AULAGE/dache/docs/robotac/答辩问答.md

# 答辩问答准备（26 题）

> 原则：**不编数据**。有真机数据的照真机数据说；只有仿真的，开口先说“这是仿真”；没测过的就说没测过、打算怎么测。
> 评委最反感“说得比做得多”。被问到不足时，先承认，再讲原因和下一步。
> 数字出处：程序参数见 `raspberrypi/grasp/config.py`；真机数据以 `build/data.json` 填的为准（bench 测完后把下面【】里的补上）。

---

## 一、方案与创新

**1. 你们的核心创新是什么？和普通的视觉伺服有什么区别？**
- 要点：眼在手上 + **在线自适应**。普通做法要先做相机标定、手眼标定，算出图像误差和关节动作的换算关系（雅可比）；我们不做标定，每走一步都用“实际读数变化 ÷ 动作量”更新灵敏度 J，学到的 J 存文件，下次开机接着用。
- 补一句：三个误差方向分给三套执行机构（竖直→升降轴、方位→底座、深度→底盘/伸出插值），每个方向是一维的 J，所以学得快、好解释。
- 相关文献：无标定视觉伺服（Jägersand 1997）是这一思路的经典工作，我们是在低成本移动操作平台上的工程实现。**不要说“首创”**。

**2. 为什么不用强化学习 / 深度学习做控制？**
- 要在真机上试几千次，会撞坏东西；没有足够准的仿真也训练不出来。
- K230 给的本来就是毫米单位的物理量，闭环控制几步就能收敛；简单方法更容易调试、更可靠。
- 学习用在“该学的地方”：执行机构灵敏度（在线）、落点偏差（仿真里实现了从抓取结果学习）。

**3. 和上一版（STM32 主控、偏差分级）比，到底改进了什么？**
- 总控换成树莓派，三套执行机构由一个状态机统一调度；偏差分级的手调阈值换成自适应控制律。
- 相机从【上一版相机位置，请核对】改到腕部；新增抓取确认、自身干扰识别、多重停车保护；升降轴固件重写（最高速度从约 6.8 mm/s 到 80 mm/s，固件默认值）。
- 开发方法：离线自测 + 仿真回归 + 真机测试矩阵。

**4. 为什么把相机装在手腕上？有什么坏处？**
- 好处：相机跟着执行机构一起动，“动一下看一眼”就是闭环，不需要知道相机和底盘的精确相对位置；离物块越近看得越清楚（测距误差和距离平方成正比）。
- 坏处（主动说）：① 爪子会出现在画面里，可能被当成物块 → K230 屏蔽区域 + 树莓派自身干扰检测；② 伸出抓取时物块离相机太近、看不到，所以抓取是“开环”的，靠对准精度和标定的伸出姿态；③ “抬起来看物块跟不跟着动”的确认方法会被爪子骗 → 改成观察确认。

**5. 三套执行机构会不会互相打架？**
- 不会同时修正同一个方向：每个误差方向只交给一个执行机构。
- 底盘转弯会改变视角 → 用几何前馈：按回传的里程和转角直接算出底座该转多少，相机继续对准。
- 每一步只走预测量的 85%（α = 0.85），宁可多一步也不冲过头。

## 二、算法细节

**6. 灵敏度 J 是什么？怎么学的？会不会学坏？**
- J = 单位动作引起的读数变化。每步 Ĵ = Δe / (u·s)，J ← 0.7·J + 0.3·Ĵ（学习率 0.3）。
- 三道保护：动作太小或读数变化小于噪声的 2 倍不学；Ĵ 和初值符号相反（噪声、打滑、换了目标）不学；|Ĵ| 限制在初值的 1/4~4 倍。所以最坏情况是学得慢，不会学反。

**7. 几何系数 s = 1 + R/d 是什么意思？**
- 底座转动时，相机不一定在转轴上，而是绕转轴走一段弧（半径 R）。物块在深度 d 处，底座转 1°，物块在画面里偏 (1 + R/d)°。这部分几何关系程序直接算，J 只学剩下的偏差。
- 真机标定发现相机几乎就在底座转轴上（R≈0）。

**8. 单目怎么测距？准不准？**
- 已知物块边长 L = 24 mm，D = L·f/√(w·h)，f = 944 px。用 √(w·h) 而不是单边长，减小单边抖动的影响。
- 误差理论：ΔD ≈ D²·Δs/(L·f)。150 mm 时 1 px 框误差约 1 mm，300 mm 时约 4 mm（报告表“单目测距理论误差”）。对准时深度在 150~220 mm，误差在对准容差（10 mm）以内。
- 局限：要知道物块尺寸；换物体要换模型和尺寸参数。**没做过系统的测距精度实测**，被问就如实说“做了理论分析，没有专门的测距精度实验”。

**9. 对准容差是多少？为什么这么定？**
- 方位 1.5°、竖直 4 mm、深度 10 mm（程序参数）。爪子张开比物块宽，横向和竖直要求严，深度有伸出姿态插值兜底所以松一些。

**10. 无底盘时深度怎么办？**
- 深度对不准，就按物块的实际深度，在“近、远”两个标定好的伸出姿态之间插值；目标位置也随深度插值（物块越远在画面里越靠上）。可抓深度约 131~241 mm（标定结果）。

**11. 每次测量取几帧？为什么等 0.25 秒？**
- 动作完后相机在机械臂上会晃，等 0.25 s 稳定；取 5 帧中位数（离目标远时取 3 帧，快一些）。中位数能去掉偶发的跳变帧。

## 三、可靠性与安全

**12. K230 串口断了会怎样？**
- K230 没看到物块时也发心跳帧（D = 0）。连心跳都收不到 = 断线或程序停了，树莓派立即报错停止，不会把“断线”当成“没看到”继续乱找。

**13. 爪子被识别成物块怎么办？**
- 两道防线：K230 端中心落在爪子区域的框直接丢掉（OSD 上红色虚线框可现场看）；树莓派端“动了两步读数几乎不变”判定为看到了自己，立即停止（底盘前进的那一步也检查）。
- 如实说：第一天联调时遇到过一次跟踪器锁住爪子的情况，这是加这两道防线的原因。

**14. 底盘失控怎么办？**
- 厂家底盘固件**没有串口超时停车**（读过固件源码确认），最后一帧是什么速度就一直按什么速度走。所以树莓派这边兜底：50 Hz 持续发送、0.5 s 没新命令自动发 0；程序退出、被 kill、SSH 断开都会先发停车帧；底盘回传断了 0.5 s 内停车报错。
- 这些是在上车前代码审查和底盘预演中，用仿真和假串口复现问题后修的，**没有在真机上故意触发过**。

**15. 怎么判断抓没抓到？会不会误报？**
- 爪子保持闭合退回观察姿态，看原位置还有没有物块；有 = 没抓到 → 松开、后退、重试（最多 3 次）。
- 误报情况：【填 bench 的误报次数；没填就说“测试矩阵里统计了误报，结果见表”】。已知风险：如果物块被碰走但没夹住，观察确认也会以为抓到了。

**16. 升降轴会不会撞顶？**
- 软件限位 44 cm（硬件行程 50 cm）；升降轴下位机意外复位后零点可能错，程序收到复位消息就停下等人确认，不自动接着跑。

## 四、测试与数据

**17. 真机成功率是多少？测了多少次？怎么统计的？**
- 按测试矩阵：近/中/远 × 左/中/右 9 个位置，每次抓完由人确认是否真的抓到（程序判定不算）。
- 结果：【填：总次数 N、真实抓到 M、成功率、平均用时，哪些位置差】。
- 已有记录：11 月 3 日第一天联调，低平台无底盘，15 次中抓到 11 次，每次 15~40 秒（未分位置统计）。
- **如果被追问“只测了这么少？”**：如实说比赛前时间有限，测试矩阵每个位置测了几次；统计意义有限，但每次都是人工确认的真实结果，日志都保留着可以现场看。

**18. 报告里的 95%、94% 是真机数据吗？**
- **不是，是仿真**（默认配置、各 100 次，有底盘 95/100、无底盘 94/100）。仿真只用来比较改动前后有没有变差，不代表真机成功率。仿真器的噪声、回差、滑行参数是按真机现象估计的。

**19. 仿真和真机差多少？仿真可信吗？**
- 如实说：仿真里的物理参数是估计的，不能当真机结果。它的价值是回归测试——每次改代码，同一个随机种子下结果不能变差，并且能复现真机上遇到的问题（比如爪子被当成物块、底盘滑行）。
- 第一天真机 11/15（73%），落点偏差模型调好后仿真“不微调”约 70%，量级一致；这只能说明仿真没偏太远，不能证明更多。

**20. 163 项自测测的是什么？**
- 用“假下位机”测所有驱动的协议收发（K230 帧解析和 CRC、升降轴文本协议、底盘 50 Hz 发送与回传解析、机械臂帧打包），以及自适应伺服、几何前馈、自身干扰检测、抓取确认、仿真回归。底盘的假控制器是照着厂家固件源码写的。全部在电脑上跑，不需要硬件。

**21. 一次抓取要多久？时间花在哪？**
- 第一天联调每次 15~40 秒。各阶段：【填 data.json 各阶段用时；没测就说“主要时间在搜索和对准，对准每一步要等画面稳定再取 5 帧”】。
- 限制因素：K230 约 7 帧/s，每一步测量要几帧。

## 五、不足与展望

**22. 为什么不抓地上的东西？题目里不是说“从地面到桌面”吗？**
- 如实说：这一版把相机移到手腕后，升降轴降到最低再加上腕部下压，还是差一截够不到地面（机械结构限制），所以现在只抓台面上的物块。下一步改机械结构（下移安装位置或加长夹爪）。

**23. 底盘参与的全自动抓取做成了吗？**
- 【按 11/9 联调结果回答】。成功：讲视频 ⑧ 和次数。没成功：如实说代码和安全保护都做了、在仿真和假串口里预演过，但真机联调时间不够，演示以无底盘模式为主。

**24. 物块歪着放能抓吗？换别的物体呢？**
- 夹爪不能绕竖直轴转，歪放的物块成功率低（没有系统测过，不报数字）。换物体需要重新训练检测模型、改测距用的尺寸参数，必要时重新标定伸出姿态。

**25. 成本多少？能推广吗？**
- 【请核对：整机成本】。总控程序只依赖 Python 标准库和 pyserial，硬件都是通用件；自适应伺服换车不用重新标定，适合复制到教学平台。

**26. 落点偏右 4 mm 是怎么回事？怎么解决的？**
- 第一天联调发现落点系统性偏右约 4 mm。可能原因：爪子遮住物块左侧让检测框中心偏右，或底座舵机回差。现在用固定微调补偿（底座约 −1.3°）。
- 还实现了“失败时左右试探 + 从结果学习落点偏差”，仿真里（无底盘、10 台车 × 100 次）从 86.1% 到 87.9%，提升很小、在统计误差附近；【比赛版是否启用、真机效果如何，按实际回答】。
