AULAGE/dache/docs/cloud_tasks/10_k230_ignore_claw.md

# 任务 10：K230 忽略爪子脚区域 + 树莓派 ghost 指纹

## 背景
K230（庐山派，CanMV）装在机械臂腕部（2 号舵机那一节），爪子也在这一节上，所以**爪子相对相机永远不动**。
观察姿态下，爪子的一只脚出现在画面**左侧中间**，大约占画面的 1/60（用户 2026-11-03 在 CanMV IDE 里看到的；
画面是旋转 90° 之后的，`ROTATE_DEG = 90`）。

真机现象：K230 程序（`k230_sdcard/main.py`）里的跟踪器 `Tracker` 偶尔把爪子脚当成物块锁住，之后一直跟着它：
- 底座连续转了 69°，方位角读数一直是 +4.2°
- 升降轴累计降了 10cm，Y 读数一直是 +17~19mm
- 平时识别框是在物块上的（问题是间歇性的）

树莓派端（`raspberrypi/grasp/task.py`）已经有 ghost 检测：动了两次读数几乎不变就停止。但这只是止损，这次抓取就废了。

## 目标
### K230 端（`k230_sdcard/main.py`）
1. 新增配置 `IGNORE_REGIONS`：列表，每项是画面里的一个矩形（**用 0~1 的归一化坐标**，基于显示给用户看的那个旋转后的画面，方便用户按 IDE 画面估），
   默认先填一个覆盖"左侧中间、约 1/60 面积"的区域，并加 `IGNORE_REGIONS_ENABLE` 开关（默认开）
2. 在检测结果进跟踪器之前，丢掉**中心落在忽略区域里**的检测框（`tracker.select` 之前）；跟踪器当前锁定的目标如果进入忽略区域，立即放弃
3. 在 OSD 上把忽略区域画出来（半透明或虚线框），用户在 IDE 里一眼能看到区域对不对
4. 加一个标定辅助：配置 `IGNORE_CALIB_MODE = True` 时，在终端持续打印每个检测框的归一化中心和大小，方便用户在没放物块时看爪子脚被识别成什么样、区域该框多大
5. 注意坐标系：检测框在 AI 分辨率（1280×720）下，旋转后才是用户看到的画面。用离线测试固定"归一化区域 ↔ 原始像素"的换算（参考任务 04 的 `k230_sdcard/tests/` 和 `k230_stub.py`）

### 树莓派端（`raspberrypi/grasp/`）
6. **ghost 指纹**：`align` 判定 ghost 时，把当时的读数（x_deg、y、d）记到 `logs/ghosts.json`；之后测量到和某个指纹很接近的读数（容差可配置）就当作没看到，
   并提示"看到的是之前记录的假目标"。开关 `GHOST_FINGERPRINT`（默认关），白名单
7. 不改串口帧格式（`AA 55 | X | Y | D | CRC8 | 0D`，D=0 是心跳），不改 `ROTATE_DEG` 和坐标约定

## 限制
- 云端没有 K230 和 CanMV 环境：K230 代码只能读代码 + 用 CPython 离线测试纯函数（`ulab.numpy` 和 `numpy` 有差异要注意）
- 改动要小、带开关，方便用户在板子上开关对比

## 交付物
- `k230_sdcard/main.py`、`k230_sdcard/tests/` 新测试
- `raspberrypi/grasp/task.py`、`config.py`、`selftest.py` 改动
- `docs/cloud_tasks/results/10_报告.md`：怎么在 IDE 里确认区域、怎么调大小、**真机验证步骤**
  （例：不放物块、观察姿态下张爪/合爪各看 1 分钟，确认终端里没有出现在忽略区域里的目标；再放物块跑 10 次 `--once --no-chassis`，看 ghost 还出不出现）

## 验收
- `k230_sdcard/tests` 和 `raspberrypi/grasp/selftest.py` 全部通过
- 报告标明"未在真机验证"
