AULAGE/dache/docs/cloud_tasks/README.md

# 云端任务

这些任务**都不需要硬件**，适合交给 Claude Code 云端会话长时间自动跑。
每个任务一个文件，把对应文件的内容（或者"请按 docs/cloud_tasks/0X_xxx.md 执行"）发给云端会话即可。

开始前云端会话会先读仓库根目录的 `CLAUDE.md`（项目结构、协议、编码规则、测试方法）。

| # | 任务 | 价值 | 规模 | 需要真机验证吗 |
|---|---|---|---|---|
| 01 | [控制参数自动搜索](01_param_search.md) | ★★★ 直接产出可用的 `calib.json` 推荐值 | 中（主要是跑仿真） | 结果要真机确认 |
| 02 | [仿真更真实](02_sim_fidelity.md) | ★★★ 让 01 的结果更可信 | 中 | 否 |
| 03 | [底盘固件分析](03_chassis_firmware.md) | ★★ 查清速度平滑、超时、回传字段，改进底盘驱动 | 小 | 改进要真机确认 |
| 04 | [K230 程序审查与提速](04_k230_review.md) | ★★ 帧率是整套系统的瓶颈 | 中 | **必须**真机确认 |
| 05 | [机械臂逆运动学](05_arm_ik.md) | ★★ 不用插值也能抓，范围更大 | 大 | 需要连杆尺寸 |
| 06 | [激光雷达避障探索（设计+仿真）](06_lidar_explore.md) | ★ 以后让车自己往前开去找 | 大 | 必须 |
| 07 | [机械臂最省力的上电姿态（静力学模型）](07_power_on_pose.md) | ★★ 上电不抖、不发热 | 中 | 必须；先填 `inputs/arm_params.json` |
| 08 | [真机试验记录工具 bench.py](08_bench_tool.md) | ★★★ 记录真实结果、按位置统计偏差 | 小 | 工具本身离线可测 |
| 09 | [抓取精度：消回差、左右试探、从结果学习落点偏差、三点插值](09_grasp_accuracy.md) | ★★★ 解决"偏右"和小角度不到位 | 中 | 必须 |
| 10 | [K230 忽略爪子脚区域 + ghost 指纹](10_k230_ignore_claw.md) | ★★★ 解决跟踪器锁住爪子脚 | 中 | 必须 |
| 11 | [动作-响应模型原型（论文核心算法仿真验证）](11_action_response_prototype.md) | ★★★ 论文的概率基线 / 物理先验，见 `docs/论文研究方案.md` v2 | 中 | 只建新文件，可和 08/09/10 并行 |
| 12 | [K230 存图 + 树莓派同步（数据集基础设施）](12_k230_image_logging.md) | ★★★ 论文数据集的图像部分 | 中 | 需要用户加一根同步线（GPIO4） |
| 13 | [抓取提速 + 确认防误报 + 灵敏度学习去偏](13_grasp_speed_verify.md) | ★★★ 每次快几秒、消除"推开当抓到" | 中 | 必须 |
| 14 | [世界模型原型：合成腕部图像上验证"学出本体感知"](14_world_model_synthetic.md) | ★★★ 论文 H1/H2 的第一组结果 | 大 | 需要 torch；CPU 能跑 |
| 15 | [论文文献调研 + 创新点核查 + 期刊分析](15_literature_review.md) | ★★★ 写论文前必须做 | 中 | 只写文档，需要联网 |
| 16 | [比赛演示模式 + 实时网页看板](16_demo_dashboard.md) | ★★★ 拍视频、答辩现场展示 | 中 | 11/14 比赛用 |
| 17 | [上车前代码审查](17_code_review.md) | ★★★ 明天真机前排雷 | 中 | 只修会伤硬件 / 会报错退出的 |
| 18 | [底盘联调预演 + 分步手册](18_chassis_rehearsal.md) | ★★ 11/6 上底盘用 | 中 | 必须 |
| 19 | [比赛材料生成：设计报告 + 答辩 PPT + 概要表（数据驱动，可一键重建）](19_competition_materials.md) | ★★★ 11/14 交材料 | 大 | 模板在 docs/robotac/templates |

**进度**：02、03、04 已完成并合并。**08 已完成并合并**（三个会话都做了 08，采用 `claude/peaceful-turing-w4f9l8` 那份：换行没被改、对原代码改动最小）。09、10、11 也已完成并合并（2026-11-03 晚）。**下一批（2026-11-04）：12、13、14、15 并行**（改的文件互不重叠：12 = K230 程序 + recorder.py；13 = task/config/sim/selftest；14 = research/worldmodel/ 新目录；15 = 只写文档），依据是第一天真机联调（见 `docs/抓取与调试方案.md`）。
01 参数搜索等 09 合并后再做（09 会改仿真的机械爪模型）；05、06、07 不急。

## 给每个任务的通用要求

- 在新分支上做（例如 `cloud/01-param-search`），**不要直接改 main**，完成后开 PR 或者把分支推上来
- 改了 `raspberrypi/grasp/` 就必须跑 `python3 selftest.py`，全部 ✅
- 产出一份中文报告 `docs/cloud_tasks/results/0X_报告.md`：做了什么、数据、结论、**哪些还没在真机验证**
- 不改通信协议、串口、波特率；新功能用 `config.py` 开关控制，默认保持原行为
- STM32 源码是 GBK + CRLF，别转换编码和换行
