AULAGE/dache/docs/论文文献调研.md

# 论文文献调研 + 创新点核查 + 投稿期刊分析（任务 15）

> 对应方案：`docs/论文研究方案.md`（v2，2026-11-03）。分支 `cloud/15-literature`，只写文档，没有改代码和方案。
> 日期：2026-11-03。配套文件：`docs/论文相关工作草稿.md`（相关工作章节草稿）、`docs/references.bib`（只收已核实条目）。

---

## 0 先说清楚：这次是怎么"核实"的（重要）

本次云端会话的网络策略**拦截了 arxiv.org、semanticscholar、openreview 等站点**，`WebFetch` 直接打开原文页面全部失败，
只能用网络搜索工具。所以这里的"核实"**不是读了全文**，而是：

| 标记 | 含义 |
|---|---|
| ✅ 检索核实 | 搜索结果里出现了**原文所在页面**（arXiv 摘要页/PDF、出版社或会议论文集页面、作者单位或官方项目页），标题、作者（至少第一作者）、年份、出处与该页面一致，摘要中的关键句与"一句话贡献"一致。**未读全文** |
| ⚠️ 部分核实 | 只找到二手来源（新闻稿、大学镜像 PDF、引用列表、第三方聚合站），或作者表/出处没对上、不完整 |
| ❌ 未核实 | 没找到能对应的原文页面，只是线索，**不能引用** |

**写论文前必须做的事**：在能上 arXiv / IEEE Xplore 的电脑上，把下表每篇**打开全文**再读一遍，
尤其是第 3 节"创新点核查"里被判为"已做过/部分做过"的最接近工作（NJF、DIJE、Hu 2025、OA-WAM、
"Do You Need Proprioceptive States"、Fiducial Exoskeletons、Park 2024），确认它们**没有**做本文要做的那部分。
文中凡是"据检索未找到"的判断，只代表本次搜索范围内没找到，不等于"没人做过"。

> 如果想让云端会话下次能直接打开原文：在环境设置的 Network access 里把 `arxiv.org`、`export.arxiv.org`、
> `api.semanticscholar.org`、`openreview.net`、`ieeexplore.ieee.org` 加进 Allowed domains
> （说明见 https://code.claude.com/docs/en/cloud-environments#network-access ）。

---

## 1 结论速览（先看这个）

1. **方案第 1 节的一个说法要改**："VLA 几乎都把关节角度当作输入"**不准确**。RT-1/RT-2/OpenVLA 的输入只有图像 + 语言
   （OpenVLA 论文自己写了"单图、没有本体感知输入"是局限），它们输出离散化的末端位姿增量，由机器人自带的、**依赖编码器的低层控制器**执行；
   π0、ACT、Diffusion Policy 才把本体状态作为输入。正确的说法是：**它们要么吃本体感知，要么默认低层执行准确（编码器闭环），两者都不适用于无反馈、有回差的舵机臂**。
2. **"去掉本体感知输入"本身已经有人做了**：Zhao 等 2025（arXiv 2509.18644）提出 State-free Policy，在 π0/ACT/DP 上去掉本体状态输入反而泛化更好。
   但他们的机器人**有准确执行**（相对末端位姿动作由带编码器的控制器执行）。本文的区别要落在"**连执行都不可信**（回差/死区）"上，而不是"不输入关节角"。
3. **"只靠视觉 + 随机命令学会控制自己"已有 Nature 级工作**：Li 等 2025 Nature（Neural Jacobian Fields）不假设机器人的运动学、驱动和传感，
   用多相机看随机命令执行来学控制；Hu/Lin/Lipson 2025 NMI、Chen 2022 Sci. Robot. 用外部相机学自我模型；
   Hu/Chen/Lipson（npj Robotics 2025）甚至用**第一人称相机**学动力学自我模型（四足，非抓取）。
   ⇒ "动作是唯一可信信号、自监督学身体"**作为思想不是新的**，不能当主创新点。
4. **"自身/世界分离"有很长的历史**：Gold & Scassellati 2009（靠"受不受电机控制"自我识别）、DIJE 2025（逐像素雅可比分辨自身/外部运动，**但用了关节传感器读数**、外部相机）、
   世界模型里的 Iso-Dream / Denoised MDP / ACRO（可控/不可控隐变量分离）、OA-WAM 2026（一个机器人槽 + N 个物体槽）。
   **没找到**的是：**眼在手上**（身体部件在画面里静止、世界随动作动——和常见设定正好反过来）+ **无本体感知**（预测的世界运动必须来自学到的执行器模型）下的分离。
5. **最站得住的空白**：**从图像自监督地学执行器迟滞（回差/死区）并把它当作"视觉本体感知"**。检索到的迟滞学习工作要么用关节传感器（ac-RKN、Hwangbo 执行器网络），
   要么用外部 RGBD 测末端（Park 等 RA-L 2024，连续体/缆驱机器人），**没找到**"无关节传感器 + 眼在手上 + 刚性舵机臂回差 + 世界模型"的组合（扩展检索也没找到）。
   ⇒ 建议把论文主线收窄为 **H1（迟滞感知的视觉本体感知）+ H2（眼在手上的自身/世界分离）**，世界模型规划（H3）作下游应用。
6. **期刊**：第一篇（H1+H2，短而准）建议 **RA-L**（官网：首次决定 3 个月内、终稿 6 页不收费，可选 ICRA/IROS 报告）；
   完整系统再投 **T-RO / T-Mech / T-ASE**；**TII 范围不太匹配**（工业信息学），不推荐作首选。IEEE TCDS（认知与发育系统）适合"自我建模"叙事，可作备选。
   分区只查到第三方页面，**投稿前必须到中科院/JCR 官方核对**（见第 4 节）。

---

## 2 文献表

列说明：**关系** = 和本文的关系（支持/对比/基线/空白）；**核实** 见第 0 节。
"一句话贡献"根据检索到的摘要/官方页面写，**不是读全文后的总结**。

### 2.1 视觉-语言-动作模型、模仿学习（重点：对本体感知的依赖）

| # | 标题 | 作者 | 年份 | 出处 | 链接 | 一句话贡献 | 和本文关系 | 核实 |
|---|---|---|---|---|---|---|---|---|
| L01 | RT-1: Robotics Transformer for Real-World Control at Scale | Brohan, A. 等 | 2022 | arXiv | https://arxiv.org/abs/2212.06817 | 13 万条真机示教训练的 Transformer 策略；动作每维离散成 256 档（7 维臂：x,y,z,roll,pitch,yaw,夹爪；3 维底盘；1 维模式） | 输入图像+语言，**不吃关节角**，但输出末端位姿增量由机器人控制器执行 → 默认执行准确 | ✅（作者表未逐一核对） |
| L02 | RT-2: Vision-Language-Action Models Transfer Web Knowledge to Robotic Control | Brohan, A. / Zitkovich, B. 等（各版本排序不同） | 2023 | CoRL 2023, PMLR 229 | https://arxiv.org/abs/2307.15818 | 把动作当作文本 token 和网络图文数据联合训练，得到 VLA；沿用 RT-1 的 256 档动作 | 同上：不吃本体感知，但默认执行准确 | ✅ |
| L03 | OpenVLA: An Open-Source Vision-Language-Action Model | Kim, M. J., Pertsch, K., Karamcheti, S. 等 | 2024 | CoRL 2024 | https://arxiv.org/abs/2406.09246 | 7B 开源 VLA（Llama 2 + DINOv2/SigLIP）；论文自述"只用单张图像、无本体感知输入"是局限 | 修正方案第 1 节的说法：VLA 不一定吃本体感知 | ✅ |
| L04 | π0: A Vision-Language-Action Flow Model for General Robot Control | Black, K. 等（Physical Intelligence） | 2024 | arXiv | https://arxiv.org/abs/2410.24164 | 观测 = 多路图像 + 语言 + **本体状态**；状态和动作 token 走单独的"动作专家"权重，flow matching 出动作 | 典型"本体感知是一等输入"的 VLA，可作 H3 对比（去掉状态输入） | ✅（作者表未逐一核对） |
| L05 | Octo: An Open-Source Generalist Robot Policy | Octo Model Team（Ghosh, D., Walke, H., Pertsch, K. 等） | 2024 | RSS 2024 | https://arxiv.org/abs/2405.12213 | 80 万条 OXE 轨迹预训练的开源通用策略，可微调到新观测（含本体感知）和新动作空间 | 可选基线；说明本体感知在通用策略里是"可选输入" | ✅ |
| L06 | Learning Fine-Grained Bimanual Manipulation with Low-Cost Hardware（ACT / ALOHA） | Zhao, T. Z. 等 | 2023 | RSS 2023 | https://arxiv.org/abs/2304.13705 | 低成本双臂遥操作平台 ALOHA + 动作分块 Transformer（ACT），10 分钟示教达到 80~90% | H3 基线；"低成本"但**有关节位置反馈**（两台 ViperX 6 自由度臂，据二手资料），输入含关节位置（据二手资料，需读原文第 III 节确认） | ✅（输入细节未从原文核对） |
| L07 | Diffusion Policy: Visuomotor Policy Learning via Action Diffusion | Chi, C., Feng, S., Du, Y. 等 | 2023/2024 | RSS 2023；IJRR 2024 | https://arxiv.org/abs/2303.04137 | 把策略写成条件去噪扩散过程，处理多峰动作 | H3 基线 | ✅ |
| L08 | Do You Need Proprioceptive States in Visuomotor Policies? | Zhao, J., Lu, W., Zhang, D. 等（13 人） | 2025 | arXiv | https://arxiv.org/abs/2509.18644 | 发现加本体状态让策略过拟合训练轨迹；去掉状态（State-free Policy，相对末端动作 + 双腕部广角相机）后高度泛化 0%→85%，在 π0/ACT/DP 上都成立 | **最接近"不用本体感知"的模仿学习工作**；区别：他们执行准确，本文执行不可信 | ✅ |
| L09 | Fighting Copycat Agents in Behavioral Cloning from Observation Histories | Wen, C., Lin, J., Darrell, T., Jayaraman, D., Gao, Y. | 2020 | NeurIPS 2020 | https://papers.nips.cc/paper/2020/hash/1b113258af3968aaf3969ca67e744ff8-Abstract.html | 带历史的行为克隆会"抄上一步动作"（copycat），提出对抗表示去掉多余的前一动作信息 | 警示：本文的迟滞 GRU 输入**命令历史**，训练策略时同样有 copycat 风险，要做消融 | ✅ |
| L10 | Open X-Embodiment: Robotic Learning Datasets and RT-X Models | Open X-Embodiment Collaboration | 2024 | ICRA 2024 | https://arxiv.org/abs/2310.08864 | 22 种机器人、100 万+ 轨迹的合并数据集，训练 RT-X | "首个无本体感知数据集"说法要对照它（见 3.9） | ✅ |
| L11 | DROID: A Large-Scale In-The-Wild Robot Manipulation Dataset | Khazatsky, A., Pertsch, K. 等 | 2024 | RSS 2024 | https://arxiv.org/abs/2403.12945 | 7.6 万条（RSS 页写 6.5 万）野外 Franka 轨迹，三路同步相机 + 标定 + 深度 | 同上；高端臂、带完整状态 | ✅ |
| L12 | Mobile ALOHA: Learning Bimanual Mobile Manipulation with Low-Cost Whole-Body Teleoperation | Fu, Z., Zhao, T. Z., Finn, C. | 2024 | CoRL 2024, PMLR 270 | https://arxiv.org/abs/2401.02117 | ALOHA 装到轮式底盘上做全身遥操作；与静态 ALOHA 数据联合训练提升移动操作 | 低成本**移动**操作的代表；仍有编码器（整机约 3.2 万美元，据新闻稿） | ✅ |

### 2.2 世界模型（Dreamer、TD-MPC、视频预测类）

| # | 标题 | 作者 | 年份 | 出处 | 链接 | 一句话贡献 | 和本文关系 | 核实 |
|---|---|---|---|---|---|---|---|---|
| L13 | Learning Latent Dynamics for Planning from Pixels（PlaNet） | Hafner, D. 等 | 2019 | ICML 2019 | https://arxiv.org/abs/1811.04551 | 确定性+随机隐状态动力学（RSSM 雏形），隐空间在线规划 | 隐空间 CEM 规划的来源；**RSSM 的确定性隐状态本身就有记忆**——审稿人会问"迟滞 GRU 和它有何不同" | ✅ |
| L14 | Dream to Control: Learning Behaviors by Latent Imagination（Dreamer） | Hafner, D., Lillicrap, T., Ba, J., Norouzi, M. | 2020 | ICLR 2020 | https://arxiv.org/abs/1912.01603 | 在学到的隐空间里想象轨迹训练 actor-critic | H3 基线（无结构先验） | ✅ |
| L15 | Mastering diverse control tasks through world models（DreamerV3） | Hafner, D., Pasukonis, J., Ba, J., Lillicrap, T. | 2025 | Nature（arXiv 2301.04104 题为 Mastering Diverse Domains through World Models） | https://arxiv.org/abs/2301.04104 | 单一配置在 150+ 任务上超过专用方法 | H3 基线首选（开源、稳定） | ✅ |
| L16 | DayDreamer: World Models for Physical Robot Learning | Wu, P., Escontrela, A., Hafner, D., Abbeel, P., Goldberg, K. | 2022/2023 | CoRL 2022, PMLR 205 | https://arxiv.org/abs/2206.14176 | Dreamer 直接在 4 台真机上在线学习，无仿真器 | 证明真机世界模型可行；它的机器人都有本体感知 | ✅ |
| L17 | Temporal Difference Learning for Model Predictive Control（TD-MPC） | Hansen, N., Wang, X., Su, H. | 2022 | ICML 2022, PMLR 162 | https://arxiv.org/abs/2203.04955 | 任务导向隐动力学 + 终端价值函数做短视距 MPC | H3 基线 | ✅ |
| L18 | TD-MPC2: Scalable, Robust World Models for Continuous Control | Hansen, N., Su, H., Wang, X. | 2024 | ICLR 2024 | https://arxiv.org/abs/2310.16828 | 无解码器隐空间规划，104 个任务单一超参 | H3 基线 | ✅ |
| L19 | Deep Visual Foresight for Planning Robot Motion | Finn, C., Levine, S. | 2016/2017 | arXiv（ICRA 2017，出处未从原页核实） | https://arxiv.org/abs/1610.00696 | 动作条件视频预测 + MPC 推物体，**不需要标定相机、不需要精确传感与执行** | 视频预测类世界模型的源头；"不需要精确执行"这一点与本文相关，但没有显式建模迟滞 | ✅ |
| L20 | Visual Foresight: Model-Based Deep RL for Vision-Based Robotic Control | Ebert, F., Finn, C., Dasari, S., Xie, A., Lee, A., Levine, S. | 2018 | arXiv | https://arxiv.org/abs/1812.00568 | 视频预测模型 + 采样规划（visual MPC）的系统总结 | 同上 | ✅ |
| L21 | Learning Interactive Real-World Simulators（UniSim） | Yang, M., Du, Y., Ghasemipour, K., Tompson, J., Schuurmans, D., Abbeel, P. | 2024 | ICLR 2024 | https://arxiv.org/abs/2310.06114 | 动作条件的生成式视频模拟器，训练的策略零样本迁移到真机 | 视频预测类代表；本文是小模型、边缘部署，不和它比规模 | ✅ |
| L22 | DINO-WM: World Models on Pre-trained Visual Features enable Zero-shot Planning | Zhou, G., Pan, H., LeCun, Y., Pinto, L. | 2025 | ICML 2025, PMLR 267 | https://arxiv.org/abs/2411.04983 | 在冻结的 DINOv2 patch 特征上学动力学，测试时零样本规划 | 编码器可以用预训练特征的证据（本文槽位编码器的备选） | ✅ |
| L23 | Iso-Dream: Isolating and Leveraging Noncontrollable Visual Dynamics in World Models | Pan, M., Zhu, X., Wang, Y., Yang, X. | 2022 | NeurIPS 2022 | https://arxiv.org/abs/2205.13817 | 用逆动力学把可控/不可控动态分到两个分支 | **自身/世界分离的最接近世界模型工作之一**；它分的是"可控/不可控"，不是"与相机固连/随相机运动" | ✅ |
| L24 | Denoised MDPs: Learning World Models Better Than the World Itself | Wang, T., Du, S. S., Torralba, A., Isola, P., Zhang, A., Tian, Y. | 2022 | ICML 2022, PMLR 162 | https://proceedings.mlr.press/v162/wang22c/wang22c.pdf | 按"可控 × 与奖励相关"把信息分四类，只保留两者都有的 | 同上 | ✅ |
| L25 | Principled Offline RL in the Presence of Rich Exogenous Information（ACRO；arXiv 题 Agent-Controller Representations） | Islam, R., Tomar, M., Lamb, A. 等 | 2023 | ICML 2023, PMLR 202 | https://arxiv.org/abs/2211.00164 | 多步逆模型学"智能体可控状态"，去掉外生噪声 | 同上；思路可借鉴为"动作可解释的部分" | ✅ |
| L26 | Action-Conditional Recurrent Kalman Networks for Forward and Inverse Dynamics Learning | Shaj, V. 等 | 2020 | CoRL 2020, PMLR 155 | https://arxiv.org/abs/2010.10201 | 动作条件的循环卡尔曼网络学正/逆动力学，在液压臂（**有迟滞**）上大幅优于解析模型 | **"循环隐状态学迟滞"最接近的工作**；但输入是关节位置测量 + 电流，**有本体感知** | ✅ |

### 2.3 机器人自我建模 / 自我识别

| # | 标题 | 作者 | 年份 | 出处 | 链接 | 一句话贡献 | 和本文关系 | 核实 |
|---|---|---|---|---|---|---|---|---|
| L27 | Resilient Machines Through Continuous Self-Modeling | Bongard, J., Zykov, V., Lipson, H. | 2006 | Science 314(5802):1118–1121 | https://doi.org/10.1126/science.1133687 | 四足机器人通过少量自主动作推断自身拓扑，受损后重建步态 | "通过自主动作学身体"思想的源头 | ⚠️（只找到新闻和实验室页面，DOI 来自二手页面） |
| L28 | Task-agnostic self-modeling machines | Kwiatkowski, R., Lipson, H. | 2019 | Science Robotics 4, eaau9354 | https://doi.org/10.1126/scirobotics.eaau9354 | 4 自由度臂随机运动约 1000 条轨迹学自我模型，闭环抓放 100%、开环 44% | 同上；有关节读数 | ⚠️（只找到哥大新闻稿） |
| L29 | Full-Body Visual Self-Modeling of Robot Morphologies | Chen, B., Kwiatkowski, R., Vondrick, C., Lipson, H. | 2022 | Science Robotics（DOI 10.1126/scirobotics.abn1944）；arXiv 2111.06389 | https://robot-morphology.cs.columbia.edu/ | 5 台外部相机，学"给定关节状态时身体占据哪些空间"的查询式自我模型 | 外部相机 + 以关节状态为条件 → 有本体感知；本文是眼在手上、无本体感知 | ✅ |
| L30 | Teaching Robots to Build Simulations of Themselves | Hu, Y., Lin, J., Lipson, H. | 2025 | Nature Machine Intelligence；arXiv 2311.12151 | https://arxiv.org/abs/2311.12151 | 单个普通 2D 相机看短视频，自监督学形态、运动学和运动控制 | 外部相机的自我建模 | ✅ |
| L31 | Egocentric Visual Self-Modeling for Autonomous Robot Dynamics Prediction and Adaptation | Hu, Y., Chen, B., Lipson, H. | 2025 | npj Robotics 3:14（据第三方 PDF）；arXiv 2207.03386 | https://arxiv.org/abs/2207.03386 | **单个第一人称相机**、随机运动，自监督学"以电机命令为条件"的动力学自我模型，12 自由度四足；精度超过用 IMU 的模型 | **"第一人称相机 + 命令条件自我模型"已被做过**（但是腿式移动、没有抓取、没有迟滞建模） | ✅（arXiv）；npj 版本 ⚠️ |
| L32 | Controlling diverse robots by inferring Jacobian fields with deep networks（Neural Jacobian Fields） | Li, S. L., Zhang, A., Chen, B., Matusik, H., Liu, C., Rus, D., Sitzmann, V. | 2025 | Nature（DOI 10.1038/s41586-025-09170-0）；arXiv 2407.08722 | https://arxiv.org/abs/2407.08722 | 从视频流学"视觉运动雅可比场"，**不假设运动学、材料、驱动、传感**；训练数据来自观察随机命令的执行；用于软硬混合手等 | **最接近"无本体感知 + 只靠视觉和命令学控制"的工作**；区别：外部多相机、不显式建模回差的历史依赖、不是眼在手上 | ✅ |
| L33 | DIJE: Dense Image Jacobian Estimation for Robust Robotic Self-Recognition and Visual Servoing | Toshimitsu, Y., Kawaharazuka, K., Miki, A., Okada, K., Inaba, M. | 2025 | arXiv | https://arxiv.org/abs/2507.00446 | 光流 + 简化卡尔曼滤波逐像素估计图像雅可比，区分机器人自身运动和外部运动，用于视觉伺服（肌肉骨骼机器人） | H2 基线；**它用了本体关节传感器读数**（摘要原话 "proprioceptive joint sensor data"），外部视角 | ✅ |
| L34 | Using Probabilistic Reasoning over Time to Self-Recognize | Gold, K., Scassellati, B. | 2009 | Robotics and Autonomous Systems 57(5):384–392 | https://scazlab.yale.edu/journal-articles | 比较三个动态贝叶斯模型的似然，判断画面里的东西是否受自己电机控制，从而认出自己（含镜像） | **v1 概率模型 P(T/S/D) 的直接前身**，必须引用；区别：外部视角、有关节信息 | ⚠️（Yale 实验室页 + 非官方 PDF 副本，未见出版社页） |
| L35 | Adaptive Robot Body Learning and Estimation Through Predictive Coding | Lanillos, P., Cheng, G. | 2018 | IROS 2018, pp. 4083–4090 | https://arxiv.org/abs/1805.03104 | 高斯过程学身体前向模型，最小化自由能估计身体状态（视觉+触觉+本体感知） | 身体估计的预测编码路线 | ✅ |
| L36 | Body Schema in Robotics: A Review | Hoffmann, M., Marques, H. G., Arieta, A. H., Sumioka, H., Lungarella, M., Pfeifer, R. | 2010 | IEEE Trans. Autonomous Mental Development 2(4):304–324 | https://doi.org/10.1109/TAMD.2010.2086454 | 身体图式在生物与机器人中的综述 | 背景综述（TAMD 是 TCDS 的前身） | ⚠️（只找到大学镜像 PDF） |
| L37 | Single-view robot pose and joint angle estimation via render & compare（RoboPose） | Labbé, Y., Carpentier, J., Aubry, M., Sivic, J. | 2021 | CVPR 2021 | https://www.di.ens.fr/willow/research/robopose/ | 单张 RGB 估计已知机器人的关节角和相机位姿 | "视觉本体感知"的外部相机路线；需要机器人 3D 模型 | ✅ |
| L38 | Robust Visual Embodiment: How Robots Discover Their Bodies in Real Environments | Rezvani, S., Mahmood, A. J., Chhabra, R. | 2025 | arXiv | https://arxiv.org/abs/2510.03677 | 运动分割 + 语义分割在杂乱场景中找出机器人身体，IoU 最多提升 4 倍 | 真实场景自身分割；外部视角 | ✅ |
| L39 | Where is my hand? Deep hand segmentation for visual self-recognition in humanoid robots | Almeida, A., Vicente, P., Bernardino, A. | 2021 | arXiv（期刊出处未查到） | https://arxiv.org/abs/2102.04750 | 深度分割网络在人形机器人头部相机里识别自己的手 | 自身识别；监督分割 | ✅ |
| L40 | Proprioceptive-visual correspondence enables self-other distinction in humanoid robots | Chen, Y. 等（作者表来自 alphaXiv） | 2026 | arXiv | https://arxiv.org/abs/2606.13222 | 用本体感知-视觉对应做自他区分，并以此自监督地引导出自我模型 | 很新、很接近 H2，**但依赖本体感知** | ⚠️（作者表未从 arXiv 页核对） |
| L41 | Self-Supervised Object-in-Gripper Segmentation from Robotic Motions | Boerdijk, W., Sundermeyer, M., Durner, M., Triebel, R. | 2020 | CoRL 2020, PMLR 155 | https://arxiv.org/abs/2002.04487 | 机器人拿着物体在相机前运动，用光流等运动线索自监督分出背景/机械臂/被抓物体 | 用"自身运动"做分割的直接先例（外部相机） | ✅ |

### 2.4 物体中心表示（Slot Attention 及机器人应用）

| # | 标题 | 作者 | 年份 | 出处 | 链接 | 一句话贡献 | 和本文关系 | 核实 |
|---|---|---|---|---|---|---|---|---|
| L42 | Object-Centric Learning with Slot Attention | Locatello, F., Weissenborn, D., Unterthiner, T., Mahendran, A., Heigold, G., Uszkoreit, J., Dosovitskiy, A., Kipf, T. | 2020 | NeurIPS 2020 | https://arxiv.org/abs/2006.15055 | 竞争式迭代注意力把特征分配到 K 个槽位 | 方案 3.2 编码器 | ✅ |
| L43 | Conditional Object-Centric Learning from Video（SAVi） | Kipf, T. 等 | 2022 | ICLR 2022 | https://arxiv.org/abs/2111.12594 | 视频版 Slot Attention，光流预测 + 首帧位置提示做分割与跟踪 | 槽位时序跟踪；"首帧提示"可用于指定爪子槽 | ✅ |
| L44 | Contrastive Learning of Structured World Models（C-SWM） | Kipf, T., van der Pol, E., Welling, M. | 2020 | ICLR 2020 | https://arxiv.org/abs/1911.12247 | 对比损失训练的物体级动作条件世界模型（GNN），不靠像素重建 | 方案 3.2 的"对比损失"可直接借鉴 | ✅ |
| L45 | FOCUS: Object-Centric World Models for Robotics Manipulation | Ferraro, S., Mazzaglia, P., Verbelen, T., Dhoedt, B. | 2023/2025 | NeurIPS 2023 IMOL 研讨会；Frontiers in Neurorobotics 2025 | https://arxiv.org/abs/2307.02427 | 物体中心世界模型 + 物体级探索奖励，有 Franka 真机演示 | 物体中心世界模型在机器人上的先例 | ✅ |
| L46 | SOLD: Slot Object-Centric Latent Dynamics Models for Relational Manipulation Learning from Pixels | Mosbach, M., Ewertz, J. N., Villar-Corrales, A., Behnke, S. | 2025 | ICML 2025, PMLR 267 | https://arxiv.org/abs/2410.08822 | 槽位隐动力学的模型强化学习，多物体仿真操作上超过 DreamerV3 和 TD-MPC2 | **方案 3.2 结构上已被做过**（仿真）；本文的区别只能在"自身/世界先验 + 迟滞 + 真机无本体感知" | ✅ |
| L47 | Is an object-centric representation beneficial for robotic manipulation? | Chapin, A., Dellandrea, E., Chen, L. | 2025 | ROBOVIS 2025 | https://arxiv.org/abs/2506.19408 | 比较物体中心与全局表示；槽位能分出背景、机器人和物体 | 槽位里"机器人"会自然成为一个槽的证据 | ✅ |
| L48 | OA-WAM: Object-Addressable World Action Model for Robust Robot Manipulation | Liu, Y., Ding, W. 等（10 人） | 2026 | arXiv | https://arxiv.org/abs/2605.06481 | 每帧分解为 1 个机器人槽 + N 个物体槽，世界头预测下一帧槽状态，同时输出动作块；感知模块用冻结的 SAM 3 / DINOv3 | **"机器人槽/物体槽"结构已被做过**；区别：它用大模型分割、外部视角、无迟滞 | ✅（摘要；数字来自聚合站未核） |
| L49 | Slot-MPC: Goal-Conditioned Model Predictive Control with Object-Centric Representations | （作者未查到） | 2026 | arXiv | https://arxiv.org/abs/2605.14937 | 槽位动作条件动力学 + MPC（仿真） | 槽位 + MPC 已有人做 | ⚠️（只有标题和摘要片段） |

### 2.5 交互式感知、自监督机器人学习

| # | 标题 | 作者 | 年份 | 出处 | 链接 | 一句话贡献 | 和本文关系 | 核实 |
|---|---|---|---|---|---|---|---|---|
| L50 | Interactive Perception: Leveraging Action in Perception and Perception in Action | Bohg, J., Hausman, K., Sankaran, B., Brock, O., Kragic, D., Schaal, S., Sukhatme, G. | 2017 | IEEE T-RO 33:1273–1291 | https://arxiv.org/abs/1604.03670 | 交互式感知综述：利用"传感数据和动作参数之间的规律"解释感知 | 本文"以动作为测量"的理论归属 | ✅ |
| L51 | Learning to Poke by Poking: Experiential Learning of Intuitive Physics | Agrawal, P., Nair, A., Abbeel, P., Malik, J., Levine, S. | 2016 | arXiv（NeurIPS 2016，出处未从原页核实） | https://arxiv.org/abs/1606.07419 | Baxter 随机戳物体 5 万+ 次，联合学正/逆模型 | 自主探索数据收集的先例 | ✅ |
| L52 | Supersizing Self-supervision: Learning to Grasp from 50K Tries and 700 Robot Hours | Pinto, L., Gupta, A. | 2016 | ICRA 2016, pp. 3406–3413 | https://arxiv.org/abs/1509.06825 | 5 万次试抓的自监督抓取数据 | 抓取成败作自监督标签的先例 | ✅ |
| L53 | Learning Hand-Eye Coordination for Robotic Grasping with Deep Learning and Large-Scale Data Collection | Levine, S. 等 | 2016/2018 | ISER 2016 扩展版；arXiv（IJRR 2018 未核实） | https://arxiv.org/abs/1603.02199 | 80 万次抓取学"动作成功概率"网络并用于伺服，**不依赖相机标定和当前位姿** | 方案"奖励头 + 规划"的先例；但机械臂执行准确 | ✅ |
| L54 | Learning Instance Segmentation by Interaction | Pathak, D., Shentu, Y., Chen, D., Agrawal, P., Darrell, T., Levine, S., Malik, J. | 2018 | CVPR Workshops 2018 | https://arxiv.org/abs/1806.08354 | 机器人推/抓物体，自监督学实例分割 | 交互式分割；本文是**不碰物体**、只靠自身运动 | ✅ |
| L55 | Curiosity-driven Exploration by Self-supervised Prediction | Pathak, D., Agrawal, P., Efros, A. A., Darrell, T. | 2017 | ICML 2017 | https://arxiv.org/abs/1705.05363 | 用逆动力学特征空间里的预测误差作好奇心奖励 | 方案 3.1 好奇心探索 | ✅ |
| L56 | Robot Learning in Homes: Improving Generalization and Reducing Dataset Bias | Gupta, A., Murali, A., Gandhi, D., Pinto, L. | 2018 | NeurIPS 2018 | https://arxiv.org/abs/1807.07049 | 低于 3000 美元的移动机械臂在家里采 2.8 万次抓取；**把"执行不准、标定误差"带来的标签噪声建模成隐变量** | **低成本 + 执行噪声当隐变量**的重要先例，必须引用并区分（它是整体噪声，不是有历史依赖的迟滞） | ✅ |

### 2.6 无标定视觉伺服、在线雅可比估计、回差辨识与补偿

| # | 标题 | 作者 | 年份 | 出处 | 链接 | 一句话贡献 | 和本文关系 | 核实 |
|---|---|---|---|---|---|---|---|---|
| L57 | Versatile Visual Servoing without Knowledge of True Jacobian | Hosoda, K., Asada, M. | 1994 | IROS 1994, vol.1 pp.186–193 | https://doi.org/10.1109/IROS.1994.407392 | 在线估计图像雅可比的无标定视觉伺服（后人引为 Broyden/加权递推最小二乘） | 现系统 `servo.AdaptiveAxis` 的理论来源 | ⚠️（只找到引用列表） |
| L58 | Experimental Evaluation of Uncalibrated Visual Servoing for Precision Manipulation | Jägersand, M., Fuentes, O., Nelson, R. | 1997 | ICRA 1997, vol.4 pp.2874–2880 | https://www.cs.rochester.edu/users/faculty/nelson/pubs/abstracts/1997_icra_servo.html | 3/6/12 自由度下在线估计雅可比的自适应视觉伺服实验评估 | 同上 | ✅ |
| L59 | Uncalibrated Dynamic Visual Servoing | Piepmeier, J. A., McMurray, G. V., Lipkin, H. | 2004 | IEEE Trans. Robot. Autom. 20(1):143–147 | https://repository.gatech.edu/entities/publication/8d3fd830-12e6-4d84-ae31-58a6b0e6ef85 | 动态拟牛顿法 + 动态递推最小二乘在线估计复合雅可比 | 同上 | ✅ |
| L60 | Visual Servo Control, Part I: Basic Approaches | Chaumette, F., Hutchinson, S. | 2006 | IEEE Robot. Autom. Mag. 13(4):82–90 | https://www.irisa.fr/lagadic/publi/publi/Chaumette06a-eng.html | 视觉伺服基础教程（IBVS/PBVS） | 背景 | ✅ |
| L61 | Controlling Mechanical Systems with Backlash — A Survey | Nordin, M., Gutman, P.-O. | 2002 | Automatica 38(10):1633–1649 | https://www.math.kth.se/optsyst/seminar/nordin.html （二手：KTH 研讨会页，提到该综述出自 Nordin 博士论文；原文页未找到） | 回差控制综述 | 回差模型（死区+间隙）背景 | ⚠️（只找到引用；出版社页和 DOI 未找到） |
| L62 | Adaptive Control of Systems with Actuator and Sensor Nonlinearities | Tao, G., Kokotović, P. V. | 1996 | Wiley（专著） | https://gov.wiley.com/WileyCDA/WileyTitle/productCd-047115654X,descCd-authorInfo.html | 用自适应逆统一处理死区、回差、迟滞 | 方案"逆迟滞补偿"的经典来源 | ✅ |
| L63 | Learning agile and dynamic motor skills for legged robots | Hwangbo, J., Lee, J., Dosovitskiy, A., Bellicoso, D., Tsounis, V., Koltun, V., Hutter, M. | 2019 | Science Robotics 4(26), eaau5872 | https://arxiv.org/abs/1901.08652 | 用神经网络学执行器模型（据二手资料输入为位置误差和速度的历史）做仿真到真机迁移 | "从历史学执行器"的先例；用关节编码器 | ✅（执行器网络输入细节未从原文核对） |
| L64 | Using Neural Networks to Model Hysteretic Kinematics in Tendon-Actuated Continuum Robots | Wang, Y. 等（6 人） | 2024 | arXiv（会议论文） | https://arxiv.org/abs/2404.07168 | 比较前馈、带历史缓冲的前馈和 LSTM 学缆驱连续体机器人迟滞 | 用历史学迟滞（连续体、有测量） | ⚠️（作者只核到第一作者） |
| L65 | Hysteresis Compensation of Flexible Continuum Manipulator using RGBD Sensing and Temporal Convolutional Network | Park 等（据检索摘要） | 2024 | IEEE RA-L 9(7):6091–6098 | https://arxiv.org/abs/2402.11319 | 用外部 RGBD 测量 + TCN 学迟滞并补偿，跟踪误差降 61% | **"用视觉测量学迟滞"的最接近工作**；区别：外部 RGBD 看末端、连续体机器人、不是世界模型 | ⚠️（作者表未核对） |
| L66 | Accounting for Hysteresis in the Forward Kinematics of Nonlinearly-Routed Tendon-Driven Continuum Robots via a Learned Deep Decoder Network | （作者未核对） | 2024 | IEEE RA-L 9(11)（据检索摘要） | https://arxiv.org/abs/2404.03816 | 以"当前+之前的缆位移"为输入解码整机形状，处理迟滞 | 同上 | ⚠️ |

### 2.7 低成本机器人学习、无编码器/无本体感知

| # | 标题 | 作者 | 年份 | 出处 | 链接 | 一句话贡献 | 和本文关系 | 核实 |
|---|---|---|---|---|---|---|---|---|
| L67 | LeRobot: An Open-Source Library for End-to-End Robot Learning | Cadene, R. 等（17 人） | 2026 | ICLR 2026 | https://arxiv.org/abs/2602.22818 | 从电机通信到数据集格式的开源机器人学习全栈，支持低成本硬件 | 本文数据集可用 LeRobotDataset 格式发布，方便别人复用 | ✅ |
| L68 | SO-ARM100 / SO-101（开源低成本机械臂） | TheRobotStudio 与 Hugging Face | 2024– | GitHub | https://github.com/TheRobotStudio/SO-ARM100 | 约 100~200 美元的 6 自由度臂，Feetech STS3215 总线舵机（**舵机自带位置反馈**） | 方案泛化实验的第二台臂；"去掉编码器读数"是人为设定 | ⚠️（只找到社区 fork 和二手页面） |
| L69 | CRAVES: Controlling Robotic Arm with a Vision-based Economic System | Zuo, Y., Qiu, W., Xie, L., Zhong, F., Wang, Y., Yuille, A. L. | 2019 | CVPR 2019 | https://arxiv.org/abs/1812.00725 | 不到 40 美元、**没有任何传感器**的 OWI-535 臂，只靠外部相机关键点估 3D 位姿来控制 | **"无传感器低成本臂靠视觉控制"已有先例**；区别：外部相机、仿真合成数据训练位姿估计、无迟滞建模、不是自监督 | ✅ |
| L70 | Latent Representations for Visual Proprioception in Inexpensive Robots | Sheikholeslami, S., Bölöni, L. | 2025 | arXiv | https://arxiv.org/abs/2504.14634 | 未标定外部低分辨率相机 + 单次回归，估计廉价 6 自由度臂（Lynxmotion AL5D）的关节构型 | **"廉价臂的视觉本体感知"已有人提**；区别：外部相机、监督回归（需要关节真值训练）、不处理回差 | ✅ |
| L71 | Fiducial Exoskeletons: Image-Centric Robot State Estimation | Smith, C., Van Hoorick, B., Guizilini, V., Wang, Y. | 2026 | arXiv | https://arxiv.org/abs/2601.08034 | 每节连杆装 3D 打印标记，单张 RGB 估各连杆 6D 位姿；在 100 美元 SO-100 上末端估计误差比正运动学降约 75%、控制误差降约 45% | **说明低成本臂的编码器/正运动学确实不准**（支持本文动机）；区别：外部相机 + 标记 | ✅ |
| L72 | Real-time Soft Body 3D Proprioception via Deep Vision-based Sensing | Wang, R., Wang, S., Du, S., Xiao, E., Yuan, W., Feng, C. | 2020 | IEEE RA-L 5(2):3382–3389 | https://arxiv.org/abs/1904.03820 | 软体内置相机 + CNN 实时重建 3D 形状（"视觉本体感知"） | "视觉本体感知"一词在软体机器人中的用法 | ✅ |
| L73 | Vision-guided state estimation and control of robotic manipulator（无本体传感器的单目状态估计） | Ortenzi, V. 等 | 2016 | IROS 2016（据伯明翰大学页面） | https://research.birmingham.ac.uk/en/publications/vision-guided-state-estimation-and-control-of-robotic-manipulator | 单目相机跟踪 + 运动学模型估计构型，面向恶劣环境 | 早期"无本体传感器"先例 | ⚠️ |
| L74 | （线索）H₂Arm：无编码器缆驱臂、唯一反馈是腕部相机、行为克隆 | 未查到 | 2022 | Springer（DOI 片段 s41315-022-00262-y） | https://link.springer.com/article/10.1007/s41315-022-00262-y | 据检索摘要：电机无位置传感器，唯一反馈是腕部低质量相机，用行为克隆 | **如果属实，是"无编码器 + 眼在手上"最接近的先例，必须读原文** | ❌ 未核实 |
| L75 | （线索）Simultaneously learning to recognize and control a low-cost robotic arm | 未查到 | — | Image and Vision Computing（ISSN 0262-8856，据第三方） | https://www.datalearner.com/academic/journal-papers/0262-8856/volumes-and-issues/246/paper-detail/88217 | 据第三方摘要：同时学低成本臂的外观（爪子识别）和控制（雅可比估计、LWPR） | 和 H2 + 在线雅可比都相关，必须读原文 | ❌ 未核实 |
| L76 | （线索）Behavior Cloning for Active Perception with Low-Resolution Egocentric Vision | Bilic, Chen, Bölöni（据检索） | 2026 | arXiv | https://arxiv.org/abs/2605.14106 | 低成本臂 + 腕部低分辨率 RGB 相机的行为克隆 | 低成本眼在手上 | ⚠️ |

### 2.8 眼在手上相机与自遮挡

| # | 标题 | 作者 | 年份 | 出处 | 链接 | 一句话贡献 | 和本文关系 | 核实 |
|---|---|---|---|---|---|---|---|---|
| L77 | Vision-Based Manipulators Need to Also See from Their Hands | Hsu, K., Kim, M. J., Rafailov, R., Wu, J., Finn, C. | 2022 | ICLR 2022（oral） | https://arxiv.org/abs/2203.12677 | 眼在手上视角可观测性更差，但训练效率和分布外泛化更好；第三人称视角用信息瓶颈正则 | 眼在手上的正面证据 | ✅ |
| L78 | ManiSkill3（附带观察） | — | 2024 | arXiv 2410.00425 | https://arxiv.org/abs/2410.00425 | 据检索摘要：相机角度和夹爪连杆遮住方块，策略难以判断是否抓住 | 夹爪自遮挡影响学习的一个旁证 | ⚠️（只有片段） |
| — | （空白） | — | — | — | — | **没找到**专门研究"眼在手上时，固定在画面里的爪子部件被检测器当成目标 / 遮挡目标导致检测框中心系统偏移"的论文（两次检索：标准 + 扩展） | 本文 H2 与"遮挡感知"小节的空白，但属于"据检索未找到" | — |

> 另外在检索中遇到但没核实、没列入表的：REPLAB（低成本可复现臂平台，arXiv 1905.07447）、NeuralActuator（arXiv 2607.11734，用关节遥测学齿轮回差/摩擦）。写作时可补查。

---

## 3 创新点核查（逐条对照方案第 2、3 节）

判断：**已被做过** / **部分做过** / **没找到**（= 本次检索范围内没找到，需人工复核）。

| # | 方案中的创新点（原文位置） | 最接近的已有工作 | 判断 | 调整建议 |
|---|---|---|---|---|
| C1 | 问题设定：没有关节反馈的低成本机器人用不了现有具身方法（§1） | L01–L03（VLA 不吃本体感知，但默认执行准确）、L08（去掉本体状态输入反而更好）、L69/L70/L71（无传感器/廉价臂的视觉状态估计）、L32（NJF 不假设传感） | **部分做过** | ①改写 §1："几乎都把关节角当输入"→"要么以本体状态为输入，要么默认低层执行准确（编码器闭环）"。②主动引用 L08，把它当**支持证据**："连高端臂上去掉状态输入都更好，说明视觉足够；但执行不可信时问题变了"。③把设定精确定义为**三者同时成立**：无关节反馈 + 历史依赖的执行误差（回差/死区）+ 相机装在执行链末端（眼在手上）。这三者同时成立的工作没找到 |
| C2 | "动作是唯一可信的信号"，靠自己的动作和画面自监督学身体（§2） | L27–L32（Lipson 组系列、NJF：随机命令 + 视觉学自我模型）、L31（第一人称相机 + 命令条件自我模型）、L34（受不受电机控制 → 自我识别）、L50 | **已被做过**（作为思想） | 不要当创新点写，当作**本文的出发点**并引用这些工作。卖点改为"在**执行不可信**时这条原则怎么改：命令 ≠ 实际动作，必须同时推断执行器的隐状态" |
| C3 | 自身/世界分离：与相机固连 = 自身；随命令按规律动 = 世界（§2、§3.2-2） | L34（Gold & Scassellati）、L33（DIJE，用关节传感器、外部视角）、L23/L24/L25（可控/不可控隐变量）、L41（自身运动分割）、L38、L40（本体-视觉对应做自他区分，依赖本体感知）、L48（机器人槽 + 物体槽） | **部分做过** | 突出**眼在手上的反转**：常见设定里"自身 = 跟命令动的东西"，眼在手上时**自身 = 画面里不动的东西，世界 = 跟命令动的东西**；而且无本体感知时"世界该怎么动"只能由学到的执行器模型预测，所以**分离和执行器辨识必须联合做**（回差吃掉动作时两类不可区分——v1 原型已经发现这一点：`11_报告.md` 2.4 节 "lost motion is not evidence"）。这个耦合是本文独有的，要写成方法上的核心 |
| C4 | 迟滞记忆 GRU，隐状态 h_t = 学出来的本体感知，可线性解码真实关节角（§3.2-3，H1） | L26（ac-RKN：循环隐状态学液压迟滞，有关节测量）、L63（执行器网络，有编码器）、L64/L65/L66（学连续体迟滞；L65 用外部 RGBD）、L13/L14（RSSM 隐状态本身有记忆）、L70（廉价臂视觉本体感知，外部相机 + 监督） | **没找到**完全相同的（扩展检索也没找到"无关节传感器 + 从图像学回差 + 世界模型"） | **这是最强的创新点，建议作为论文主线**。但要预先回答审稿人："RSSM/Dreamer 的确定性隐状态也有记忆，你的 GRU 有何不同？"→ 必须有消融：普通 RSSM vs 加结构（命令历史单独编码 + 回差方向先验 + v1 物理先验初始化），并用电位器真值证明 h_t 里**确实编码了回差方向**（方案 H1 的"回差方向识别率"指标很好，保留） |
| C5 | 动作条件物体中心世界模型（Slot Attention + 动力学）（§3.2-1） | L44（C-SWM）、L45（FOCUS，有真机）、L46（SOLD）、L48（OA-WAM，机器人槽）、L49（Slot-MPC） | **已被做过**（结构本身） | 不要把"物体中心世界模型"当创新；写成"我们采用槽位结构（引 L42/L44/L46），创新在先验（C3、C4）"。另外方案 §7 的退路"检测框 + 动作条件动力学"可能更实际：K230 已有检测框，审稿人也更容易接受 |
| C6 | 遮挡感知：物块被爪子遮挡时由时序一致性补全中心（§3.2-5） | L43（SAVi 时序跟踪）、L78（夹爪遮挡影响学习的旁证） | **没找到**专门针对"眼在手上自身部件造成检测中心系统偏差"的工作 | 作为次要贡献/实验发现写；需要先在真机上证明"偏右 4mm"确实来自遮挡（任务 12 存图后可查），否则只是猜测 |
| C7 | 在学到的世界模型里做短视距 MPC（CEM/MPPI）（§3.3） | L13、L17、L18、L19/L20、L22、L49 | **已被做过** | 方法上不算创新；只作为 H3 的下游验证 |
| C8 | 边缘部署：K230 NPU 跑编码器 + 树莓派跑规划（§3.3） | 没检索到同组合；L67 LeRobot 有异步推理栈 | **没找到**（工程贡献） | 可在 T-Mech / T-ASE 这类偏系统的期刊里作为亮点；在 RA-L/T-RO 里只能当工程细节 |
| C9 | 数据集："首个无本体感知、带执行器迟滞的低成本移动操作数据集"（§3.1） | L10（OXE）、L11（DROID）都带完整状态；L56（低成本家庭抓取，含执行噪声）；L69（CRAVES 无传感器臂数据集，但是姿态估计用）；L52/L53（自监督抓取数据） | **部分做过**（低成本/无传感器数据都有，"无本体感知 + 迟滞 + 移动 + 眼在手上 + 动作同步"的组合没找到） | **不要写"首个"**，改为"据我们所知，尚无公开数据集同时具备……"，并列出 L10/L11/L56/L69 的对比表。另外：**数据里应同时记录电位器真值**（只用于评估），这会让数据集价值高很多（别人可以研究视觉本体感知） |
| C10 | 低成本真值：舵机电位器引线到 ADC（§3.5） | 没检索到专门文献（工程做法） | 不是创新点，是**评估方法** | 写进实验设置；L71 的结论（廉价臂正运动学误差大）可以作为"为什么需要独立真值"的引用 |
| C11 | v1 概率模型作为基线和先验（§3.4） | L34（动态贝叶斯模型自我识别）、L57–L59（在线雅可比）、L62（自适应逆） | **部分做过**（各组成部分都是经典方法） | 把 v1 写成"经典方法的组合（引用 L34/L57/L62）"，它的价值是**可解释基线 + 物理先验消融**，不是创新 |
| C12 | 泛化到"换一台去掉编码器读数的 SO-100 类臂"（§4） | L71 已在 SO-100 上做视觉状态估计；L68 | — | 很好的实验设计，建议保留；注意 SO-100 的 STS3215 舵机**本身有位置反馈**，"去掉读数"是人为设定，论文里要说清楚，并且**可以同时用它的读数当真值**（比电位器方便） |

**总评**：方案"三者同时成立"的退路判断是对的。最稳妥的新颖性表述是：

> 在**无关节反馈、执行器有历史依赖误差（回差/死区）、相机装在执行链末端（眼在手上）**的低成本移动机械臂上，
> 从**命令历史 + 腕部图像**自监督地**联合**推断执行器隐状态（视觉本体感知）和自身/世界分割，并用于抓取。
> 已有工作要么有本体感知（DIJE、ac-RKN、π0、Lipson 组大部分工作），要么默认执行准确（VLA、State-free Policy、NJF 不显式建模历史依赖），
> 要么是外部相机（CRAVES、视觉本体感知、Fiducial Exoskeletons、RoboPose）。

---

## 4 投稿期刊分析

**分区说明**：任务要求"以投稿前查最新 JCR/中科院分区为准，只写查到的年份"。本次只能检索到**第三方页面**（学术之家、journalmetrics.org、高校图书馆列表），
没能打开 Clarivate JCR 和中科院分区表官网，所以下面的分区数字**都只是线索**，括号里写了来源和年份；**来源没给年份的不写**。

| 期刊 | 范围匹配 | 近两年类似主题论文（已核实的） | 篇幅 / 审稿周期（官网能查到的） | 分区（第三方，仅供参考） |
|---|---|---|---|---|
| **IEEE RA-L**（Robotics and Automation Letters） | ★★★ 机器人学习、视觉伺服、低成本机器人都在范围内；短文，适合 H1+H2 一篇 | L65 Park 等 2024（RA-L 9(7)，视觉测量 + TCN 补偿迟滞）⚠️作者未核；L66（RA-L 9(11)，迟滞正运动学）⚠️ | 官网 final submission checklist：终稿 **6 页**不收版面费（超页收费）；官网 information for authors：**3 个月内给首次决定**（accept / reject / revise and resubmit）；编辑页：6 个月内最终决定；投稿时可选 ICRA/IROS 报告 | 学术之家：2025 年 3 月升级版中科院 **计算机科学 2 区、机器人学 2 区**（第三方） |
| **IEEE T-RO**（Transactions on Robotics） | ★★★ 机器人基础研究；适合完整的 H1–H3 + 泛化 | 未找到核实过的近两年同主题例子（L50 Bohg 2017 是早年 T-RO 综述）→ 投稿前在 IEEE Xplore 用 "world model / self-model / proprioception / backlash" 检索补充 | 官网：常规论文 **12 页以上收版面费，上限 20 页**；力争每篇 3 份审稿意见；**官网没给审稿周期数字** | 两个第三方来源给出中科院 1 区和 2 区两种说法，**都没有年份** → 不写；journalmetrics 标注 2025 年 JCR Q1（第三方） |
| **IEEE/ASME T-Mech**（Transactions on Mechatronics） | ★★☆ 偏机电一体化；如果论文重点放在"舵机回差辨识/补偿 + 边缘部署 + 整机系统"很合适 | 未找到核实过的 | 官网页面没检索到；第三方页面称常规论文 **11 页双栏（含参考文献和作者简介）**，超出退稿——需官网核对 | 未查到带年份的 |
| **IEEE T-ASE**（Transactions on Automation Science and Engineering） | ★★☆ 自动化科学与工程；需要写"给从业者的说明"，适合"低成本、可部署"叙事 | 未找到核实过的 | 官网：常规论文超过 **12 页**每页收 175 美元；必须有 100–300 字 Note to Practitioners；摘要 ≤200 词 | 未查到带年份的 |
| **IEEE TII**（Transactions on Industrial Informatics） | ★☆☆ 工业信息学，机器人学习类稿件要强调工业应用；**不推荐首选** | 未找到 | 第三方（Manusights）：初投 **10 页**、终稿 12 页，第 11 页起收费——需官网核对；官方 IES 页：不收综述 | 未查到带年份的 |
| **Robotics and Autonomous Systems**（Elsevier） | ★★☆ 自主系统、感知驱动的控制与学习都在范围内（官方 aims & scope）；L34 Gold & Scassellati 2009 就发在这里 | 未找到近两年核实过的 | 官网 guide for authors 没检索到；SciRev 只有 1 条用户报告：一审约 16 周（不具代表性） | journalmetrics：2025 年 IF 5.2、JCR Q1（第三方） |
| **Engineering Applications of Artificial Intelligence**（Elsevier，IFAC 会刊） | ★★☆ "AI 方法在工程中的实际应用"，机器人是应用领域之一；适合作保底 | 未找到 | 官网没检索到审稿周期 | Comillas 大学数据库：2023 年 IF 7.5、Q1；journalmetrics：2025 年 IF 8.0、Q1（第三方） |
| **IEEE TCDS**（Cognitive and Developmental Systems）——补充推荐 | ★★★ 范围明确包括认知机器人、发育机器人；"机器人自我建模/自我识别"的天然去处（前身 TAMD 发过 L36 身体图式综述） | 未找到近两年核实过的 | 篇幅上限没查到；作者简介计入总页数（第三方转载的官网说明） | 未查到带年份的 |
| 其他可参考（不建议作首投） | Frontiers in Neurorobotics（L45 FOCUS 期刊版 2025 ✅）、npj Robotics（L31 第一人称自我模型 2025 ⚠️） | — | — | — |

**建议投稿路线**
1. **第一篇（4~10 周阶段的产出）**：H1 + H2，题目收窄为"眼在手上、无本体感知、有回差的低成本臂的视觉本体感知与自身识别" → **RA-L（可选 ICRA/IROS 报告）**。
   理由：短（6 页）、快（3 个月首次决定）、范围匹配；L65/L66 说明 RA-L 近期接收"学迟滞"的工作。
2. **第二篇（完整系统）**：H1–H4 + 泛化 + 消融 → **T-RO**（偏方法）或 **T-Mech / T-ASE**（偏系统、低成本部署）。
3. **叙事偏"自我建模/发育"时**：IEEE TCDS。
4. **保底**：RAS、EAAI。TII 不建议。
5. 无论投哪里：**投稿前到 Clarivate JCR 和中科院分区表官网查当年分区**，导师确认。

---

## 5 对 `docs/论文研究方案.md` 的修改建议（未直接改方案）

1. **§1 第 2 段**："几乎都把关节角度（本体感知）当作输入，并默认动作执行是准确的"
   → 改为"要么把本体状态作为输入（π0、ACT、Diffusion Policy），要么输出末端位姿增量、由依赖编码器的低层控制器执行（RT-1/RT-2/OpenVLA）；
   **两类都默认动作执行准确**"。并补一句：已有工作（Zhao 等 2025）表明在执行准确的机器人上去掉本体状态输入反而泛化更好——**我们研究的是执行本身不可信的情况**。
2. **§1 "这些机器人用不了现有方法"** 语气太满：OpenVLA/State-free Policy 理论上可以直接用在无编码器臂上（只吃图像），只是执行不准时会失败。
   建议改成"**直接套用会因执行误差失败**"，并把"VLA/State-free 在注入回差时成功率下降多少"做成一个**动机实验**（仿真里就能先做）。
3. **§2 核心思想**：加一句"这一原则源于机器人自我建模（Bongard 2006；Gold & Scassellati 2009；Hu 等 2025；Li 等 2025）"，
   把新意落在"**执行不可信时，自身/世界分离与执行器辨识必须联合进行**"。
4. **§3.1 数据集**：删掉"首个"，改为对比表；采集时同步记录电位器（或 SO-100 读数）真值；用 LeRobotDataset 格式发布。
5. **§3.2-1 物体中心编码**：注明结构借鉴 C-SWM / SOLD / OA-WAM，不作为创新；优先实现"检测框 + 动作条件动力学"的轻量版（K230 已有框），槽位版作为扩展。
6. **§3.2-3 迟滞记忆**：增加消融"普通 RSSM 隐状态 vs 结构化迟滞记忆"，否则审稿人会认为 Dreamer 已经包含；同时提防 copycat（Wen 等 2020），命令历史输入要做对照。
7. **§4 基线表**：H2 基线加 Gold & Scassellati 式贝叶斯可控性判别（v1 已实现，正好对上）；H1 基线加"外部相机视觉本体感知"（Sheikholeslami & Bölöni 2025 / CRAVES 思路，用手机俯拍即可）；
   H3 基线加 **State-free Policy**（Zhao 等 2025），这是"不用本体感知"的最强对手。
8. **§5 区别表** 需要更新：
   - "机器人自我模型：他们多为外部相机" → 补上 Hu/Chen/Lipson 的**第一人称**自我模型（四足、无抓取、无迟滞），以及 NJF（不假设传感）；
   - "DIJE 类" → 明确 DIJE 用了关节传感器；
   - "低成本机器人学习：他们有编码器" → 补上 CRAVES（无传感器，但外部相机）、Fiducial Exoskeletons（SO-100 编码器不准）、廉价臂视觉本体感知（外部相机，监督）。
9. **§0 题目**："Learning to Feel Without Sensors" 容易被理解成触觉；建议考虑 "Proprioception-Free"/"Hysteresis-Aware Visual Proprioception for Eye-in-Hand Low-Cost Manipulators" 一类更准确的说法（导师定）。
10. **§1 "顶刊"候选**：TII 范围不太匹配，建议换成 IEEE TCDS；先 RA-L 短文再 T-RO/T-Mech。

---

## 6 待人工完成

- [ ] 打开全文核对所有 ⚠️ 条目（特别是 L27/L28 的 Science 系列、L34、L61、L65/L66 作者表）
- [ ] 查 ❌ 线索 L74（H₂Arm）、L75（IVC 低成本臂）——如果属实，是 C1/C3 的最接近工作
- [ ] 读 NJF（L32）、DIJE（L33）、Hu 2025（L31）、OA-WAM（L48）、State-free（L08）全文，确认它们没有处理历史依赖的执行误差
- [ ] 在 IEEE Xplore 按期刊 + 关键词补"近两年类似主题论文"
- [ ] 中科院分区表 / JCR 官网查当年分区
