AULAGE/dache/docs/论文相关工作草稿.md

# 相关工作（草稿，中文，后续可翻成英文）

> 配套：`docs/论文文献调研.md`（文献表与核实状态）、`docs/references.bib`。
> 方括号里是 `references.bib` 的引用键；标 `[?未核实: …]` 的是还没核实原文的线索，**定稿前要么核实、要么删掉**。
> 所有"据我们检索未发现"的说法，定稿前需要在 IEEE Xplore / Google Scholar 再查一遍。

---

## 1 视觉-语言-动作模型与模仿学习

近年的通用机器人策略大致分两类。第一类以视觉-语言-动作（VLA）模型为代表：RT-1 [brohan2022rt1] 用 13 万条真机示教训练
Transformer 策略，把机械臂末端位姿增量和夹爪开合各离散为 256 档输出；RT-2 [rt2_2023] 进一步把动作当作文本 token，与网络规模的图文数据联合训练；
OpenVLA [kim2024openvla] 给出了 7B 参数的开源实现。这类模型的输入只有图像和语言，作者也把"仅单张图像、没有本体感知输入"列为局限 [kim2024openvla]；
但它们输出的末端位姿增量依赖机器人自带的、基于关节编码器的低层控制器准确执行。第二类把本体状态作为一等输入：
π0 [black2024pi0] 的观测包含多路图像、语言和本体状态，并为状态与动作 token 设置单独的"动作专家"权重；
ACT [zhao2023act] 和 Diffusion Policy [chi2023diffusion] 以关节位置和图像共同预测动作块；Octo [octo2024] 则允许在微调时加入本体感知等新观测。
支撑这些方法的大规模数据集（Open X-Embodiment [oxe2024]、DROID [khazatsky2024droid]）同样记录完整的关节状态。
值得注意的是，Zhao 等 [zhao2025statefree] 发现在执行准确的机器人上，加入本体状态会让策略过拟合训练轨迹，去掉它（仅用腕部相机和相对末端动作）
反而显著提升空间泛化；Wen 等 [wen2020copycat] 也指出，带历史输入的行为克隆容易"抄袭上一步动作"。

**本文的区别**：已有方法要么以本体状态为输入，要么默认低层执行准确——即使是去掉状态输入的工作 [zhao2025statefree] 也依赖编码器闭环执行相对动作。
本文研究的是**执行本身不可信**的机器人：PWM 舵机臂没有关节反馈，回差和死区使同一条命令的结果取决于历史。我们不是简单地去掉一个输入，
而是要从命令历史和腕部图像中推断"执行器实际处在哪里"。

## 2 世界模型

PlaNet [hafner2019planet] 和 Dreamer 系列 [hafner2020dreamer, hafner2025dreamerv3] 在学到的隐空间中规划或想象训练策略；
DayDreamer [wu2022daydreamer] 证明 Dreamer 可以不借助仿真器直接在多台真机上在线学习；TD-MPC [hansen2022tdmpc] 和 TD-MPC2 [hansen2024tdmpc2]
用无解码器的任务导向隐动力学做短视距模型预测控制。视频预测类方法从 Visual Foresight [finn2017foresight, ebert2018foresight] 到 UniSim [yang2024unisim]，
直接学习"动作 → 画面变化"；DINO-WM [zhou2025dinowm] 表明在冻结的预训练视觉特征上学动力学即可零样本规划。
与本文最相关的是几类**对隐状态施加结构**的工作：Iso-Dream [pan2022isodream] 用逆动力学把可控与不可控动态分到两个分支，
Denoised MDP [wang2022denoised] 按可控性和奖励相关性划分信息，ACRO [islam2023acro] 用多步逆模型提取智能体可控状态；
动作条件循环卡尔曼网络 [shaj2020acrkn] 则在有迟滞的液压臂上学到了比解析模型更准的正/逆动力学。

**本文的区别**：上述真机世界模型都有本体感知（ac-RKN [shaj2020acrkn] 的输入就是关节位置测量），可控/不可控分离 [pan2022isodream, wang2022denoised, islam2023acro]
默认"智能体自己"就是受动作控制的那部分。本文在眼在手上、无关节反馈的设定下，给世界模型加入两条结构先验：
（1）显式编码命令历史的迟滞记忆，其隐状态被要求能解码出真实关节角（用低成本真值检验）；
（2）"与相机固连 = 自身"的分离先验。我们会与不带这些先验的通用世界模型（DreamerV3、TD-MPC2）做对比，并专门消融"普通循环隐状态是否已足以表示回差"。

## 3 机器人自我建模与自我识别

让机器人通过自身动作学习身体模型有较长的历史。Bongard 等 [?未核实: bongard2006resilient] 让四足机器人通过少量自主动作推断自身拓扑并在受损后恢复；
Kwiatkowski 和 Lipson [?未核实: kwiatkowski2019selfmodel] 让机械臂从随机运动中学到任务无关的自我模型；Chen 等 [chen2022fullbody] 用五台外部相机学到以关节状态为条件的全身占据模型；
Hu 等 [hu2025simulations] 用单个普通相机从短视频中学到形态与运动学；Hu、Chen 和 Lipson [hu2025egocentric] 更进一步，用**第一人称相机**、以电机命令为条件学到四足机器人的动力学自我模型。
Li 等 [li2025jacobianfields] 提出的视觉运动雅可比场不对机器人的运动学、材料、驱动和传感做任何假设，仅从观察随机命令的执行中学会控制多种软硬机器人。
在自我识别方面，Gold 和 Scassellati [?未核实: gold2009selfrecognize] 通过比较多个动态贝叶斯模型的似然判断画面中的物体是否受自身电机控制；
Lanillos 和 Cheng [lanillos2018predictive] 用预测编码融合视觉、触觉和本体感知估计身体状态；DIJE [toshimitsu2025dije] 结合光流与关节传感器读数逐像素估计图像雅可比，
在自身与外部运动重叠时也能区分二者；Boerdijk 等 [boerdijk2020gripperseg] 和 Rezvani 等 [rezvani2025embodiment] 利用自身运动线索分割机器人身体或被抓物体，Almeida 等 [almeida2021whereismyhand] 用深度分割网络让人形机器人在自己的头部相机里识别自己的手；
RoboPose [labbe2021robopose] 则从单张图像估计已知机器人的关节角。

**本文的区别**：（1）大部分工作使用外部相机观察整个机器人，或以关节状态为条件；第一人称的自我模型 [hu2025egocentric] 针对的是腿式移动，没有抓取任务，也没有建模执行器回差。
（2）在眼在手上的设定下，"自身"与"世界"的运动学特征和常见设定**正好相反**：爪子在画面里不动，世界随命令运动。
（3）没有本体感知时，"世界应该怎样运动"只能由学到的执行器模型预测，回差吃掉命令时自身与世界在这一步上不可区分——因此**自身/世界分离与执行器辨识必须联合进行**，
这一耦合在已有自我识别工作中没有出现（DIJE [toshimitsu2025dije] 用关节传感器读数回避了它）。

## 4 物体中心表示

Slot Attention [locatello2020slot] 通过竞争式注意力把图像特征分配给若干槽位，SAVi [kipf2022savi] 将其扩展到视频并支持用首帧位置提示指定要跟踪的对象。
C-SWM [kipf2020cswm] 用对比损失学习动作条件的物体级世界模型。在机器人操作中，FOCUS [ferraro2023focus] 学习物体中心世界模型并给出了真机演示，
SOLD [mosbach2025sold] 的槽位隐动力学在多物体操作仿真中超过 DreamerV3 和 TD-MPC2，Chapin 等 [chapin2025objectcentric] 观察到槽位能自然分出背景、机器人和物体，
OA-WAM [liu2026oawam] 则显式地把每帧分解为一个机器人槽和若干物体槽。

**本文的区别**：本文不把"物体中心世界模型"本身作为贡献，而是在槽位结构上加入眼在手上特有的先验：自身槽位在相机坐标系中静止、世界槽位的位移必须由学到的执行器模型解释，
从而在**没有任何标注、没有本体感知、不借助大规模预训练分割模型**的条件下分出爪子和物块。若槽位分解在真实画面上不稳定，我们退回到"检测框 + 动作条件动力学"的轻量版本。

## 5 交互式感知与自监督机器人学习

交互式感知 [bohg2017interactive] 主张利用"动作参数与传感数据之间的规律"来解释感知。机器人通过推、戳和抓取自监督地学习物理直觉 [agrawal2016poke]、
实例分割 [pathak2018segbyinteraction] 和抓取 [pinto2016supersizing, levine2016handeye]，其中 Levine 等 [levine2016handeye] 学到的成功概率网络不依赖相机标定；
好奇心驱动的探索 [pathak2017curiosity] 用预测误差作为内在奖励。Gupta 等 [gupta2018homes] 用低于 3000 美元的移动机械臂在家庭环境采集抓取数据，并把执行不准和标定误差造成的标签噪声建模为隐变量。

**本文的区别**：已有交互式感知通常通过**接触物体**获取信号，并假设机械臂按命令准确运动；本文只用**自身运动**（不碰物体）作为分离信号，
并且把执行误差从"与历史无关的噪声" [gupta2018homes] 细化为"与命令历史相关的回差和死区"，作为可推断的隐状态。

## 6 无标定视觉伺服与执行器迟滞

无标定视觉伺服通过在线估计图像雅可比来避免相机和运动学标定，代表方法有 Broyden 型秩一更新与加权递推最小二乘 [?未核实: hosoda1994versatile] [jagersand1997uncalibrated]
以及动态拟牛顿法 [piepmeier2004uncalibrated]，基本框架见 [chaumette2006visual]。回差、死区等"硬非线性"的控制有大量研究 [?未核实: nordin2002backlash]，
经典做法是自适应逆补偿 [tao1996adaptive]。学习方法方面，Hwangbo 等 [hwangbo2019anymal] 用神经网络从历史数据学执行器模型；
针对缆驱/连续体机器人，已有工作用带历史的神经网络学习迟滞 [?部分核实: wang2024hysteretic]，或用外部 RGBD 测量配合时序卷积网络补偿迟滞 [?部分核实: park2024hysteresis]。

**本文的区别**：在线雅可比估计默认动作被准确执行，回差会使其产生系统偏差（本文原型在仿真中观察到 13~17% 的偏差）；
已有迟滞学习都依赖关节传感器或外部测量设备。本文从**腕部相机看到的画面位移**中同时辨识回差与雅可比，不需要关节传感器或外部相机——据我们检索，尚未见到这一设定下的工作。

## 7 低成本机器人与无本体感知控制

ALOHA [zhao2023act]、Mobile ALOHA [fu2024mobilealoha] 以及 LeRobot [cadene2026lerobot] 生态中的 SO-100 类机械臂大幅降低了机器人学习的硬件门槛，但它们的舵机都提供关节位置反馈。
真正"没有传感器"的机械臂较少被研究：CRAVES [zuo2019craves] 用外部相机检测不到 40 美元、无任何传感器的机械臂关键点来控制它；
Sheikholeslami 和 Bölöni [sheikholeslami2025visualproprio] 用未标定的外部相机回归廉价机械臂的关节构型；
Fiducial Exoskeletons [smith2026fiducial] 发现低成本 SO-100 臂基于正运动学的状态估计误差很大，用连杆标记和外部相机将末端估计误差降低约 75%；
在软体机器人中，Wang 等 [wang2020softproprio] 用内置相机实现"视觉本体感知"。
[?未核实: H₂Arm（Springer, 2022）据检索摘要是一台无位置传感器、仅有腕部相机反馈的缆驱臂，用行为克隆控制——如属实应在此讨论。]

**本文的区别**：已有无传感器/视觉本体感知工作都使用**外部相机**（或在身体内部嵌入相机），并且多需要关节真值做监督训练；
本文的相机装在执行链末端，同一台相机既要感知世界又要（间接地）感知自己的身体状态，而且训练不需要关节真值（真值只用于评估）。

## 8 眼在手上相机与自遮挡

Hsu 等 [hsu2022seehands] 发现眼在手上视角虽然可观测性较差，却能提高训练效率和分布外泛化。然而，眼在手上的相机常常能看到夹爪自身：
夹爪部件可能遮挡目标 [?部分核实: ManiSkill3 中的观察]，也可能被检测器误当成目标。

**本文的区别**：据我们检索，尚未见到专门研究"画面中固定可见的自身部件导致检测器误锁、或因遮挡导致目标中心系统偏移"的工作。
本文的自身/世界分离先验直接针对前者，遮挡感知的时序补全针对后者，并在真机上量化这两种误差。

---

## 定稿前的检查清单

- [ ] 所有 `?未核实` / `?部分核实` 标记：打开原文核实后改成正式引用键，或删除
- [ ] 第 1 节对 ACT 输入的描述（"关节位置和图像"）要用原文第 III 节核对
- [ ] 第 6 节"13~17% 的偏差"来自仿真（`docs/cloud_tasks/results/11_报告.md`），真机数据出来后替换
- [ ] 每段"本文的区别"要和最终实验结果对应，不能写没做到的
