AULAGE/dache/docs/robotac/templates/图片/AI_Agent识物问答截图.jpg

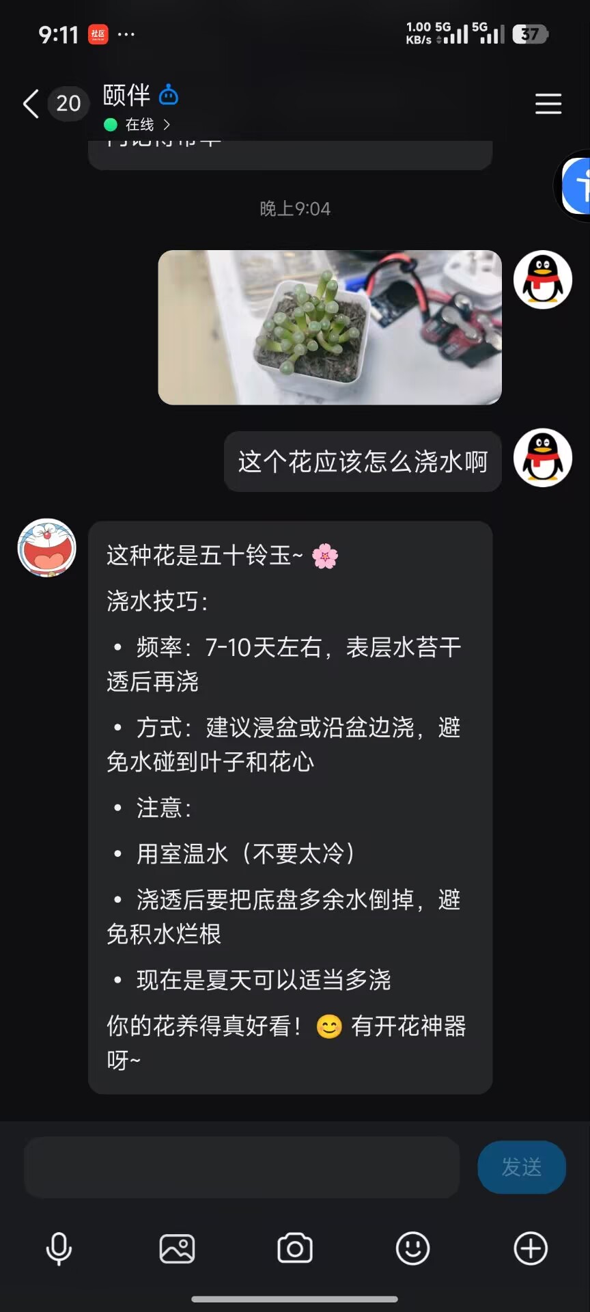
docs/robotac/templates/图片/AI_Agent识物问答截图.jpg
