AULAGE/dache/docs/robotac/templates/图片/大车硬件配置表.png

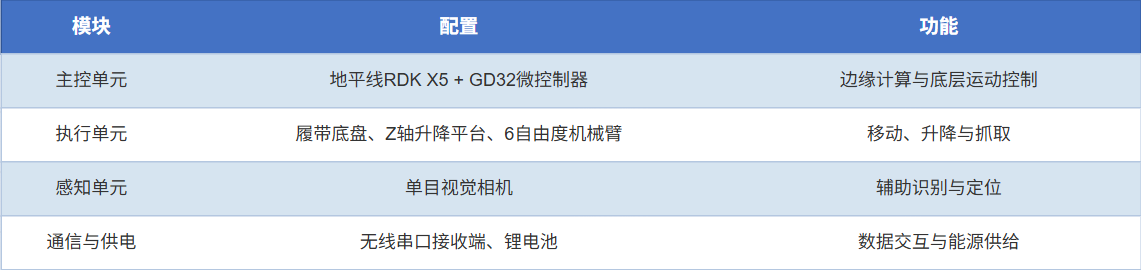
docs/robotac/templates/图片/大车硬件配置表.png
