AULAGE/dache/docs/robotac/templates/图片/感知板焊接实物.jpg

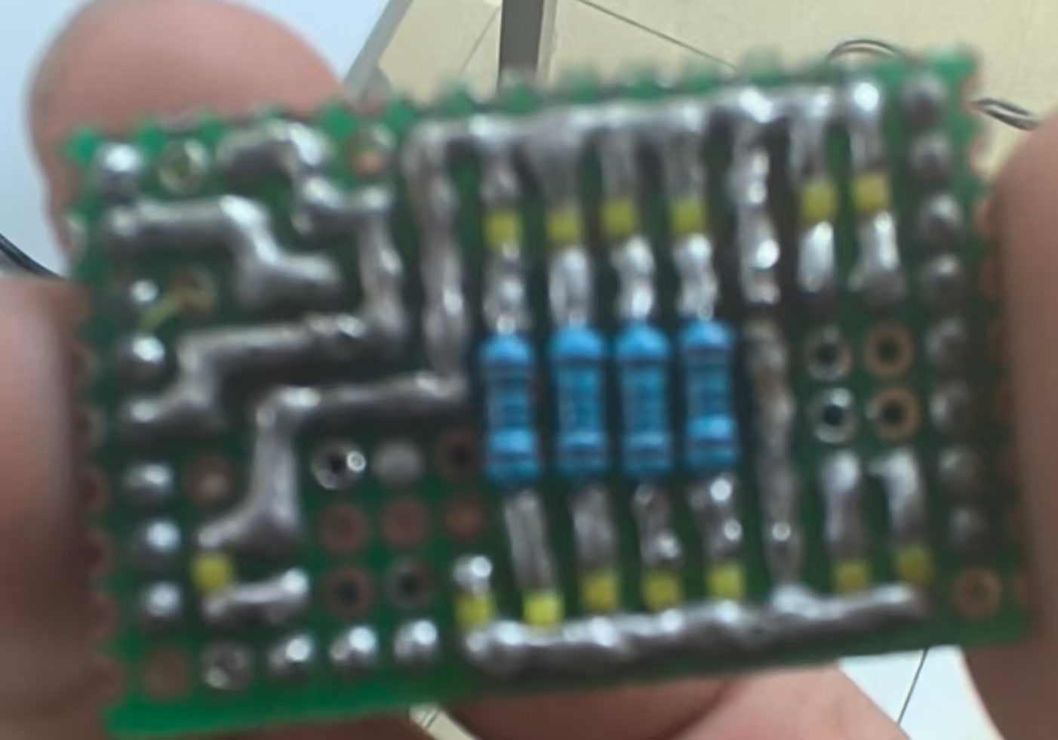
docs/robotac/templates/图片/感知板焊接实物.jpg
