AULAGE/dache/docs/robotac/拍摄清单_v2.md

# 拍摄清单 v2（新系统）

> 原则：**真实、一镜到底的全自动片段最有说服力**，剪辑只做加速和字幕，不拼接成功画面。
> 手机横屏 1080p/60fps 以上；固定机位（三脚架或稳定支架）+ 一段手持特写；背景干净、灯光充足。
> 每段多拍几遍，文件名写清楚：`日期_片段号_第几遍.mp4`。拍的时候终端开着 `--record`，日志留作证据。

| # | 片段 | 时长 | 机位 | 怎么拍 | 用在哪 |
|---|---|---|---|---|---|
| ① | **全自动抓取一镜到底**（最重要） | 30~60 s | 侧前方 45°，能看到车、升降轴、机械臂和物块 | 物块放在平台上，运行 `python3 main.py --once --no-chassis`，从搜索拍到放进筐里，中间不剪 | PPT 首页视频、报告图 5 截图 |
| ② | **K230 画面** | 20 s | CanMV IDE 录屏 | 识别框跟着物块、红色虚线屏蔽区域、深度读数；手慢慢移动物块 | 3.3 节视觉 |
| ③ | **对准过程特写 + 终端** | 20~30 s | 画中画：左边机械臂特写、右边终端日志（`对准 #1 误差 …`） | 同 ①，录屏 + 手机同时拍，剪辑时并排 | 3.4 自适应伺服 |
| ④ | **连续抓取** | 1~2 min（加速播放） | 同 ① | 换不同位置连续抓 5~10 次（bench 跑的时候顺便拍），字幕标"第 n 次" | 说明可靠性 |
| ⑤ | **失败自动重试** | 20~40 s | 同 ① | 遇到没抓到 → 确认 → 自动重试成功的片段就保留（不用刻意制造） | 3.5 确认与重试 |
| ⑥ | **自身干扰保护** | 15 s | 屏幕 + 机械臂 | 如果现场能复现"识别到爪子 → 程序停止"就拍；不能复现就跳过 | 3.6 安全 |
| ⑦ | **升降轴速度对比** | 10 s | 侧面 | `python3 calib.py lift 30` 再 `lift 0`，看清 80 mm/s 的升降 | 4.5 版本迭代 |
| ⑧ | **底盘参与抓取**（加分，9 日前联调成功才拍） | 30~60 s | 稍远，能看到车移动 | `python3 main.py --once`，车距平台 40~60 cm | 有底盘的完整演示 |
| ⑨ | **整机外观环绕** | 15 s | 手持慢慢绕一圈 | K230 在腕部、树莓派、升降轴、底盘的特写 | 开场 |
| ⑩ | 语音交互 / 环境感知（如果还要展示） | 各 15 s | — | 沿用旧视频或重拍 | 扩展功能 |

**截图（报告和 PPT 用）**：从 ① 里截 6 张：搜索、对准、伸出、合爪、确认、放置；② 里截 1 张 K230 画面；终端截 1 张对准日志；`bench.py report` 输出截 1 张。

**数据**：拍 ④ 的同时用 `GRASP_RECORD=1 python3 bench.py` 记录真实结果，报告第 5.3 节的成功率表就用这次的数据。
