AULAGE/dache/docs/cloud_tasks/results/18_报告.md

# 任务 18 报告：底盘联调预演 + 分步操作手册

> 分支 `cloud/18-chassis-rehearsal`。**本报告所有结论都来自读代码 + 离线仿真（`sim.SimWheeltec`）+ 假串口，没有在真机验证。**
> `底盘代码/` 没改，通信协议没改，`sim.py` 没改（仿真设置都在 `test_chassis_rehearsal.py` 里做）。改过的 CRLF 文件保持 CRLF。

## 0. 结论

1. **发现 6 个会导致危险动作的问题，都做了最小修复**（两个单独的提交），每个都有"复现原问题 + 修复后"的测试：

   | # | 问题 | 修复前（仿真 / 假串口） | 修复后 | 开关（默认开） |
   |---|---|---|---|---|
   | 1 | K230 把爪子当成物块时，对准中底盘一步步一直开（开车那一步不查 ghost） | 25 步走了 **5.2m** | 2 步就停（≤ 405mm） | `GHOST_CHECK_D` |
   | 2 | 有底盘时搜索不复核，K230 偶尔的误识别让底盘朝空处一步开 400mm | 车开到离物块（底座转轴）**69mm**，会撞平台 | 0 次 | `SEARCH_CONFIRM_CHASSIS` |
   | 3 | 底盘走完一步后深度读数跳变（误读），照着误读再开一大步 | 中途开过头 **330mm** | 先确认，不开过头 | `CHASSIS_JUMP_CHECK` |
   | 4 | `main.py` 连续运行、周围没物块时，每次搜索都后退 250mm，**没有上限** | 6 次退了 **1.5m** | 累计最多 500mm | `SEARCH_BACKOFF_MAX_MM = 500` |
   | 5 | 走到一半回传断了：里程不涨，`drive()` 一直开到超时 | 400mm 的一步走了 **2.2m** | 0.5 秒内停车报错 | 无（驱动里直接改） |
   | 6 | `systemctl stop grasp` / `kill` / SSH 断开时 Python 直接退出，停车帧没发；固件没有超时 → **车按最后速度一直走** | 最后一帧是行驶帧 | 最后一帧是停车帧 | 无（`main.install_stop_signals()`） |

   开关都在 `CALIB_KEYS` 里，设 `False` / `0` 恢复原行为。只影响有底盘的情况；无底盘的仿真结果逐项不变。

2. **有底盘场景统计**（物块在车前 300~700mm、±30°，3 台车 × 40 次）：修复后所有设置 **0 次危险动作**；真机标定近似下成功率 85%，
   **把搜索角加密成 `[0, ±35, ±70]` 后 95%、平均 40 秒**（K230 画面转了 90°，水平半视场只有约 21°，默认搜索角有空档）。
3. **`chassis_test.py` 补全**：`--voltage`、`--hang`（三种停车）、`--ruler --write`（±100/±200mm，尺子拟合 τ 写 calib）、`--radius --write`（最小转弯半径）。
4. **手册** `docs/底盘联调手册.md`：每一步的命令、预期、通过标准、出问题怎么判断；**防撞平台的几何检查**；11/9 晚"用不用底盘"的决策标准。
5. `selftest.py` 全部通过（163 项）。整套仿真回归（`main.run_sim`，物块 0.3~1.2m、±60°）6 台车 × 100 次：**89.3% → 92.3%**；
   selftest 里那组 40 次从 36/40 变成 35/40，原因见第 6 节（原来那几次"成功"是跟着误识别碰巧走对的）。

---

## 1. 代码路径审查（真机参数下）

真机参数取自 `CLAUDE.md`：`R_CAM_MM = 0`、`BASE_DIR = −1`、近 156mm→Y+70、远 216mm→Y+43、`VERIFY = "observe"`、
`ACK_MIN_RADIUS_MM = 600`（估计）、滑行 τ ≈ 0.45s（"100mm 走 145mm"是没有滑行模型时的结果）。

### 1.1 `devices.WheeltecChassis`

| 项 | 行为 | 结论 |
|---|---|---|
| 50Hz 发送 + `CHASSIS_CMD_TTL_S = 0.5` | 主线程 0.5 秒不刷新指令 → 发送线程改发 0 | ✅ 有效（假串口测过；真机用 `--hang` A 项确认） |
| `close()` / `atexit` | 直接写 3 帧停车帧 | ✅；但 **SIGTERM / SIGHUP 不触发 atexit** → 问题 6 |
| `drive()` 开始时 `fb = has_feedback()` 只取一次 | 有回传 → 按里程走；**中途回传断了**，`done` 不再增加，按 `remaining × RAMP_K` 一直以最高速开到超时（`target/30×1.5+3` 秒，400mm = 23 秒） | ❌ → 问题 5，循环里每拍检查 `has_feedback()` |
| 开始时就没回传 | 按时间开环走 `target/speed` 秒 | 可接受：`main.py` 启动前检查要求底盘有回传（除非 `--force`） |
| 阿克曼转角截断 `max_dpsi = mm / min_radius` | `ACK_MIN_RADIUS_MM` 配小了也只是请求做不到的弯，固件自己截；实际转角由回传积分 | ✅ 仿真：真实半径 900、配置 600，成功率 86%（配置正确 85%），0 危险 |
| 超时 `DeviceError` | `main.py` 连续模式下 3 秒后重开设备再来 | ⚠ 车被平台卡住时会反复顶（没改，手册要求先 `--once`） |

### 1.2 `task.align` 底盘分支

| 分支 | 审查 | 结论 |
|---|---|---|
| 深度轴 `u_d = AXES["d"]` 一步最多 **400mm** | 读数正确时没问题；读数错时一步就是 40cm | 本身不改（真机对准需要），配合问题 1~3 的保护 |
| ghost 检查 | 原来只查 y（升降）和 x（底座，且**开车时不查**）。爪子脚读数恒定 + 有深度误差 → 每步都开车 | ❌ → 问题 1，按实际里程预测深度变化（乘 cos(底座角)，预测 < 30mm 不查） |
| 边走边转 `drive(u_d, base_new)` + 几何前馈 `base_after_move` | 前进 / 后退的转向符号、按弧中点近似都核对过；`R_CAM = 0` 时几何简单 | ✅ 仿真里"转向打满"最长连续 2 次、车头累计 ≤ 34°，没有兜圈 |
| 走完后直接信新读数 | 读数跳变（误识别 / 跟踪器换目标）时照着开 | ❌ → 问题 3 |
| `BASE_LIMIT_BACKUP_MM`（默认 0） | 只在底座转到 ±85° 还差时触发；物块在 ±30° 内**一次都没触发**（打开和不打开结果逐项相同） | 不危险；手册里不建议这次打开 |
| 阿克曼 `recenter` 只在有 `u_d` 时才拐 | 深度已对好、底座偏大时不会去拐（避免原地兜） | ✅ |

### 1.3 搜索、重试

| 项 | 审查 | 结论 |
|---|---|---|
| 搜索先 `SEARCH_LOOK_FIRST` 原地看一眼（会复核），再扫底座角（`SEARCH_CONFIRM = False` 时**不复核**） | 有底盘时一次误识别就开 400mm | ❌ → 问题 2 |
| 搜索后退 `SEARCH_BACKOFF_MM = 250` | 每次搜索最多退一次；`run_once` 里最多搜 4 次；`main.py` 连续运行时**跨次数累加没有上限** | ❌ → 问题 4 |
| 抓取失败 `release_and_back_off` 后退 60mm | 每个物块最多 3 次 = 180mm | ✅ |
| 视场 | K230 `ROTATE_DEG = 90`、1280×720、`FOCAL_PIX = 944` → 水平半视场 21°、竖直 34°；`config.py` 的 `FOV_X/Y = 35/25` 是没转之前的值（只有仿真用） | 默认搜索角 `[0, ±55, ±85]` 在 21°~34° 有空档 → 手册建议加密（已把 `SEARCH_BASE_DEG` 加进 `CALIB_KEYS`） |

### 1.4 进程退出

`setup/grasp.service` 里写着调试时 `sudo systemctl stop grasp`，`main.py` 没有信号处理 → SIGTERM 直接杀进程，`finally` 和 `atexit` 都不执行，
固件保持最后一帧速度（任务 03：没有超时）。SSH 窗口关掉（SIGHUP）同理。→ 问题 6。`kill -9`、断电、USB 掉线仍然拦不住，手册第 0 节写明只能拨开关。

---

## 2. 有底盘场景统计（`python3 test_chassis_rehearsal.py`）

场景：物块在车前 300~700mm（从后轴中点量）、±30°，高度 5~40cm；底盘用 `sim.SimWheeltec`（真机同一套 `drive()` + 假控制器）。
每种设置 3 台车（seed 18/7/9）× 40 次。"危险"：离起点后退 > 600mm、转向打满连续转过 ≥ 90°、比"对准距离 / 起始距离"再靠近物块 > 60mm、单次总里程 > 3m。

| 设置 | | 抓到 | 步数 | 用时 | 里程 平均/最大 | 后退最大 | 打满最长 | 多靠近物块 | 危险 |
|---|---|---|---|---|---|---|---|---|---|
| config 默认值 | 修复前 | 85% | 3.8 | 68s | 388 / 1458mm | 263mm | 4 次 / 107° | 287mm | **14** |
| | 修复后 | **98%** | 4.0 | 58s | 310 / 803mm | 264mm | 2 次 / 34° | 56mm | 0 |
| 真机标定近似 | 修复前 | 80% | 4.4 | 82s | 575 / **3569mm** | 265mm | 4 次 / 140° | 152mm | **7** |
| | 修复后 | 85% | 4.3 | 73s | 484 / 1105mm | 265mm | 2 次 / 32° | 37mm | 0 |
| ＋真实最小半径 900（配置 600） | 修复前 | 80% | 4.5 | 79s | 554 / 2183mm | 265mm | 3 次 / 74° | 107mm | 3 |
| | 修复后 | 86% | 4.4 | 73s | 476 / 1105mm | 265mm | 2 次 / 18° | 3mm | 0 |
| ＋真实滑行 τ = 0.6s | 修复前 | 82% | 4.3 | 86s | 575 / 1958mm | 323mm | 3 次 / 103° | 140mm | 6 |
| | 修复后 | 87% | 4.2 | 74s | 473 / 1082mm | 269mm | 2 次 / 30° | 38mm | 0 |
| ＋搜索角 `[0,±35,±70]` | 修复前 | 96% | 4.5 | 39s | 295 / 754mm | 0 | 2 次 / 30° | 2mm | 0 |
| | 修复后 | **95%** | 4.5 | **40s** | 295 / 754mm | **0** | 2 次 / 30° | 3mm | 0 |
| ＋`BASE_LIMIT_BACKUP_MM = 150` | 修复后 | 85% | — | — | 和"真机标定近似"逐项相同（±30° 内没触发） | | | | 0 |

- "真机标定近似"：`R_CAM = 0`、`BASE_DIR = −1`、`GOAL = (0°, Y+70, 156mm)`、`GOAL_FAR = (0°, Y+43, 216mm)`、`VERIFY = "observe"`，
  视场按转 90° 后的 21°/34°（**不改的话 GOAL 的 Y+70（向下 24°）在仿真里出了画面，一次都抓不到**——仿真设置问题，不是真机问题）
- 真机近似下没抓到的主要是 `not_found`（物块在 ±28° 左右，落在搜索角空档里），加密搜索角后消失，平均用时 73s → 40s、不再后退搜索
- 修复后的危险都是 0；"修复前"的危险几乎全是误识别（问题 2、3）引起的：车朝空处开一大步，或中途开过头
- 抓取失败里有 1 次 `crash` 是仿真的机械臂 USB 掉线（`ARM_USB_ROBUST = False`），和底盘无关
- 仿真没有模拟：平台 / 车身碰撞（只按距离判断）、地面打滑超过 2%、真机固件和源码不一致的部分

## 3. 危险动作测试（`test_chassis_rehearsal.py quick`，selftest 也会跑）

```
危险动作：K230 把爪子当成物块时底盘会不会一直开（读数不随底盘动作变化）
  ✅ 假目标 x=-60 y=+0 d=90：底盘总共走 ≤ 2 步的量就停（ghost）   2 步，里程 115mm
  ✅ 假目标 x=-60 y=+2 d=400：底盘总共走 ≤ 2 步的量就停（ghost）   2 步，里程 405mm
  ✅ 假目标 x=+0 y=+0 d=300：底盘总共走 ≤ 2 步的量就停（ghost）   2 步，里程 230mm
危险动作：底盘走完一步后 K230 误读（深度跳大 150mm），会不会照着误读再开一大步
  ✅ 原行为（CHASSIS_JUMP_CHECK=False）：照着误读多开了一大步（复现原问题）   中途开过头 330mm，每步 [255, 382, -280, -41]
  ✅ 深度变化和里程对不上 → 再确认一次，不照着误读开车   中途开过头 -7mm，每步 [255, 41]
危险动作：底盘走到一半回传断了
  ✅ 回传断了 0.5 秒内停车并报设备错误（原来会按时间一直开到超时）   实际走了 104mm
危险动作：systemctl stop / kill 时底盘停不停（固件没有串口超时）
  ✅ 没有信号处理时：SIGTERM 后最后一帧是行驶帧（复现原问题：车会按最后速度一直走）
  ✅ main.install_stop_signals()：SIGTERM 后最后发出的是停车帧
危险动作：周围没有物块时 main.py 连续运行，搜索后退会不会一直倒下去
  ✅ 原行为（SEARCH_BACKOFF_MAX_MM=0）：6 次一共退了 1.5m（复现原问题）   1535mm
  ✅ 累计后退上限 500mm：6 次以后最多退 500mm 左右，结果仍是 not_found   506mm
```

修复前的数字（问题 1 的 5.2m、问题 5 的 2.2m）是在修复前的代码上跑同一个测试得到的。问题 2 没有单独的测试，体现在第 2 节统计的"危险"列。

## 4. `chassis_test.py`

| 命令 | 做什么 | 写什么 |
|---|---|---|
| `--voltage` | 只读：电压、flag、vx/wz、陀螺仪原始值（3 秒） | — |
| `--hang` | 架空：A 指令过期自动停、B `close()` 停、C 子进程收 SIGTERM 停；任何一项 ❌ 提示不能下地 | — |
| `--timeout-check` | 不经过驱动，验证固件有没有串口超时（原有） | — |
| `--ruler [--fresh] [--write]` | 默认 `--dist 100,200`：+100×3、−100×3、+200×3、−200×3；按距离分组汇总里程误差 / 尺子误差、航向漂移；拟合"尺子 / 里程"比例和滑行 τ | `calib.json` 的 `CHASSIS_PI_TAU_S` + `logs/chassis_tau.json`（main.py 实际读的 τ 文件，否则旧的学习值会覆盖 calib） |
| `--radius [--write]` | 驱动截断临时放到 150mm，让固件自己打满；左、右各走 600mm 弧；输入弦长和侧移 → R = 弦长²/(2·侧移)；取大的一边 +5% | `calib.json` 的 `ACK_MIN_RADIUS_MM`（只有两边都用尺子量了才写；陀螺仪推算的不写） |

- 里程计比例偏 > 3% 或 τ 离散 > 0.1s 时，`--write` 写驱动按里程学到的 τ，不写尺子拟合值（尺子拟合不可信）
- 写 calib 只改这一项、保留原有标定，键必须在 `CALIB_KEYS` 里（测试覆盖）
- 云端验证：纯计算函数有单元测试；`--ruler --write`、`--radius --write`、`--voltage` 用 selftest 的**固件假控制器**干跑通过（输出格式正常、写 calib 正常）；
  `--hang` 和 `--timeout-check` 要真串口，**没跑过**

## 5. 手册 `docs/底盘联调手册.md`

0 安全（哪些情况能自动停、哪些只能拨开关）→ 时间安排 → 第 0~8 步（准备、只读、架空、直走、半径、量车头摆场地、单步、全自动、bench 对比）
→ 11/9 决策标准 → 贴什么给云端 → 记录表。每一步都有命令、预期现象、通过标准、"现象 / 判断 / 处理"表。

特别提醒的一条（仿真里看不出来）：有底盘时程序会把**底座转轴开到离物块约 156mm**（`R_CAM = 0`、`GOAL d = 156`）。
车头比底座转轴还往前伸 F，平台挡在物块前面 E 时，要求 F + 30 ≤ 156 − E，否则一定撞平台。手册第 5 步让用户先量。

决策标准（摘要）：**全部**满足才用底盘——架空三项 ✅、联调全过程 0 次危险动作、bench 有底盘 ≥ 70% 且不比无底盘低 10 个百分点以上、平均 ≤ 60 秒、
比赛确实需要底盘、车头不撞平台；拿不准就不用。

## 6. 测试结果

```
python3 selftest.py        → 通过 163 项，失败 0 项（原来 143 项 + 任务 18 的 20 项）
python3 test_recorder.py   → 通过 16 项，失败 0 项
```

仿真回归（`main.run_sim`，整套流程，物块 0.3~1.2m、±60°）：

| | 修复前 | 修复后 |
|---|---|---|
| selftest 有底盘 40 次（seed 31） | 36/40 = 90% | 35/40 = 88% |
| selftest 无底盘 30 次 / 任务 09 开关 30 次 | 100% / 100% | 100% / 100%（逐项相同） |
| selftest 有底盘 + 任务 02 开关 40 次 | 35/40 | 35/40 |
| **6 台车 × 100 次（seed 31,1,2,3,4,5）** | **89.3%** | **92.3%** |

selftest 那组 40 次少了 1 次：逐次对比，变化来自 `SEARCH_CONFIRM_CHASSIS`，有 3 次从"成功 / 失败"变成 `not_found`。
看了其中一次（第 33 次）：后退之后两次"看到目标"时仿真里物块的真实视图都是 `None`（看不到），也就是**两次都是误识别**；
原来跟着误识别开过去碰巧看到了真物块，现在复核后不追误识别 → 没找到（物块在识别距离外）。样本大了以后是 +3 个百分点。
`GHOST_CHECK_D` 在 600 次里没有一次误判（打开前后结果逐项相同）。

## 7. 没在真机验证的（全部）

- 6 个修复都只在仿真 / 假串口上验证；SIGTERM 测试用的是假串口的子进程
- `chassis_test.py --hang`、`--timeout-check` 没跑过；`--ruler`、`--radius`、`--voltage` 只在固件假控制器上跑过
- 统计用的"真机标定近似"是按 `CLAUDE.md` 里的数字拼的，真机 `calib.json` 不在仓库里；仿真相机是水平的，Y+70 当成"物块在下方"处理，真机相机可能是俯视的
- K230 水平半视场 21° 是按 `ROTATE_DEG = 90` 和 `FOCAL_PIX` 算的，没有实测；加密搜索角的收益依赖它
- 危险判定线（600mm、90°、60mm、3m）是我定的估计值

## 8. 没改、留给真机 / 后续的

| 项 | 为什么没改 | 建议 |
|---|---|---|
| `config.py` 的 `FOV_X/Y_DEG = 35/25` 和转 90° 后的画面不符 | 只有仿真用；改了会动所有仿真基线 | 和任务 13（在改 sim）一起改成 21/34 |
| 默认 `SEARCH_BASE_DEG = [0, ±55, ±85]` | 改默认会改无底盘以外的行为基线 | 真机在 `calib.json` 里写 `[0, -35, 35, -70, 70]`（已加进白名单） |
| 连续模式下 `DeviceError`（例如底盘被平台卡住超时）3 秒后自动重来 | 改了影响无底盘的恢复逻辑 | 手册要求先 `--once`；需要时加"同一种设备错误连续 N 次就退出" |
| 电池电压只在启动时检查 | 跑的过程中掉到 22V 以下不会停 | 真机跑一段时间看掉压速度再决定 |
| 深度轴一步最多 400mm | 真机对准要用；有了问题 1~3 的保护 | 第一次上车如果不放心，可以在 `config.py` 临时改小（`AXES["d"]["max"]` 不在 calib 白名单里） |
| `kill -9` / 断电 / USB 掉线 | 树莓派端无能为力 | 只能靠使能开关；手册第 0 节 |

## 9. 改了哪些文件

| 文件 | 改动 |
|---|---|
| `raspberrypi/grasp/task.py`（CRLF） | 问题 1~4：深度轴 ghost 检查、有底盘时搜索复核、走完后深度跳变确认、搜索累计后退上限 |
| `raspberrypi/grasp/config.py`（CRLF） | 5 个新开关 + 2 个参数，加进 `CALIB_KEYS`；`SEARCH_BASE_DEG` 加进 `CALIB_KEYS` |
| `raspberrypi/grasp/devices.py`（CRLF） | 问题 5：`drive()` 中途回传中断停车报错（+4 行） |
| `raspberrypi/grasp/main.py` | 问题 6：`install_stop_signals()`，真机运行时安装 |
| `raspberrypi/grasp/chassis_test.py` | 补全（第 4 节） |
| `raspberrypi/grasp/test_chassis_rehearsal.py` | 新增：场景统计 + 危险动作测试 + chassis_test 计算测试 |
| `raspberrypi/grasp/selftest.py`（CRLF） | 调用 `test_chassis_rehearsal`（quick 只跑危险动作检查，完整模式加场景统计） |
| `docs/底盘联调手册.md` | 新增 |
| `raspberrypi/README.md`、`docs/抓取与调试方案.md` | 文件表、第 8 步、第 4 节指向手册 |

提交：两个安全修复单独提交（`96958d8` 问题 1/2/4/5/6，`be74e86` 问题 3），然后是测试 / 脚本、文档。
