AULAGE/dache/docs/cloud_tasks/results/17_报告.md

# 任务 17 报告：上车前代码审查

分支：`cloud/17-code-review`（基于 `572c19c`）
范围：`raspberrypi/grasp/` 全部代码（main / task / devices / config / servo / calib / bench / recorder / chassis_test）和 `k230_sdcard/main.py`。
方法：逐文件读代码 → 有疑问的地方用假串口 / 仿真构造场景（新文件 `raspberrypi/grasp/test_review.py`，18 个用例）。

> **所有结论都只在仿真和假串口上验证过，未在真机验证。**

## 结论（先看这里）

- 修了 **4 个问题**（3 个会伤硬件、1 个会报错退出），每个一个提交，都只动了几行：

  | 提交 | 类别 | 问题 |
  |---|---|---|
  | `修复：升降轴复位（READY）后不再自动接着跑` | 伤硬件 | 升降轴断电重启后零点错了，程序 3 秒后接着跑，滑台可能撞顶 |
  | `修复：systemctl stop / SSH 断开时也走停车流程` | 伤硬件 | SIGTERM / SIGHUP 直接杀进程，底盘最后一帧是行驶帧，固件会一直按它跑 |
  | `修复：底盘行驶中回传中断时立即停车` | 伤硬件 | 回传断了，里程不涨，会全速开到超时（一步最多多开 2 米） |
  | `修复：一直抓模式下串口异常 / 重开设备失败不再直接退出` | 报错退出 | `SerialException` 不是 `DeviceError`，冲出主循环；重开时打开一半失败还会漏掉旧的 K230 读线程 |

- **合并带来的最大问题（会抓错，没修）**：底座有死区时，`GHOST_CHECK` 会把真物块判成 ghost；
  再打开任务 10 的 `GHOST_FINGERPRINT`，真物块的位置会被记成指纹存进 `logs/ghosts.json`，**以后一直被当成"没看到"**。
  仿真（真机标定值 + 底座死区 50us）：ghost 指纹关时 63/100 次停在 ghost；指纹开时 42/100 次 lost，真物块被过滤 255 次。
  → **明天先别开 `GHOST_FINGERPRINT`**（见最后的风险清单）。
- 其他合并交互（09 消回差 / 最小步长 / 试探 / 学习 / 三点插值 + 10 指纹 + recorder + `LIFT_LIMIT_SLACK_MM` 全开）
  在仿真里跑 3 组 × 100 次，**没有出现异常退出**。
- 改动前后仿真结果完全一样（改的都是异常路径）：`main.py --sim 100 --no-chassis` 都是 94/100，`--sim 60` 都是 53/60。

## 验收

| 测试 | 结果 |
|---|---|
| `python3 selftest.py` | 通过 143 项，失败 0 项（仿真回归 4 项和改之前数字完全一样） |
| `python3 test_recorder.py` | 通过 16 项，失败 0 项 |
| `k230_sdcard/tests/test_k230.py` | 43 个用例 OK（没改 K230 程序） |
| `python3 test_review.py`（新） | 18 个用例 OK |

换行：`devices.py` 是 CRLF，改完仍是全 CRLF；`main.py` / `bench.py` / `chassis_test.py` 是 LF，保持 LF。新文件 `test_review.py` 用 LF（和 `test_recorder.py` 一样）。

---

## 问题清单（按严重程度）

编号后面写 **[已修]** 的是这次改了代码的；其余只报告。"复现"一栏的 `test_review.py` 用例名可以直接跑：
`python3 test_review.py TestReportedNotFixed.test_xxx -v`。

### 一、会伤硬件

#### H1 [已修] 升降轴复位（READY）后自动接着跑，零点可能是错的
- **现象**：升降轴下位机断电重启（`READY ... RST POR`）后固件认为自己在 0cm（readme："断电后重新上电，认为在最下端，可以直接运动"）。
  原来 `READY` 被当成普通 `DeviceError`：`main.py` 一直抓模式关设备、3 秒后重开、接着 `run_once`；`bench.py` 下一个位置也接着测。
  滑台如果复位时在 30cm，之后发 `A 44` 会再往上走 44cm → 撞到顶。`preflight` 也看不出来（`P` 回的是 `POS 0.00 IDLE`）。
  `grasp.service` 是 `Restart=on-failure`，带堆栈退出也会被拉起来再跑。
- **复现**：`TestLiftReset`（改之前 `run_real` 会重开设备，`opens == 2`）。
- **修复**：`devices.py` 新增 `DeviceResetError(DeviceError)`，收到 `READY` 抛它；`main.run_real` 收到后打印原因和处理办法，
  **正常退出**（退出码 0，systemd 不会重启）；`bench.py` 同样停止。普通 `DeviceError` 仍然重开再来（原行为）。

#### H2 [已修] `systemctl stop` / SSH 断开时进程被直接杀掉，底盘不停
- **现象**：SIGTERM（`systemctl stop grasp`，README 里调试前都要这么做）和 SIGHUP（SSH 断开，README 说经常发生）
  的默认处理是直接结束进程，`finally` 和 `atexit` 都不执行。底盘固件**没有串口超时**（任务 03），发送线程死掉前最后一帧是行驶帧，
  车会一直按这个速度跑；升降轴也收不到 `E`。`chassis_test.py --timeout-check` 时轮子会一直转。
- **复现**：`TestStopSignals.test_without_handler_last_frame_is_moving`（子进程里底盘行驶中收到 SIGTERM，最后一帧 vx=100）。
- **修复**：`main.install_stop_signals()` 把这两个信号变成 `KeyboardInterrupt`，走和 Ctrl+C 一样的停车流程。
  `main.py` 真机运行、`bench.py` 真机、`chassis_test.py` 启动时调用；仿真不调用。测试见 `TestStopSignals`（SIGTERM、SIGHUP 最后一帧都是停车帧）。

#### H3 [已修] 底盘行驶中回传中断，会全速开到超时
- **现象**：`WheeltecChassis.drive()` 开始时有回传，就按回传积分的里程判断走够没有。行驶中回传断了（USB 半掉、控制器卡住），
  里程不再增加，剩余距离一直不变，会以 `CHASSIS_SPEED_MM_S` 一直发指令，直到超时：400mm 的一步超时 = 400/30×1.5+3 ≈ 23 秒 ≈ **多开 2 米**。
  `CHASSIS_CMD_TTL_S` 防不住（指令一直在刷新）。
- **复现**：`TestChassisFeedbackLoss`（改之前 8 秒后才报"底盘移动超时"）。
- **修复**：行驶中 `has_feedback()` 为假（0.5 秒没收到状态帧，和启动检查同一个标准）就抛 `DeviceError`，`finally` 照常发 0。
  `SimWheeltec.has_feedback()` 恒为真，仿真不受影响。

#### H4 底盘 USB 线断开时车保持最后速度（固件限制，软件没法修）
- 发送线程写失败时固件收不到停车帧，又没有串口超时。这是厂家固件的问题（`底盘代码/` 只读）。
- **建议**：底盘联调（任务 18）时第一次先把车架空；底盘 USB 线用扎带固定；手边留底盘电源开关。

#### H5 机械臂没有急停
- Ctrl+C / 出错时机械臂停在当前姿态（Lobot 板子没有急停指令、也不回传）。如果当时是伸出姿态，爪子会一直压在平台 / 物块上。
  下一次 `run_once` 第一个动作是 `go_observe(0)`，先收回再动升降轴，所以**不会带着伸出的手臂升降**（已检查每个阶段）。
- **建议**：只报告。手动停止后如果爪子压着东西，用 `calib.py pose observe` 收回。

#### H6 消回差会让底座多转出 `BASE_BACKLASH_DEG`，超过 `BASE_LIMIT_DEG`
- `_arm()` 在底座已经转到 ±85° 时仍会先多转 `BASE_BACKLASH_DEG` 再转回来。默认 `BASE_CENTER=1500`、2° 时最多到 2466us，
  在舵机 500~2500 以内；但 `BASE_CENTER` 标定得偏、或者回差设得大时会被 `Arm.move` 截到 2500，截断后消回差也不完整。
- **建议**：`BASE_BACKLASH_DEG` 先用 1~2°；以后可以把"转过头"的目标也限制在 `BASE_LIMIT_DEG` 里（会抓错类改动，没做）。

### 二、会抓错

#### W1 底座死区让 GHOST_CHECK 误判，GHOST_FINGERPRINT 把真物块记成指纹（合并交互，最重要）
- **原理**：`align()` 里底座动了、读数几乎没变（< 30% 预期）连续 2 次 → 判 ghost。真机标定灵敏度 −0.6 时，
  只有 ≥ 2.5° 的底座步子才参加检查，而真机已知"底座小角度（< 5°）转动不到位"——正好落在这个区间。
  真物块被判 ghost 后，`GHOST_FINGERPRINT=True` 会把**真物块的读数**记进 `logs/ghosts.json`，以后在这个位置附近（±1.5°、±6mm、±15mm）
  的真物块一律当作没看到；`GHOST_FP_MIN_HITS=1`，记一次就生效，而且跨运行保存。
- **复现**：`TestReportedNotFixed.test_ghost_fingerprint_learns_real_block_when_base_has_deadband`。仿真（真机标定值 R=0、灵敏度 −0.6、底座方向 −1，`SIM_SERVO_DEADBAND_US=50`，5 台车 × 20 次）：

  | 设置 | 结果 |
  |---|---|
  | 死区 5us，指纹关 / 开 | 成功 93，ghost 0（两者一样） |
  | 死区 50us，指纹关 | 成功 36，**ghost 63** |
  | 死区 50us，指纹开 | 成功 27，ghost 28，**lost 42**；记下 28 个指纹，真物块被过滤 255 次 |
  | 死区 50us，指纹开 + `BASE_MIN_STEP_DEG=5` | 成功 63，ghost 16，lost 18 |

  （仿真里根本没有"爪子被识别成物块"，所以这些 ghost 全是误判。50us 是估计值，真机死区多大要看 `recorder.py backlash`。）
- **建议**：
  1. 明天先别开 `GHOST_FINGERPRINT`；`GHOST_CHECK` 保持开（它只是停下，不会记仇），但出现"底座动了两次读数没变"时先怀疑死区。
  2. 修法（下一步）：只在**升降轴**（y，丝杠很准）判定 ghost 时记指纹；或者记指纹前把执行器回到原位再测一次，读数仍不变才记；
     `GHOST_FP_MIN_HITS` 默认改成 2。
  3. 真要开，每轮跑完看一眼 `logs/ghosts.json`，记的是爪子脚（画面左侧中间，x 明显为负）还是物块位置。

#### W2 开了试探 / 学习时 bench 统计会被带偏
- `bench.csv` 的 `trim_deg` 列只记固定微调 `GRASP_BASE_TRIM_DEG`，不记学到的分段微调和试探量（`task.last_grasp` 里有 `trim_total_deg` / `probe_mm`，没写进 CSV）。
  人工报的"偏左 / 偏右"是最后一次（可能是试探过的）伸出的落点，`bench.py report` 按它给出的 `calib.py trim` 建议会错。
- **建议**：用 bench 做基线时关掉 `GRASP_PROBE_MM` / `TRIM_LEARN`；以后在 `FIELDS` 里加 `trim_total_deg`、`probe_mm` 两列，统计时扣掉试探量。

#### W3 升降轴离上限不到 5cm 时，观察确认在更低的高度看
- `grasp()` 合爪后 `move_by(+5)` 被 `LIFT_MAX_CM` 截断，`_observe_check()` 却按满 5cm 往下降，结果比抓取时低；放置后 `_lower_back()` 再降 5cm。
  真机 6mm/cm，低 3cm ≈ 物块在画面里偏 18mm，而"还在原位置"的判据是 |Δy| < 30mm，容易误判"抓到"。
- **复现**：`TestReportedNotFixed.test_lift_clamp_makes_observe_check_lower`（42cm 抓 → 44 → 39）。
- **影响**：明天在低平台上升降轴在下半段，碰不到。**建议**：抓取时记下实际抬了多少（`move_by` 返回值差），按实际值降回。

#### W4 指纹过滤会骗过观察确认
- `VERIFY="observe"` 时，原位置物块的读数如果正好在某个指纹里，`measure()` 返回 None → 判"原位置没有物块了 → 抓到"（误报）。是 W1 的后果，同样靠"先别开指纹"规避。

#### W5 `LIFT_LIMIT_SLACK_MM=15` 是按 10mm/cm 定的
- 真机升降灵敏度约 6mm/cm，15mm ≈ 2.5cm 的高度误差也会"按已对准处理"去抓。只在升降轴到 0 / 44cm 时生效，低平台上一般碰不到。
- **建议**：真机改成 9mm 左右（≈ 1.5cm），写进 `calib.json`（已在白名单）。

### 三、会报错退出

#### E1 [已修] 一直抓模式下串口异常 / 重开失败直接带堆栈退出
- **现象**：
  1. `run_real` 只接 `DeviceError`。pyserial 的 `SerialException` 是 `OSError`——升降轴 USB 掉线时 `readline()` / `write()` 抛的就是它；
     `ARM_USB_ROBUST=False` 时机械臂连续掉两次也抛它（config 注释里写着"主程序退出"）。都会冲出主循环。
  2. 设备错误后重开，`open_devices` 抛错（USB 正在重新枚举、J-Link 串口暂时不在）不在 try 里，直接退出。
  3. `open_devices` 打开一半失败时，已经打开的 K230 读线程不会停；如果被重试，**两个线程抢同一个串口**，帧会被拆碎。
- **复现**：`TestReopenAndSerialErrors`（改之前 2 个 ERROR、1 个 FAIL）。
- **修复**：`run_real` 和 `bench.RealRig` 把 `OSError` 和 `DeviceError` 一样处理（关设备、3 秒后重开）；
  已经通过启动检查之后重开失败就等 3 秒再试；第一次打开失败、`--once` 仍按原样报错；`open_devices` 失败时关掉已打开的设备。

#### E2 `REACH_NEAR_D == REACH_FAR_D` 时 `reach_pose` 除零（没修，概率很小）
- `calib.py teach` 两次深度四舍五入后正好相等才会发生（"不标远处"分支会设成 near+70，不会相等）。`goal_for` 有这个保护，`reach_pose` 没有。
- **复现**：`test_reach_pose_divides_by_zero_when_near_equals_far`。**建议**：`reach_pose` 里分母为 0 时直接用 `reach_near`。

#### E3 `calib.json` 里 `TOL` / `GHOST_FP_TOL` 只写一部分轴会整体替换（没修）
- 例如写 `"TOL": {"x_deg": 2.0}`，`y`、`d` 就没了，第一次 `in_tol()` 就 `KeyError` 退出。`calib.py` 自己不会写出这种文件，手改时会。
- **复现**：`test_partial_tol_in_calib_json_crashes`。**建议**：`_apply_calib` 对字典型参数（`TOL`、`GHOST_FP_TOL`、`GOAL*`）做合并而不是替换；或者 `--check` 时检查键齐全。

#### E4 日志写不进去（SD 卡满 / 只读）时会出错
- `_save_trim()`、`recorder.write()`、`steps.csv` 写失败抛 `OSError`。修 E1 之前是直接退出；修之后会被当成设备错误，关设备、3 秒后重开、再失败……
  一直循环（不危险，但抓不了）。`--record` 每帧都写 jsonl，长时间开着要留意空间。
- **建议**：明天开 `--record` 前 `df -h` 看一下；以后记录器写失败只打印一次、不抛出。

### 四、体验问题

1. **`calib.json` 里不在白名单的键静默忽略**。白名单外还有不少可能想调的：`SETTLE_S`、`SAMPLE_N`、`MAX_ALIGN_STEPS`、`MAX_ATTEMPTS`、
   `BASE_LIMIT_DEG`、`BASE_RECENTER_DEG`、`SEARCH_LIFT_CM_NEAR`、`SEARCH_BASE_DEG_NEAR`、`VERIFY_DY_MM`、`VERIFY_SAME_D_MM`、`CHASSIS_SPEED_MM_S`。
   写错名字也不报。**建议**：`main.py --check` 打印 calib.json 里被忽略的键。
2. `SEARCH_LIFT_CM_NEAR` 里的 45cm 大于 `LIFT_MAX_CM=44`，被静默截到 44（多看一次 44cm），无害。
3. `preflight` 看不出升降轴是不是在半空被断过电（固件 POR 后报 0cm）。**上电前确认滑台在最下端**（readme 的要求），H1 只能管运行中的复位。
4. 仓库里 Python 文件换行不统一（`config/devices/selftest/servo/sim/sim_compare/task` 是 CRLF，其余 LF）。这次按原样保持，没有统一。
5. 机械臂板 `ARM_USB_ROBUST` 默认关。现在用 J-Link 虚拟串口，比 CH340 稳；E1 修完后连续掉两次也只是重开设备，不再退出。

---

## 异常路径：每种情况最后的状态

| 情况 | 升降轴 | 底盘 | 机械臂 | 程序 |
|---|---|---|---|---|
| 任意阶段 Ctrl+C（`TestCtrlCEveryStage`：无底盘 29 个、有底盘 21 个动作点逐个注入，含底盘行驶途中） | 发 `E` 急停 | 指令清 0 + 直接写 3 帧停车帧 | 停在当前姿态（H5） | 退出 |
| `systemctl stop` / SSH 断开 | 同 Ctrl+C **[H2 修复后]**；之前：不停 | 同 Ctrl+C；之前：**保持最后速度** | 同上 | 退出 |
| 升降轴 READY（复位） | 已经复位停了 | 停 | 停在当前姿态 | **[H1 修复后]** 打印处理办法、退出；之前：3 秒后接着跑 |
| 升降轴回复 / DONE 超时 | 发 `E` | 停 | — | 关设备，3 秒后重开 |
| 升降轴 / 机械臂 USB 掉线（`SerialException`） | 发 `E` | 停 | — | **[E1 修复后]** 重开；之前：退出 |
| K230 连心跳都没有（2 秒） | 当前动作做完后 `E` | 停 | 可能停在伸出姿态；下一次先回观察姿态再动升降轴 | 关设备，3 秒后重开 |
| K230 只有心跳（没看到物块） | — | — | — | 搜一圈 `not_found`，等 2 秒再搜 |
| 底盘回传中断 | — | **[H3 修复后]** 立即停；之前：全速开到超时 | — | 设备错误，重开 |
| 底盘 USB 拔掉 | — | **保持最后速度**（固件，H4） | — | — |
| 手柄程序启动 | 关串口让出 | 关串口让出 | — | 等手柄断开 |

## 配置检查：真机标定值代入

把 CLAUDE.md 里的真机值（`R_CAM_MM=0`、`BASE_DIR=−1`、底座灵敏度 −0.6、升降 6mm/cm、`GOAL` 156mm/Y+70、`GOAL_FAR` 216mm/Y+43、
`REACH_NEAR_D=156`、`REACH_FAR_D=216`、`VERIFY="observe"`、`GRASP_BASE_TRIM_DEG=−1.3`）代入逐项看，并在仿真里配合 09/10 全部开关
（消回差 2°、最小步长 1.5°、试探 4mm、学习、三点插值、指纹、recorder）各跑 100 次：

- **没有异常退出**。（仿真的几何没按这个 GOAL 标定，所以这组的成功率没有参考价值，只看崩不崩；只换 R/方向/灵敏度时成功率 99/100。）
- `R_CAM_MM=0`：`s_x = 1`；几何前馈里 `max(dist − R, 50)` 不会除零；试探换算 `atan(p / (d + R))` 正常。
- `BASE_DIR=−1`：消回差的逼近方向用 `BASE_APPROACH_DIR × BASE_DIR` 换算到脉宽，正确；`recorder.py pairs` 从 config 读方向，正确。
- `GOAL_FAR`：按深度在 Y+70 ↔ Y+43 之间插值；`GOAL_MID` 只在严格介于两者之间时用，否则退回两点（有保护）。
- `TRIM_LEARN` 分段：[156, 216] 三等分 → 176 / 196mm；改了近/远深度后旧的学习文件会自动作废重学（有提示）。
- bench 测试矩阵 150 / 180 / 210mm 都在可抓范围 131~241mm 内，不会报 out_of_reach。
- 白名单：09/10 新增的参数都在 `CALIB_KEYS` 里；缺的见"体验问题 1"。

## K230 程序（`k230_sdcard/main.py`，没改）

- **忽略区域坐标换算（`ROTATE_DEG=90`）正确**：手算 `(0.00, 0.40, 0.12, 0.60)` → 原始画面 x ∈ [0.4, 0.6]·FW、y ∈ [0.88, 1.0]·FH，
  反过来 `rotate_point` 回到显示画面左侧中间；`test_k230.py` 里 0/90/270 三种旋转的往返测试都通过。
- **心跳还在**：`SEND_HEARTBEAT=True`、200ms，在主循环末尾、和位置帧共用 `last_send_time`；`test_heartbeat_frame` 通过。
  只有"图像格式不对直接 `continue`"那一个异常分支会跳过心跳，正常不会走到。
- **`IGNORE_CALIB_MODE`**（默认关）：打开后每帧对所有检测框算一次归一化坐标（很便宜），每 200ms 打印一行、每 5 秒打印一次建议区域。
  打印走 IDE 串口，会占一点时间，具体多少要在板子上看 Profiler（云端没法测）。**建议**：只在标定忽略区域时打开、把 `IGNORE_CALIB_EVERY_MS` 调到 1000，
  抓取时关掉。没接 IDE（SD 卡自启）时打印会不会阻塞**未验证**，所以别在自启状态下开它。
- 真物块中心进入忽略区域时也会被丢掉、跟踪器放弃（设计如此）：物块在画面左侧中间时看不到，转底座后会回到中间，不影响对准。

---

## 明天真机的风险清单

### 先别开
| 开关 | 原因 |
|---|---|
| `GHOST_FINGERPRINT` | W1：底座死区会让真物块被记成指纹、以后一直看不到。要开也等 `BASE_MIN_STEP_DEG` 调好之后，并且每轮看 `logs/ghosts.json` |
| bench 时的 `GRASP_PROBE_MM` / `TRIM_LEARN` | W2：bench 统计和 trim 建议会被试探带偏。试探和学习用 `main.py` 单独跑，别和 bench 基线混在一起 |
| K230 `IGNORE_CALIB_MODE` | 只在标定忽略区域时开，抓取时关 |

### 可以开，但守着
| 开关 | 开的时候看什么 |
|---|---|
| `BASE_MIN_STEP_DEG`（先 2~3°） | 对准时底座有没有来回摆（日志"对准 #n"里底座角度正负交替） |
| `BASE_BACKLASH_DEG`（先 1~2°） | 底座转到 ±85° 附近时有没有顶到东西（H6）；每次对准多花的时间 |
| `--record` | 先 `df -h`；结束后 `python3 recorder.py summary` 看事件数对不对 |
| `GRASP_BASE_TRIM_DEG`（已在用） | 改 trim 之后 bench 换一轮（`report --round`） |

### 建议的顺序
1. `git pull` 后先在树莓派上跑 `python3 selftest.py quick` 和 `python3 test_review.py`。
2. **升降轴上电前确认滑台在最下端**。`python3 main.py --check`。
3. 所有新开关关着，`python3 main.py --once --step --no-chassis` 跑一次，确认新代码没改变原来能用的流程。
4. `python3 bench.py --positions 2,5,8` 做基线（新开关都关）。
5. 一次只开一个开关，再跑同样的位置对比：最小步长 → 消回差 → （`main.py` 里）试探 + 学习 → 最后才考虑指纹。

### 跑的时候守着
- 手放在升降轴急停 / 电源旁边。出现"设备复位"时按提示处理：**先确认滑台位置再重开**，不要直接再运行。
- 日志里出现"K230 识别到的很可能是机械臂自己"时，看 IDE 画面框的是爪子脚还是物块：是物块 → 多半是底座死区（W1），记下来。
- 底盘联调（任务 18）：第一次架空轮子跑 `chassis_test.py`；底盘 USB 线固定好（H4）；现在 SSH 断开 / `systemctl stop` 会停车了（H2），
  但拔 USB 线仍然不会停。
