AULAGE/dache/docs/cloud_tasks/results/11_报告.md

# 任务 11 报告：动作-响应模型原型（论文方案 v2 第 3.4 节的轻量概率基线）

> 分支 `cloud/11-action-response`。**全部结论来自仿真，没有在真机上验证**；所有仿真参数（回差、死区、噪声、爪子脚出现概率……）都是估计值，第 5 节写了怎么在真机上测。
> 新代码全部在 `raspberrypi/grasp/research/`，没有改 `task.py` / `devices.py` / `main.py` / `config.py`。
> 唯一改动的旧文件是 `selftest.py`：按任务要求加了**可选**的 `python3 selftest.py research`（+19 行，保持 CRLF）；不带参数时行为不变。

## 0 一句话结论（仿真）

1. **爪子脚问题**：只要 K230 把所有检测框都给树莓派（现有协议做不到，见第 6 节），"动作-响应"概率模型能把成功率从 66% 提到 99%（爪子脚可见的回合从 13% 提到 97%）。
   在现有 K230 单目标输出上，概率模型只能决定"停不停"，效果和 ghost 规则**差不多**（正常回差下 65% vs 66%），但回差加大 2 倍时误报中止从 6.0% 降到 0.8%。
2. **迟滞辨识**：随机激励 10~20 步就能把底座回差估到 ±0.1°、J 估到 2% 以内；对舵机真实输出角的估计误差 0.03°，开环（把命令当实际位置）是 0.8°——这就是论文 H1 "视觉本体感知"的雏形。
   task.py 现有自适应 J 因为回差吃掉了一部分动作，有 13~17% 的系统偏差。
3. **逆迟滞补偿**：底座对准步数 1.65 → 1.01（容差 1.5°），收紧到 0.5° 时 4.4 → 1.04 步；最终角度误差 0.55° → 0.18°。
4. **结果监督标定**：纯利用（一直瞄准当前估计）学不到偏哪边；固定 ±4mm 探测 20 次抓取后残差误差约 0.9mm、标定期间成功率 88%。
   信息增益策略在模型参数（爪子余量、落点噪声）设错时**不如**固定探测稳健。
5. 去掉迟滞模型的消融：正常回差下成功率 99.0% → 96.4%，回差加大 2 倍时 98.4% → 82.7%（seed 1：98.9% → 72.2%）。

---

## 1 做了什么

| 文件 | 内容 |
|---|---|
| `research/sim_world.py` | 可复现的仿真世界：每台车的 J、回差 b、死区 δ（底座 + 升降轴）；真目标、另一个静止方块、爪子脚（与相机固连）、乱动的手；K230 7 帧/秒、丢帧、碰边缘不发、动作中模糊、单目标跟踪器 |
| `research/hysteresis_id.py` | 执行器假设库：(b, δ) 网格 × 共轭高斯 J，在线贝叶斯辨识；逆迟滞补偿（单步 / 单向逼近两步） |
| `research/association.py` | 窗口聚类、跨动作轨迹关联（动作条件门限）、P(T/S/D) 递推；task.py ghost 规则的复现；三种对准代理 |
| `research/outcome_calib.py` | 抓取成败 → 残差 r 的网格后验；纯利用 / 固定 ±p / 信息增益 / 带成功率约束的信息增益 |
| `research/run_experiments.py` | 跑全部实验输出 Markdown 表（`--seed`、`--quick`、`--only`、`--out`、`--png`） |
| `research/test_research.py` | 14 项 unittest；`selftest.py research` 会调用 |

**和 `sim.py` 的关系（复用而不是复制）**：检测框噪声直接调 `sim.SimCam._box_of`，K230 跟踪器直接用 `sim._Tracker`，舵机死区 + 回差直接调 `sim.SimArm._servo_base`，
帧率、动作中检出概率、K230 常数都从 `config` / `sim` 读；测量窗口中值用 `devices._median_measure`，控制律用 `servo.AdaptiveAxis`（`build_axes`）。
只有"框 → 位置帧"那 6 行（碰边缘不发、尺寸法测深）在 `sim.SimCam._frame` 里是内联的，没法调用，照抄在 `sim_world.k230_readout`。
`test_research.py` 有一项专门检查辨识器里的快速迟滞模型和 `sim.SimArm._servo_base` 逐步完全一致。

**运行**
```bash
cd raspberrypi/grasp
python3 selftest.py                       # 原有 89 项，全部通过（行为不变）
python3 selftest.py research              # 原有 89 项 + research 单元测试，共 90 项全部通过
python3 research/run_experiments.py --seed 0     # 全部实验，约 90 秒，只用标准库
```
没有 numpy / matplotlib 也能跑（云端环境没有 matplotlib，`--png` 会提示跳过）。

---

## 2 算法推导

### 2.1 执行器模型（每个轴相同；底座单位 °，升降轴单位 cm）

电机位置 m、输出轴位置 o、绝对命令 c：

$$m \leftarrow \begin{cases} c, & |c-m| > \delta \\ m, & \text{否则（死区）}\end{cases}\qquad
o \leftarrow \operatorname{clip}\big(o,\ m-\tfrac b2,\ m+\tfrac b2\big)\ \text{（回差：输出轴在宽 b 的间隙里被推着走）}$$

画面位移 $\Delta z = J\,\Delta o + \varepsilon$，记作 $\Delta o = g(u; b, \delta, \text{历史})$。同一条命令的结果取决于历史（换向时先走完间隙），
真机"命令 +4.8° 只修正约 1.6°"就是这个现象。这个规则和 `sim.py` 原有的舵机模型完全相同（单元测试逐步比对）。

### 2.2 辨识：假设库贝叶斯（`hysteresis_id.HysteresisBank`）

- 把 (b, δ) 取网格 $h$（底座 0~6° × 0~4°，比仿真里真实范围宽，不偷看）。给定 $h$，$g$ 是确定的：用**真实发过的命令序列**推出每一步的 $\Delta o_{h,k}$。
- 对每个 $h$，J 用共轭先验 $J\sim N(J_0, s_J^2)$，观测 $\Delta z_k = J\Delta o_{h,k}+\varepsilon$ 是线性高斯，边缘似然有闭式。只需维护
  $S_{xx}=\sum\Delta o^2,\ S_{xy}=\sum \Delta o\,\Delta z,\ S_{yy}=\sum\Delta z^2$：

$$P_h = \frac1{s_J^2}+\frac{S_{xx}}{\sigma^2},\quad \hat J_h=\frac{J_0/s_J^2+S_{xy}/\sigma^2}{P_h},\quad
\log p(\Delta z_{1..k}\mid h) = -\tfrac12\Big(\frac{S_{yy}}{\sigma^2}+\frac{J_0^2}{s_J^2}-\hat J_h^2P_h\Big)-\tfrac12\log(P_h s_J^2)+\text{常数}$$

- 后验 $w_h\propto p(h)\,p(\Delta z\mid h)$，每步 O(网格大小)。初始状态靠"预紧"：先往负方向走一大步再回来，输出轴必然贴在间隙负侧 $o=m-b/2$。
- **输出位置估计**（H1 雏形）：$\hat o=\sum_h w_h\,o_h$，即不装编码器、只靠命令历史 + 画面位移推断舵机真实输出角。
- 只用"已确认是真目标"（$P(T)\ge0.95$）的轨迹位移来学习 —— 自监督，不用标注。

### 2.3 逆迟滞补偿（`HysteresisBank.plan`）

想让画面移动 $\Delta z^*$。对后验最大的 K 个假设各自解析求命令：
$\Delta o^*=\Delta z^*/\hat J_h,\ o^*=o+\Delta o^*,\ s=\operatorname{sign}\Delta o^*$；
- 单步：$c=o^*+s\,b/2$（推着间隙的一侧走到位），要求 $|c-m|>\delta$；
- 两步（单向逼近）：先反向退 $r=\min(m,c)-\delta-b-0.3$（正向时），再走到 $c$ —— 小于死区的小步、或换向时用。

把这些候选命令在全部 K 个假设下前向推演，选期望代价最小的：
$\mathbb E_h\big[(\hat J_h\Delta o_h(c)-\Delta z^*)^2+\operatorname{Var}(J_h)\Delta o_h(c)^2\big]$（两步的代价乘 1.02，同样准时优先一步）。命令按舵机分辨率（1/11.1°）量化。

### 2.4 数据关联：P(目标 T / 自身 S / 干扰 D)（`association.py`）

每走一步（命令已知），比较一条轨迹在动作前后两个测量窗口的位移 $\Delta z=(\Delta x_{\deg},\Delta y)$：

$$p(\Delta z\mid T)=(1-\rho)\,\frac1{|\Lambda|}\sum_{\lambda\in\Lambda}\prod_{a\in\{x,y\}}\sum_h w_h\,N\!\big(\Delta z_a;\ \lambda\hat J_h\Delta o_h,\ \lambda^2\operatorname{Var}(J_h)\Delta o_h^2+\sigma_a^2\big)+\rho\,p(\Delta z\mid D)$$
$$p(\Delta z\mid S)=N(\Delta z;0,\sigma^2),\qquad p(\Delta z\mid D)=N(\Delta z;0,\sigma_D^2+\sigma^2)$$
$$P_k(c)\propto P_{k-1}(c)\,p(\Delta z_k\mid c),\quad\text{再与先验混合 } \varepsilon=0.02$$

- **关键性质**：命令被死区 / 回差吃掉时，假设库预测 $\Delta o\approx0$，T 和 S 的似然几乎相等 → 这一步**不提供证据**（单元测试 `test_lost_motion_is_not_evidence`）。
  现有 ghost 规则只看"预测 |J·u| 够大、实测 < 30%"，会把这种情况记一次 strike。
- $\Lambda$：K230 单目标输出有跟踪器 EMA 滞后，动作后测到的位移常只有真实的 55~100%（仿真里发现的，见第 6 节），所以对 K230 流把"测到的比例" λ 当未知量混合 {0.55, 0.7, 0.85, 1}；原始框 λ = 1。
- $\rho=0.05$：稳健化。真目标偶尔有一步"模型解释不了"（假设库还没学好、K230 一帧换了目标），混一个宽分布后单步最多把 T:D 比值压低 20 倍，不会一步翻盘。
- **跨动作的关联也用动作**：一条轨迹在下一个窗口里要么没动（S），要么按预测动了（T，含 λ），取马氏距离小的做门限；已确认是 T/S 的轨迹不走宽松的 D 门限（跳变更可能是 K230 换了目标 → 开新轨迹）。
  所以底座转 20° 后也能接上，不需要像素级连续跟踪。
- **主动探测**（多框模式）：对准到容差内但 $P(T)<0.9$ 时，用升降轴 ±0.8cm 探一下（升降轴回差小，探测最干净）——"以动作为测量"。

三种对准代理用**同一个控制律**（`servo.AdaptiveAxis`，即 task.py 的 P 控制 + 学 J），只换"判断锁的是什么"的部分：

| 代理 | 观测 | 判断 | 能做什么 |
|---|---|---|---|
| `ghost` | 现有 K230 单目标输出 | task.py ghost 规则（两步无响应即停，阈值照抄） | 只能停（task.py 停整回合） |
| `p_k230` | 同上 | P(T/S/D)，P(T) < 0.05 且至少 2 步证据才停 | 只能停 |
| `p_raw` | K230 发出**所有**框 | P(T/S/D) 多轨迹，锁 P(T) 最大的 | 换目标、主动探测；P(T) ≥ 0.9 才确认 |

### 2.5 结果监督的残差标定（`outcome_calib.py`）

抓取时故意瞄准偏移 e（相对对准后的位置，可以用底座微调实现），成败 $s\sim\text{Bernoulli}\big(\Phi((w/2-|e-r|)/\sigma)\big)$；
网格后验 $p(r\mid\cdot)\propto N(r;0,6^2)\prod_k P(s_k\mid e_k,r)$，估计取后验均值。下一次的 e：

- 纯利用 $e=\hat r$；固定探测 $e=\hat r\pm p$ 交替（p = 4 / 8mm）；
- 信息增益 $e=\arg\max_e\ H(\bar p(e))-\mathbb E_r[H(P(s\mid e,r))]$（H 为二元熵）；
- 信息增益（约束）：只在预测成功率 ≥ 0.6 的 e 里挑。

---

## 3 仿真设置和估计参数

| 量 | 仿真取值 | 依据 | 真机怎么测 |
|---|---|---|---|
| 底座 J（画面° / 底座°） | U(−1.1, −0.45) | 真机标定约 −0.6 | 已有：`calib.json` |
| 底座回差 b | U(0.5, 3)° | 估计（命令 +4.8° 只修正 1.6°） | 激光笔贴底座照 2m 外的墙（1° ≈ 35mm）：正向小步走 → 反向小步走，画出命令-光点曲线；或第 5 节的电位器 ADC |
| 底座死区 δ | U(0.5, 2)° | 估计 | 同上，从同一方向每次 +0.1° 累加，看光点什么时候开始动 |
| 升降 J | U(4, 8) mm/cm | 真机标定约 6 | 已有 |
| 升降回差 / 死区 | U(0.05, 0.3) / U(0.02, 0.15) cm | 估计（丝杠，估得偏大） | 百分表 / 游标卡尺顶住升降台，往返 0.05cm 小步 |
| 动作落点随机误差 | 底座 0.15°、升降 0.01cm | 估计 | 同一命令往返 20 次看激光点散布 |
| 检测框边像素噪声 | 2 px（sim.py 默认 0.5） | 估计 | 物块静止，K230 连续 200 帧位置的标准差 |
| K230 EMA 滞后 | 由 `sim._Tracker` 产生 | 板子程序同款 | 同步线（第 5 节）对齐命令时刻，看 K230 输出的阶跃响应 |
| 爪子脚每回合处于可见状态的概率 | 每台车 U(0.1, 0.5) | 估计（"偶尔"） | K230 存图后人工数；或 `OBSERVE_CLAW=open` 下统计 ghost 次数 |
| 爪子脚 / 方块 / 手的检测置信度 | 0.7 / 0.8 / 0.6 | 估计（爪子脚框大，K230 按 置信度×√面积 选框时容易选中它） | K230 IDE 里看 YOLO 输出 |
| 手每步移动 | 3°, 15mm | 随便设的 | — |
| 抓取余量 w/2、落点噪声 σ | 8mm、3mm | 估计（sim.py GRIP_TOL y = 8mm） | `bench.py`：同一位置按 trim −12…+12mm 每 2mm 抓 5 次，拟合 Φ 曲线 |
| 真实残差 r | 每台车 U(−6, 6) mm | 真机约 +4mm | 第 5 节 E4 |

简化（都会让仿真比真机乐观或不同，写在这里）：只看观察姿态下的对准（升降 + 底座），没有底盘、深度不对准；动作期间位置线性插值；
手的运动是随机游走；"另一个静止方块"被锁定也算成功（动作响应规律和目标一样，靠动作分不开，要靠外观或任务规则，见第 6 节）；
辨识 / 补偿实验假设关联已解决（只用真目标的原始检测）；每回合开始底座回正（和 task.py `go_observe(0)` 一样）。

---

## 4 仿真结果（seed 0；seed 1 的关键数字在括号里；完整输出见附录）

### 4.1 数据关联（10 台随机车 × 200 回合，三种方法在同样的场景上配对比较）

| 方法 | 对准到方块并确认 [95%CI] | 误锁（自身/手） | 正确中止 | 误报中止 | 爪子脚可见回合的成功率 | 首次正确锁定步数 | 平均步数 |
|---|---|---|---|---|---|---|---|
| 现有 ghost 规则（K230 单目标） | 66.0% [64, 68]（60.6%） | 0.3% | 30.4% | 0.6% | 12.7%（11.9%） | 0.09 | 2.18 |
| 概率模型（K230 单目标，只能停） | 65.3% [63, 67]（60.6%） | 0.2% | 32.0% | 0.5% | 12.3%（12.2%） | 0.05 | 2.04 |
| 概率模型（多框 + 换目标 + 主动探测） | **99.0%** [98, 99]（98.5%） | 0.0% | 0.9% | 0.0% | **97.3%**（96.0%） | 0.51 | 3.04 |
| 消融：多框，但去掉迟滞模型 | 96.4% [95, 97]（95.2%） | 0.0% | 1.5% | 2.0% | 94.9%（92.7%） | 0.55 | 3.29 |

**底座回差、死区放大 2 倍**（10 × 100 回合，对应 H3 "人为加大回差"）：

| 方法 | 成功 | 误报中止（其实是方块） | 平均步数 |
|---|---|---|---|
| 现有 ghost 规则 | 61.5%（59.7%） | **6.0%**（3.2%） | 2.59 |
| 概率模型（K230 单目标） | 65.2%（60.5%） | **0.8%**（1.7%） | 2.76 |
| 概率模型（多框） | 98.4%（98.9%） | 0.9%（0.7%） | 3.99 |
| 消融：多框，去掉迟滞模型 | **82.7%**（72.2%） | 12.6%（20.2%） | 4.57 |

读法：
- 现有系统失败的主因是"一开始就锁了爪子脚"，ghost 规则能识别出来（"正确中止"约 30%），但 task.py 只能停。真正的提升来自**能换目标**，前提是看得到所有框。
- 在单目标流上，概率模型和 ghost 规则在正常回差下打平；回差变大时 ghost 规则把"命令被回差吃掉"误当成幽灵（误报 6%），概率模型因为知道"这一步预计不会动"所以不误报。
- 代价：多框模型要多确认，成功回合平均晚 0.4 步才"确定锁对"、总步数多约 0.9 步（主动探测）。
- 消融说明迟滞模型在回差大时是必需的：只用 J 的模型会把没动的真目标当成自身。

### 4.2 迟滞辨识（10 台车 × 3 段随机激励，底座 0.3~6°/步，升降 0.03~1cm/步）

底座（°）：

| 步数 | b 误差 | δ 误差 | J 相对误差：假设库 | J 相对误差：task.py 自适应 | 输出角估计误差 | 开环（输出=命令） |
|---|---|---|---|---|---|---|
| 5 | 0.42 | 0.36 | 4.4% | 13.9% | 0.22 | 0.82 |
| 10 | 0.12 | 0.29 | 2.0% | 15.8% | 0.060 | 0.70 |
| 20 | 0.10 | 0.20 | 1.9% | 14.2% | 0.051 | 0.93 |
| 40 | 0.059 | 0.15 | 0.9% | 17.2% | 0.033 | 0.97 |
| 80 | 0.051（0.044） | 0.078（0.069） | 0.8% | 15.7%（12.7%） | 0.026（0.022） | 0.82（0.80） |

升降轴（cm）：80 步后 b 误差 0.010、δ 误差 0.026（真实 δ 只有 0.02~0.15，**几乎辨识不出来**：升降轴死区乘 J 只有 0.1~0.9mm，低于 K230 噪声）、
J 2.7%（task.py 自适应 9.8%）、输出位置估计误差 0.006cm（开环 0.072cm）。

- task.py 的自适应 J 一直有 13~17% 偏差：回差吃掉的动作被当成"灵敏度小"。这会让 P 控制每一步都走不到位（真机"对准要多走几步"）。
- δ 比 b 难辨识：只有"小于死区的小步"才提供 δ 的信息。激励里要有足够多的小步（< 2°）。

### 4.3 逆迟滞补偿（底座方位角对准，10 台车 × 100 回合，初始误差 ±2~20°）

| 容差 | 方法 | 平均步数 | 最终误差 均值 | 95 分位 | 进入容差 |
|---|---|---|---|---|---|
| 1.5° | 基线：task.py 自适应 P 控制 | 1.65（1.65） | 0.55° | 1.38° | 99.7% |
| 1.5° | 补偿（在线辨识，从先验开始） | 1.01（1.01） | 0.18° | 0.42° | 99.5% |
| 1.5° | 补偿（先激励辨识 40 步） | 1.00 | 0.17° | 0.38° | 99.5% |
| 1.5° | 补偿（真实参数，上限） | 1.00 | 0.16° | 0.37° | 99.7% |
| 0.5° | 基线 | **4.44**（4.21） | 0.33° | 0.55° | 96.5% |
| 0.5° | 补偿（在线辨识） | **1.04**（1.05） | 0.18° | 0.37° | 99.6% |

在线辨识几乎追平真值上限：对准过程本身就是激励。剩下的 0.17° 主要是动作落点随机误差（仿真设的 0.15°）。
（只做了底座；升降轴回差小，收益有限。）

### 4.4 结果监督的残差标定（10 台车 × 20 次独立标定 × 40 次抓取）

模型正确（w/2 = 8mm、σ = 3mm）：

| 策略 | 10 次后 r 误差 | 20 次后 | 40 次后 | 标定期间成功率 | 标定后成功率 |
|---|---|---|---|---|---|
| 纯利用 e = r̂ | 3.11mm | 3.11 | 3.11 | 93% | 93.1% |
| 固定探测 ±4mm | 1.17 | 0.94 | 0.69 | **88%** | 99.2% |
| 固定探测 ±8mm | 0.96 | 0.70 | 0.48 | 53% | 99.4% |
| 信息增益最大 | 1.07 | 0.71 | 0.49 | 54% | 99.4% |
| 信息增益（预测成功率 ≥ 0.6） | 0.98 | 0.70 | 0.46 | 64% | 99.4% |

模型设错（真实 w/2 = 6.5、σ = 4.5，模型仍按 8 / 3）：40 次后误差 固定 ±4：0.86，固定 ±8：**0.70**，信息增益：1.02，约束信息增益：1.02。

- 纯利用永远学不到偏哪边：瞄在平台区中心，成功只说明 |r| 不大（单元测试验证了后验左右对称）。
- 信息增益在模型正确时和 ±8mm 一样好、比 ±4mm 好，但对 w、σ 设错更敏感；**真机建议先用固定 ±4mm**（成功率高、稳健），同时把 w/2、σ 一起估（见第 6 节）。

---

## 5 真机验证计划

### 5.1 需要的数据

| 数据 | 现在有没有 | 怎么采 |
|---|---|---|
| 每条执行器命令（轴、绝对值、时刻） | 部分（`steps.csv` 只记 u） | 研究模式下树莓派按命令写 `actions.csv`（时间戳 + 序号） |
| K230 位置帧（时间戳） | 有，但只有锁定的那一个 | 现有 10 字节帧不变 |
| K230 **所有检测框** + 图像 | 没有 | K230 研究版程序把每帧所有框（类别、置信度、框）和图像存 SD 卡，带帧号 |
| 命令和 K230 帧的时间对齐 | 没有 | **同步线**（下面） |
| 舵机真实输出角（真值，只评估用） | 没有 | 电位器 / 激光笔（下面） |
| 抓取成败 + 偏差 | 有（`bench.py`） | 加"瞄准偏移 e"一列 |

### 5.2 同步线怎么用

- 方案 v2 写的是 GPIO14（UART0 TX）→ K230 某个 UART RX。更省事的做法：K230 → 树莓派用的是 uart3（`/dev/ttyAMA3`，RX 在 GPIO5），
  **同一个 uart3 的 TX 在 GPIO4**，接到 K230 一个空闲 UART 的 RX 就行，树莓派这边不用再开串口、也不用关 GPIO14 上的串口控制台/蓝牙。（接线前请对照 K230 板子引脚确认；GND 已经共地。）
- 树莓派每发一条执行器命令，就在这根线上发一行 ASCII 标记 `S <序号> <命令摘要>\n`；K230 收到后把 (帧号, 本地毫秒, 序号) 写进 SD 卡日志。
- 原来 K230 → 树莓派的 10 字节帧**完全不变**，只是多了一个反方向的、只用于研究的标记。离线时按序号把 `actions.csv` 和 K230 帧对齐，误差 ≤ 1 帧（约 140ms）。
- 同步线还能直接测出第 3 节里的 K230 EMA 滞后：命令时刻之后 K230 输出的阶跃响应。

### 5.3 真值

- **电位器**：LDX-218 内部电位器滑动端引一根线到 ADC。为了不改升降轴文本协议（规矩 2），建议用一块 ADS1115（I²C 接树莓派 GPIO2/3）读，而不是加升降轴 STM32 的新指令。
  要拆舵机、有损坏风险，先只改底座一个。
- **免拆替代**：激光笔贴在底座上照 2m 外的墙，手机拍光点（1° ≈ 35mm），足够测回差回线和死区。

### 5.4 实验步骤（都可以用 `bench.py` 的 9 个位置）

| 编号 | 内容 | 判据 |
|---|---|---|
| E1 辨识 | 物块固定在 ⑤，研究脚本做 80 步随机激励（底座 0.3~6°，含小步和换向），离线跑 `HysteresisBank` | (b̂, δ̂) 和激光笔 / 电位器测的回线对比，误差 < 0.3° |
| E2 关联 | `OBSERVE_CLAW = "open"`（让爪子脚可见），9 位置 × 5 次正常运行，K230 存所有框和图像；离线人工标注每条轨迹 T/S/D | 离线跑 P(T/S/D)：自身误锁率、误报率，对比日志里 ghost 规则的判定 |
| E3 补偿 | 先离线验证 E1 的参数能预测 E2 里的每一步位移；再加一个 config 开关（默认关）做 A/B：9 位置 × 10 次 | 对准步数、最终误差、真实成功率（McNemar） |
| E4 结果标定 | 位置 ⑤，固定 ±4mm 探测 20~40 次（e 换算成底座角：deg = mm / 深度 × 57.3），同时扫 −12…+12mm 拟合 w/2、σ | r̂ 和尺子量的爪子偏移对比；标定后 20 次成功率 vs 现在手调 trim |

每种条件 ≥ 30 次时用 Wilson 区间和 McNemar（和方案第 4 节一致）。

---

## 6 和《论文研究方案》第 4 节假设的对应

| 假设 | 本任务对应的结果（仿真） | 作为论文里的什么 |
|---|---|---|
| **H1** 无本体感知也能学出身体状态 | 4.2：只靠命令历史 + 画面位移，舵机输出角估计误差 0.03°（开环 0.8°） | "v1 迟滞辨识"基线的实现；世界模型的 h_t 要至少达到这个水平。真值用 5.3 |
| **H2** 自身/世界自动分离 | 4.1：爪子脚可见回合成功率 13% → 97%（多框）；自身误锁率 ≈ 0 | 轻量、可解释的基线；"原 YOLO 跟踪""ghost 规则"两个基线已复现。"手工忽略区域"没做（需要真机画面）。和 DIJE 类雅可比自识别的区别要查原文后再写 |
| **H3** 模型规划优于脚本专家 | 4.3：对准步数 1.65 → 1.0、收紧容差时 4.4 → 1.04；1b：回差放大 2 倍时脚本系统误报上升、模型不受影响 | "人为加大回差"实验的仿真预演；说明结构先验（迟滞）在回差大时的价值 |
| **H4** 数据效率 | 4.2：10~20 步激励即可；4.4：20~40 次抓取 | 给世界模型的数据量做参照（轻量模型几十步就够，深度模型要证明在复杂场景里值得多用数据） |
| 消融 | 去掉迟滞模型：96.4%（正常）/ 82.7%（2 倍回差） | 方案里"去掉迟滞记忆 / 物理先验"的消融，轻量版本 |

---

## 7 发现的问题和建议

**仿真里发现的问题**

1. **K230 跟踪器 EMA 滞后**：动作结束、等 `SETTLE_S` = 0.25s 后取 3~5 帧中值，测到的位移常常只有真实的 55~100%（`sim._Tracker` 同款逻辑）。
   这会：让 task.py 的 J 学偏、让 ghost 规则和概率模型误判（我一开始没建模它，K230 流上概率模型的误报中止是 1.9%、ghost 规则 0.6%；加上 λ 混合和第 2.4 节的门限修正后降到 0.5%）。
   建议真机用同步线实测阶跃响应；如果确实明显，研究版 K230 程序额外记录不经 EMA 的原始框。
2. **task.py 自适应 J 有 13~17% 系统偏差**（回差吃掉的动作被学成"灵敏度小"）。小改法：只用同方向、且 |u| 明显大于回差的步来学 J。
3. **只靠动作分不开两个静止方块**（规律相同），要靠外观或任务规则（例如选离 GOAL 最近的）。仿真里锁到"另一个方块"约 17%，算成功。
4. **升降轴死区几乎辨识不出来**（低于 K230 噪声）。好消息是它也不影响对准；升降轴最适合当"探测动作"。
5. **信息增益策略对 w、σ 设错敏感**。真机先用固定 ±4mm；或者把 (r, w/2, σ) 一起放进网格后验（3 维网格，计算量仍然很小）。

**可以先做的小改动（都不在本任务范围内，没有改；按规矩 5 默认关闭）**
——其中"消回差 / 左右试探 / 从结果学落点偏差"和并行的任务 09、"爪子脚"和任务 10 重叠，以那两个任务的实现为准，这里的仿真数字可以作为它们的参考。

| 建议 | 改哪里 | 依据 |
|---|---|---|
| ghost 规则加"预计不会动就不记 strike"：换向且 \|u\| < 估计的 b + δ 时跳过检查 | `task.py`（开关默认关） | 1b：回差大时误报 6% |
| 底座单向逼近（反向时先多退一点再走回来） | `task.py` / `servo.py`（开关） | 4.3：不辨识也能去掉大部分回差 |
| `calib.py trim` 改成"±4mm 交替探测 + 后验"流程 | `bench.py`（新子命令） | 4.4 |
| K230 研究版程序：存所有框 + 图像 + 接收同步标记 | `k230_sdcard/`（另存一份，不替换现在的） | 4.1：多框是最大收益的前提 |

**这次实现里自己踩过、需要说明的地方**

- 模型里有 4 处是看了 seed 0 的结果之后加的：λ 滞后混合、ρ 稳健化、已确认轨迹不走 D 门限、底座辨识网格从 4°/2.5° 放宽到 6°/4°（否则 2 倍回差时真实参数在网格外）。
  加完之后用 **seed 1** 独立重跑，结论一致（括号里的数字），但这仍然是同一个仿真器，不能代替真机。
- `p_raw` 假设 K230 能把所有框发出来；现有 10 字节协议做不到，CLAUDE.md 规定不改协议，所以这个结果只能先用于"离线分析 SD 卡数据"，或者在讨论后决定是否增加一个研究专用通道。

---

## 附录：`python3 research/run_experiments.py --seed 0` 完整输出

#### 1 数据关联：ghost 规则 vs 概率模型（仿真）

10 台随机车 × 200 回合；三种方法在**同样的场景**上配对比较（场景、帧噪声按回合播种）。每回合：原地看一眼（K230 选目标）→ 对准（升降 + 底座，同一个 task.py 控制律）。场景：真目标 + 爪子脚（每台车 10~50% 回合处于可见状态）+ 0~2 个干扰物（静止方块或乱动的手）。

| 方法 | 对准到方块并确认 [95%CI] | 误锁（自身/手） | 正确中止 | 误报中止（其实是方块） | 丢失/超步 | 其中是另一方块 | 首次正确锁定步数 | 平均步数 |
|---|---|---|---|---|---|---|---|---|
| 现有 ghost 规则（K230 单目标） | 66.0% [64, 68] | 0.3% | 30.4% | 0.6% | 2.6% | 13.3% | 0.09 | 2.18 |
| 概率模型（K230 单目标，只能停） | 65.3% [63, 67] | 0.2% | 32.0% | 0.5% | 2.0% | 13.0% | 0.05 | 2.04 |
| 概率模型（多框 + 换目标 + 主动探测） | 99.0% [98, 99] | 0.0% | 0.9% | 0.0% | 0.1% | 17.5% | 0.51 | 3.04 |
| 消融：同上但去掉迟滞模型（b=δ=0，只学 J） | 96.4% [95, 97] | 0.0% | 1.5% | 2.0% | 0.1% | 17.1% | 0.55 | 3.29 |

| 方法 | 成功率：爪子脚可见的回合 | 成功率：爪子脚不可见的回合 |
|---|---|---|
| 现有 ghost 规则（K230 单目标） | 12.7% [10, 16] | 86.3% [84, 88] |
| 概率模型（K230 单目标，只能停） | 12.3% [10, 15] | 85.5% [84, 87] |
| 概率模型（多框 + 换目标 + 主动探测） | 97.3% [96, 98] | 99.7% [99, 100] |
| 消融：同上但去掉迟滞模型（b=δ=0，只学 J） | 94.9% [93, 96] | 97.0% [96, 98] |

说明：误锁 = 最后确认 / 一直跟着的是爪子脚或手；正确中止 = 停下时锁的确实不是方块（task.py 里整回合放弃）；首次正确锁定步数 = 成功回合里从第几步起一直锁在方块上。（用时 18s）

##### 1b 底座回差、死区放大 2 倍（H3 的"人为加大回差"）

10 台随机车 × 100 回合；三种方法在**同样的场景**上配对比较（场景、帧噪声按回合播种）。每回合：原地看一眼（K230 选目标）→ 对准（升降 + 底座，同一个 task.py 控制律）。场景：真目标 + 爪子脚（每台车 10~50% 回合处于可见状态）+ 0~2 个干扰物（静止方块或乱动的手）。

| 方法 | 对准到方块并确认 [95%CI] | 误锁（自身/手） | 正确中止 | 误报中止（其实是方块） | 丢失/超步 | 其中是另一方块 | 首次正确锁定步数 | 平均步数 |
|---|---|---|---|---|---|---|---|---|
| 现有 ghost 规则（K230 单目标） | 61.5% [58, 64] | 0.3% | 29.3% | 6.0% | 2.9% | 11.6% | 0.09 | 2.59 |
| 概率模型（K230 单目标，只能停） | 65.2% [62, 68] | 0.2% | 30.9% | 0.8% | 2.9% | 11.7% | 0.08 | 2.76 |
| 概率模型（多框 + 换目标 + 主动探测） | 98.4% [97, 99] | 0.0% | 0.5% | 0.9% | 0.2% | 17.4% | 0.51 | 3.99 |
| 消融：同上但去掉迟滞模型（b=δ=0，只学 J） | 82.7% [80, 85] | 0.0% | 4.2% | 12.6% | 0.5% | 13.9% | 0.72 | 4.57 |

| 方法 | 成功率：爪子脚可见的回合 | 成功率：爪子脚不可见的回合 |
|---|---|---|
| 现有 ghost 规则（K230 单目标） | 12.4% [9, 17] | 79.3% [76, 82] |
| 概率模型（K230 单目标，只能停） | 13.9% [10, 19] | 83.8% [81, 86] |
| 概率模型（多框 + 换目标 + 主动探测） | 97.7% [95, 99] | 98.6% [98, 99] |
| 消融：同上但去掉迟滞模型（b=δ=0，只学 J） | 80.1% [75, 84] | 83.7% [81, 86] |

说明：误锁 = 最后确认 / 一直跟着的是爪子脚或手；正确中止 = 停下时锁的确实不是方块（task.py 里整回合放弃）；首次正确锁定步数 = 成功回合里从第几步起一直锁在方块上。（用时 10s）

#### 2 迟滞辨识：(J, b, δ) 估计误差随步数收敛（仿真）

10 台车 × 每台 3 段随机激励（每步随机方向、底座 0.3~6°、升降 0.03~1cm），只用真目标的检测（假设关联已解决），每步取 3 帧中值。网格：底座 b 0~6° × δ 0~4°（61×41），升降 b 0~0.5cm × δ 0~0.25cm（26×26）。真实参数范围（估计）：底座 b 0.5~3.0°、δ 0.5~2.0°；升降 b 0.05~0.30cm、δ 0.02~0.15cm。

##### 底座（°）

| 步数 | b 误差（°） | b 后验 sd | δ 误差（°） | J 相对误差：假设库 | J 相对误差：task.py 自适应 | 输出位置估计误差（°） | 开环：认为输出=命令（°） |
|---|---|---|---|---|---|---|---|
| 5 | 0.416 | 0.634 | 0.360 | 4.4% | 13.9% | 0.220 | 0.818 |
| 10 | 0.120 | 0.289 | 0.285 | 2.0% | 15.8% | 0.060 | 0.695 |
| 20 | 0.104 | 0.186 | 0.203 | 1.9% | 14.2% | 0.051 | 0.928 |
| 40 | 0.059 | 0.126 | 0.147 | 0.9% | 17.2% | 0.033 | 0.966 |
| 80 | 0.051 | 0.090 | 0.078 | 0.8% | 15.7% | 0.026 | 0.819 |

##### 升降轴（cm）

| 步数 | b 误差（cm） | b 后验 sd | δ 误差（cm） | J 相对误差：假设库 | J 相对误差：task.py 自适应 | 输出位置估计误差（cm） | 开环：认为输出=命令（cm） |
|---|---|---|---|---|---|---|---|
| 5 | 0.066 | 0.133 | 0.039 | 6.7% | 38.0% | 0.039 | 0.076 |
| 10 | 0.048 | 0.117 | 0.036 | 5.6% | 24.7% | 0.022 | 0.072 |
| 20 | 0.028 | 0.095 | 0.032 | 3.4% | 12.8% | 0.017 | 0.082 |
| 40 | 0.017 | 0.072 | 0.029 | 2.9% | 9.8% | 0.010 | 0.085 |
| 80 | 0.010 | 0.053 | 0.026 | 2.7% | 9.8% | 0.006 | 0.072 |

"输出位置估计误差"就是 H1 的雏形：不装编码器，只靠命令历史 + 画面位移，后验对舵机真实输出角的估计（对比开环把命令当成实际位置）。

#### 3 逆迟滞补偿：底座对准（仿真）

10 台车 × 100 回合，只看底座（方位角）对准；初始误差 ±2~20°，容差 1.5°（现在 config.TOL）和 0.5°（更严）。执行器状态跨回合延续（历史有影响）。最终误差 = 对准结束时物块真实方位角（不含测量噪声）。

| 容差 | 方法 | 平均对准步数 | 最终角度误差 均值 | 95 分位 | 进入容差的比例 |
|---|---|---|---|---|---|
| 1.5° | 基线：task.py 自适应 P 控制 | 1.65 | 0.55° | 1.38° | 99.7% |
| 1.5° | 逆迟滞补偿（在线辨识，从先验开始） | 1.01 | 0.18° | 0.42° | 99.5% |
| 1.5° | 逆迟滞补偿（先激励辨识 40 步） | 1.00 | 0.17° | 0.38° | 99.5% |
| 1.5° | 逆迟滞补偿（真实参数，上限） | 1.00 | 0.16° | 0.37° | 99.7% |
| 0.5° | 基线：task.py 自适应 P 控制 | 4.44 | 0.33° | 0.55° | 96.5% |
| 0.5° | 逆迟滞补偿（在线辨识，从先验开始） | 1.04 | 0.18° | 0.37° | 99.6% |
| 0.5° | 逆迟滞补偿（先激励辨识 40 步） | 1.02 | 0.18° | 0.37° | 99.4% |
| 0.5° | 逆迟滞补偿（真实参数，上限） | 1.01 | 0.17° | 0.36° | 99.5% |

#### 4 结果监督的残差标定（仿真）

10 台车（真实残差 r ~ U(−6, 6) mm）× 每台 20 次独立标定，每次 40 次抓取。成功概率 Φ((w/2 − |e − r|)/σ)，模型取 w/2 = 8mm、σ = 3mm（估计）；先验 r ~ N(0, 6²)。最后一列：标定结束后瞄准 r̂ 的真实成功率。

##### 模型正确（w/2=8, σ=3）

| 策略 | 5 次后 r 误差 mm | 10 次后 r 误差 mm | 20 次后 r 误差 mm | 30 次后 r 误差 mm | 40 次后 r 误差 mm | 标定期间成功率 | 标定后成功率 |
|---|---|---|---|---|---|---|---|
| 纯利用 e=r̂ | 3.11 | 3.11 | 3.11 | 3.11 | 3.11 | 93% | 93.1% |
| 固定探测 ±4mm | 1.88 | 1.17 | 0.94 | 0.79 | 0.69 | 88% | 99.2% |
| 固定探测 ±8mm | 1.47 | 0.96 | 0.70 | 0.56 | 0.48 | 53% | 99.4% |
| 信息增益最大 | 1.60 | 1.07 | 0.71 | 0.55 | 0.49 | 54% | 99.4% |
| 信息增益（预测成功率≥0.6） | 1.33 | 0.98 | 0.70 | 0.53 | 0.46 | 64% | 99.4% |

##### 模型设错：真实 w/2=6.5, σ=4.5

| 策略 | 5 次后 r 误差 mm | 10 次后 r 误差 mm | 20 次后 r 误差 mm | 30 次后 r 误差 mm | 40 次后 r 误差 mm | 标定期间成功率 | 标定后成功率 |
|---|---|---|---|---|---|---|---|
| 纯利用 e=r̂ | 3.11 | 3.11 | 3.11 | 3.11 | 3.11 | 76% | 76.4% |
| 固定探测 ±4mm | 2.34 | 1.54 | 1.15 | 0.95 | 0.86 | 69% | 89.2% |
| 固定探测 ±8mm | 1.81 | 1.41 | 0.97 | 0.78 | 0.70 | 39% | 90.0% |
| 信息增益最大 | 2.44 | 1.74 | 1.28 | 1.11 | 1.02 | 44% | 88.5% |
| 信息增益（预测成功率≥0.6） | 2.17 | 1.84 | 1.35 | 1.10 | 1.02 | 51% | 88.4% |

总用时 92s
