AULAGE/dache/docs/cloud_tasks/results/09_报告.md

# 任务 09 报告：底座消回差、失败左右试探、从结果学习落点偏差、三点插值

> **全部结论来自仿真，未在真机验证。** 仿真里的落点偏差、横向容差、回差大小都是按 11-03 真机现象估计的（见第 2 节），
> 真机上要用 `bench.py` 的测试矩阵重新确认。

分支：`cloud/09-grasp-accuracy`。所有新功能默认关闭；默认配置下 `main.py --sim` 的输出和改之前**逐字节一致**
（有底盘 / 无底盘各 2 个种子 × 40~60 次，`cmp` 比对过），`selftest.py` 129 项全部通过（原来 89 项，新增 40 项：`test_accuracy` 39 项 + 仿真回归 1 项）。

## 0. 一页结论

| | 仿真结果（无底盘，10 台车 × 100 次，横向容差 ±5mm） | 建议 |
|---|---|---|
| 现状（不微调） | 69.6%（真机 15 次抓到 11 次 = 73%，量级一致） | |
| 现状 + `trim 4`（真机现在的做法） | 86.1% | 保留 |
| **+ 试探 + 学习（保留 trim 4）** | **87.9%**；6 种仿真环境里和只用 trim 比 −2.0~+6.4 个百分点，两个负值都在统计误差内 | **明天第一个打开** |
| + 消回差（单独开） | **32.6%（明显变差）** | 不要单独开，见 3.1 |
| 全开（消回差 + 试探 + 学习） + trim 4 | 87.9% | 第 2 步再试，要配合学习 |
| reach_mid 三点插值 | 中间深度高度偏 10mm 时：54.5% → 79.6% | 只有测试矩阵显示"中间深度失败、两端成功"时再标 |

最重要的一条发现：**消回差会改变落点的系统偏差**。它让每次落点更一致，但"一致"的位置不一定是对的。
开了消回差之后，之前量的 `trim 4` 就不准了（④ 消回差 + 旧 trim：77.1%，比不开还差）。所以消回差必须和学习一起开，
或者开了之后重新用 bench 量一次 trim。

## 1. 改了什么

| 文件 | 改动 |
|---|---|
| `config.py` | 新参数（全部默认关，都加进了 `CALIB_KEYS`）：`BASE_BACKLASH_DEG` `BASE_APPROACH_DIR` `BASE_MIN_STEP_DEG` `GRASP_PROBE_MM` `GRASP_PROBE_FIRST` `TRIM_LEARN` `TRIM_LEARN_RATE` `TRIM_MAX_DEG` `TRIM_LEARN_EDGES` `TRIM_LEARN_FILE` `REACH_MID_D` `GOAL_MID`；仿真新因素 `SIM_GRASP_BIAS_MM` `SIM_GRASP_BIAS_VAR_MM` `SIM_GRIP_TOL_MM` `SIM_REACH_SHIFT` `SIM_REACH_SAG_MM`（也全部默认关） |
| `task.py` | 所有带底座的机械臂指令都改走 `_arm()`（消回差在这里做）；`_min_base_step()`；`reach_pose()` 三点插值；`goal_for()` 支持 `GOAL_MID`；`run_once()` 记失败次数 → 下一次的试探量 → 结束后学习；学到的值存 `logs/learned_trim.json` |
| `calib.py` | `teach mid` 标中间姿态，`teach mid off` 删掉；`trim` 会同时显示学到的分段微调；`trim forget` 清掉学到的 |
| `sim.py` | 新的落点偏差 / 横向容差 / 伸出时回差 / 中间高度偏差模型（默认关，原来的随机序列不变） |
| `sim_accuracy.py`（新） | 本报告所有表格的来源：`python3 sim_accuracy.py`、`--probe-sweep`、`--mid`、`--set 参数=值` |
| `selftest.py` | 新增 `test_accuracy`（39 项）+ 仿真回归里加一项"无底盘、任务 09 全开" |

`bench.py` 没改：它记录的 `trim_deg` 仍然是固定微调 `GRASP_BASE_TRIM_DEG`；学到的值和试探量在
`task.last_grasp` 里多了 `learned_trim_deg` / `probe_mm` / `trim_total_deg` 三项（只在打开功能时才有），
打开功能后 `episodes.csv` 也会多 `probe_used` / `grasp_d` / `trim_learned` 三列（列变了程序会把旧文件改名留档）。

## 2. 仿真环境（新加的真实因素，都是估计值）

`sim_accuracy.py` 在默认仿真上打开这些（`ENV`）：

| 因素 | 取值 | 依据 |
|---|---|---|
| 落点横向偏差 `SIM_GRASP_BIAS_MM` | 每台车 3~5mm 偏右，固定 | 真机：对准误差在容差内、落点系统性偏右约 4mm |
| 偏差随深度变 `SIM_GRASP_BIAS_VAR_MM` | 近→远线性变化 ±1.5mm（每台车随机方向） | 爪子脚遮挡物块左侧的程度随位置变（推测） |
| 横向抓取容差 `SIM_GRIP_TOL_MM` | **±5mm**（另做了 ±4、±6） | 物块 24mm，爪子张开**估计**约 34mm → (34−24)/2。±5mm 时"现状"仿真 69.6% 和真机 73% 最接近 |
| 底座回差 `SIM_SERVO_BACKLASH_US` | 20us ≈ 1.8°（另做了 10us） | 真机：命令 +4.8°，方位角误差只从 5.0° 变到 3.4°（按灵敏度 −0.6 算少走了约 2°） |
| 伸出时推底座 `SIM_REACH_SHIFT` | 开：机械臂伸出时输出轴被推到回差间隙的一侧（每台车固定哪一侧） | 推测：重心外移的力矩。**这是回差能造成落点偏差的唯一途径**——对准和抓取都用同一个底座角度，单纯的回差只影响对准步数。另做了"关"的对比 |
| 相机半径 `R_CAM_MM` | 0 | 真机标定 R=0；`calib.py trim` 的换算也按这个 |
| 中间高度偏差 `SIM_REACH_SAG_MM` | 只在 `--mid` 里开（0 / 6 / 10mm） | 关节空间插值不是直线，偏多少不知道 |

参考上限（没有落点偏差、伸出不推底座，其余一样）：94.7%。剩下 5% 主要是原仿真本来就有的 10% 随机失败、找不到、丢目标。

## 3. 每一项的原理

### 3.1 底座消回差 `BASE_BACKLASH_DEG`、`BASE_APPROACH_DIR`

- 做法：程序记住最后一次发给底座的脉宽和转动方向。新的底座目标如果要**反着** `BASE_APPROACH_DIR` 转（或者状态未知），
  先多转 `BASE_BACKLASH_DEG` 度，再顺着逼近方向转回来。这样最后一段总是从同一边过来，齿轮总是靠在同一侧。
- 哪些动作做：对准时转底座、回观察姿态、伸出（ready / reach / carry）、观察确认。放置（drop，转到 2287）不做。
- 只动底座时，回程只走 `BASE_BACKLASH_DEG` 那么远，用时按这个算（最少 150ms）；带其它关节的姿态（ready）两段都用原来的时间。
- 代价：仿真里每次抓取多 2~4 秒（每多转一次约 0.3 秒，对准、回观察、伸出都可能要多转）。
- **为什么单独开会变差**：它不减少偏差，只让偏差**固定下来**。仿真里合爪时"物块相对对准目标"的横向偏差：
  关闭时四分位 −3.7~+0.1mm（散），打开后 −4.4~−0.9mm（集中，但中心还偏）。散的时候偶尔碰巧能补上 4mm 的落点偏差，
  集中之后就稳定地抓不到。再加上"伸出时推底座"：逼近方向和被推的方向相同时，每次都多偏一个回差（1.8° ≈ 5.7mm）。
  → **消回差的价值是让偏差变成能补的固定值**：不开回差时学习只能把误差从 1.51° 学到 1.08°（不推底座的环境），开了能学到 0.53°。
- `BASE_APPROACH_DIR` 选哪边：仿真里两边各有一半车更好，看伸出时底座被推向哪边。真机上开了之后先试 1，不好再试 −1（每次换了都要 `trim forget`）。

### 3.2 底座最小有效步长 `BASE_MIN_STEP_DEG`

- 方位角误差超过容差、但算出的步子比这个小时，按这个值走。最多放大到"预测误差 = 反方向 0.9 倍容差"，不会冲到另一边来回摆。
- 仿真里没效果（1° 从不触发：R=0、灵敏度 −1 时，误差 >1.5° 算出来的步子都 ≥1.27°；把死区加到 15us、步长 2~3° 也没改善）。
- 真机灵敏度约 −0.6，误差 1.6° 时步子是 2.3°，所以要设 **2.5°** 左右才可能起作用。这一项仿真验证不了，排最后。

### 3.3 失败后左右试探 `GRASP_PROBE_MM`

- 第 1 次伸出不试探；没抓到，重新对准后第 2 次落点偏 −p（左），第 3 次偏 +p（右），再往后 −2p、+2p……
- 毫米换成底座角度：`atan(p / (深度 + R_CAM_MM))`。真机 R=0，按深度算。
  ⚠ 如果真机相机其实在转轴后面（灵敏度 −0.6 暗示可能是这样），爪子到转轴的距离比深度短，实际挪的毫米数会比 p 大一些。
- `GRASP_PROBE_FIRST = "alternate"`：每个物块换一边先试（学习时必须这样，见 3.5）。
- 仿真：单开试探 69.6% → 80.0%，p 扫了 2/3/4/6mm，**3mm 最好**（p 太大容易试过头、推开物块）。

### 3.4 从结果学习落点偏差 `TRIM_LEARN`

- 按物块深度分 3 段（默认把 `[REACH_NEAR_D, REACH_FAR_D]` 三等分；真机 156/216 → 边界 176、196mm），每段一个微调值，
  加在固定微调 `GRASP_BASE_TRIM_DEG` 上。
- 规则（一个物块结束时）：
  - 第 1 次就抓到 → 不改（现在的微调够用）
  - 试探 ±p 抓到了 → 这一段往那边挪 `TRIM_LEARN_RATE × p`（换成角度）
  - 都没抓到 → 不改，只计数
  - 限制在 ±`TRIM_MAX_DEG`（默认 3°）
- 存 `logs/learned_trim.json`（每段的值和"直接抓到 / 左试探抓到 / 右试探抓到 / 都没抓到"次数），`calib.py trim` 能看，
  `calib.py trim forget` 清掉。深度分段变了（重新标了近/远）会自动作废重学。`--no-learn` 时只用不改。
- 这就是"用奖励学参数"：奖励 = 抓到没有，学的是落点偏差；本质是一种有限差分的随机逼近（两边各试一下，哪边好往哪边走），不需要神经网络。

### 3.5 会不会学偏？怎么防

| 风险 | 后果 | 防护 |
|---|---|---|
| 第 1 次没抓到是随机原因（打滑、物块被碰歪），不是偏差 | 试探往哪边都可能成功，会往试探方向挪一步 | `alternate`：先试的方向每个物块轮换，随机失败带来的挪动期望为 0；如果固定先试左，随机失败会让微调一直往左漂 |
| 稳态抖动 | 步长固定（0.5 × 3mm ≈ 0.5°），不会收敛到一个点，会在真值附近 ±0.5° 晃 | 仿真里 40~60 次后误差约 0.5°，跑到 200 次也没漂走（见 4.3）；±`TRIM_MAX_DEG` 兜底 |
| **观察确认误报**（物块被推开 10~30mm 当成抓到） | 推开往往是试探方向偏了造成的 → 会把错的方向学进去 | 现有的弱点（仿真 1000 次里 2~8 次误报）。看 `bench.py report` 的误报数；`calib.py trim` 里某一段只往一个方向涨、成功率却不涨时就 `trim forget` |
| 偏差和深度、左右位置都有关 | 只按深度分段，左右位置的差别学不到，会学成平均值 | 测试矩阵里如果"只有左边/右边偏"，说明是左右相关，学习补不了，先看任务 10（爪子脚遮挡） |
| 改了机械（消回差开关、逼近方向、重新装爪子、重标姿态） | 旧的学习结果不再适用 | 换了就 `calib.py trim forget`；重标近/远会自动作废 |
| 数据少的段 | 学得慢（只有失败 + 试探成功才学） | 测试矩阵每段都有位置；学到的值和次数用 `calib.py trim` 看 |

### 3.6 三点插值 `reach_mid` / `REACH_MID_D` / `GOAL_MID`

- `calib.py teach mid`：和 teach near/far 一样的倒推法（物块放进爪子 → 合爪确认 → 松爪退回观察姿态读数）。
  没标过时用 reach_near 和 reach_far 的中点当初值，按 `j` 点动调整。保存 `POSES.reach_mid`、`REACH_MID_D`、`GOAL_MID`。
  `calib.py teach mid off` 删掉，恢复两点插值。
- 伸出姿态和无底盘时的对准目标（Y、方位角）都按 近-中、中-远 分段插值。`REACH_MID_D` 不在近、远之间时不用它。
- 仿真（两点插值时中间深度爪子高度偏 sag，抛物线模型）：

| 中间深度高度偏差 | 两点插值 | 标了 reach_mid |
|---|---|---|
| 0mm | 87.0% | — |
| 6mm | 77.4% | 79.8% |
| 10mm | 54.5% | 79.6% |

  （都是"全开"。标了 reach_mid 还剩的损失来自分段之间的残余偏差。）真机中间深度到底偏多少不知道，所以**先看测试矩阵**：
  ④⑤⑥ 失败、①②③⑦⑧⑨ 成功才标。

## 4. 仿真对比

### 4.1 主表（无底盘，10 台车 × 100 次，横向容差 ±5mm，回差 20us，伸出推底座）

`python3 sim_accuracy.py`。"后一半" = 每台车第 51~100 次（学习的效果主要看这个）。
"微调误差" = 3 段平均的 |学到的微调 − 这台车真正需要的微调|，初始值是不学时的误差。

| 配置 | 真实抓到率 | 后一半 | 平均重试 | 对准步数 | 用时 s | 误报成功 | 微调误差 初始 → 学完 |
|---|---|---|---|---|---|---|---|
| 原仿真（不加任务 09 的真实因素） | 95.7% | 95.4% | 0.39 | 3.34 | 45.9 | 2 | |
| 参考上限：没有落点偏差、伸出不推底座 | 94.7% | 94.2% | 0.42 | 3.48 | 43.8 | 1 | |
| ① 现状（真实因素全开，改进全关） | 69.6% | 70.8% | 0.93 | 4.29 | 49.9 | 5 | |
| ② 现状 + 固定微调 trim 4（−1.27°） | 86.1% | 85.4% | 0.62 | 3.95 | 46.3 | 3 | |
| ③ + 消回差（2°，最小步长 1°） | 32.6% | 35.4% | 1.44 | 4.92 | 58.1 | 10 | |
| ④ + 消回差 + trim 4 | 77.1% | 77.2% | 0.76 | 3.89 | 50.2 | 5 | |
| ⑤ + 失败左右试探（p=3mm） | 80.0% | 78.0% | 0.89 | 4.24 | 49.4 | 5 | |
| ⑥ + 试探 + 学习 | 86.8% | 87.0% | 0.67 | 4.00 | 46.8 | 2 | 1.16° → 0.44° |
| **⑦ + 试探 + 学习 + trim 4** | **87.9%** | 87.2% | 0.62 | 3.94 | 46.2 | 2 | 0.75° → 0.60° |
| ⑧ 全开（消回差 + 试探 + 学习） | 87.0% | 87.6% | 0.71 | 3.86 | 49.6 | 6 | 2.05° → 0.62° |
| ⑨ 全开 + trim 4 | 87.9% | 87.2% | 0.67 | 3.79 | 49.2 | 8 | 0.84° → 0.46° |

1000 次的抓到率，统计误差约 ±1.1%（1 个标准差），差 2 个百分点以内的不要当真。

### 4.2 敏感性：仿真环境估计错了，结论还成立吗？

真实抓到率（每格 10 台车 × 100 次）：

| 配置 | 容差 ±4 | **容差 ±5** | 容差 ±6 | 伸出不推底座 | 回差 10us | 每台车偏差 1~7mm、随深度 ±3mm |
|---|---|---|---|---|---|---|
| ① 现状 | 53.3% | 69.6% | 79.1% | 56.3% | 61.7% | 61.3% |
| ② trim 4 | 76.7% | 86.1% | 91.7% | 87.4% | 92.4% | 83.5% |
| ④ 消回差 + trim 4 | 67.2% | 77.1% | 82.3% | **91.8%** | 87.1% | 69.0% |
| ⑥ 试探 + 学习 | 82.0% | 86.8% | 88.7% | 77.4% | 88.6% | 86.6% |
| **⑦ 试探 + 学习 + trim 4** | 83.1% | 87.9% | 90.1% | 88.4% | 90.4% | 87.2% |
| ⑧ 全开 | 79.9% | 87.0% | 88.0% | 89.1% | 87.0% | 81.3% |
| ⑨ 全开 + trim 4 | 84.6% | 87.9% | 91.7% | 88.8% | 90.9% | 88.8% |

读法：
- **⑦ 和 ② 比：−2.0~+6.4 个百分点**（容差 ±6 那列 −1.6、回差 10us 那列 −2.0，两个比例相减的统计误差约 ±1.5，不显著；其余 4 列都是正的）。trim 量得准的时候学习帮得不多，
  量得不准（最后一列：偏差每台车 1~7mm）时学习明显有用（83.5% → 87.2%）。所以它是"开了不亏"的。
- ④（消回差 + 旧 trim）好不好**完全取决于"伸出时推不推底座"**：不推时它最好（91.8%），推时它比不开还差。
  这个机械行为仿真定不了，只能真机测 → 所以消回差排在第 2 步，并且要配合学习（⑧⑨ 在两种情况下都稳）。
- ⑥（不带 trim 从零学）在"不推底座"的环境里只有 77.4%：没有消回差时回差是随机的，学习信号很吵。
- 最后一列的"原仿真"和"参考上限"两行因为 `--set` 覆盖了偏差，不可比，表里没列。

### 4.3 学习收敛（⑥、⑧，10 台车）

| 抓了多少次之后 | 20 | 40 | 60 | 100 | 200 |
|---|---|---|---|---|---|
| ⑥ 微调误差 / 最近 20 次抓到率 | 0.72° / 86% | 0.58° / 88% | 0.49° / 86% | 0.44° / 86% | 0.55° / 90% |
| ⑧ 微调误差 / 最近 20 次抓到率 | 0.86° / 81% | 0.63° / 90% | 0.49° / 90% | 0.62° / 86% | 0.40° / 92% |

40~60 次后学到约 0.5°（180mm 处约 1.5mm），之后在这附近晃，200 次没有漂走。真机按一轮 18 次算，2~3 轮能学出来。

### 4.4 试探量和学习率（全开，10 台车 × 100 次）

| p \ 学习率 | 0.3 | 0.5 | 1.0 |
|---|---|---|---|
| 2mm | 78.6% | 83.7% | 85.7% |
| **3mm** | 85.7% | **87.0%** | 84.8% |
| 4mm | 85.7% | 85.4% | 82.8% |
| 6mm | 82.3% | 80.7% | 80.2% |

p = 3mm、学习率 0.5（每次挪 1.5mm）最好；p 太大容易推开物块，学习率 1.0 抖得厉害。

### 4.5 有底盘（任务 09 主要针对无底盘，这里只确认没有弄坏）

默认仿真环境（不加任务 09 因素），`sim_compare.run`，6 台车 × 100 次：

| | 有底盘 | 无底盘 |
|---|---|---|
| 全关（默认） | 88.5% | 94.3% |
| 全开（消回差 2° + 最小步长 1° + 试探 3mm + 学习） | 86.8% | 93.0% |

差别在统计误差内（±1.3%）。默认环境里没有落点偏差，所以全开不会带来好处，只多花约 1~3 秒。

## 5. 明天真机：打开顺序和参数初值

改参数：编辑树莓派上 `~/grasp/calib.json`，加对应的键（都在白名单里），保存后重新运行即可。
每一步都用 `bench.py` 跑一轮测试矩阵（18 次），**用 bench 的"真的抓到没有"判断好坏，不看程序自己说的**。

**第 0 步：基准**（不改代码行为）
```bash
cd ~/grasp
python3 selftest.py quick
python3 calib.py trim            # 确认现在是 −1.3° 左右，学到的分段微调"没有"
python3 bench.py                 # 一轮 18 次，记下真实成功率
```

**第 1 步：试探 + 学习（保留 trim 4）** ← 仿真里 6 种环境 4 种更好、2 种持平
```json
"GRASP_PROBE_MM": 3.0,
"GRASP_PROBE_FIRST": "alternate",
"TRIM_LEARN": true,
"TRIM_LEARN_RATE": 0.5,
"TRIM_MAX_DEG": 3.0
```
- 跑 2~3 轮（36~54 次）。每轮后 `python3 calib.py trim` 看三段学到了什么、`python3 bench.py report` 看真实成功率和误报
- 正常：三段的值在 ±1.5° 以内，左右试探成功次数有来有回
- 不正常：某一段一直往一个方向涨到 ±3° → 多半是误报（被推开当成抓到）或者偏差和左右位置有关 → `calib.py trim forget`，把日志发给我
- 日志里会看到：`抓取：…（微调 −1.8° = 固定 −1.3° + 学到 −0.50° + 试探 +0mm）`、`学习落点：深度 …mm 那一段，试探 −3mm 抓到了 → …`

**第 2 步：消回差**（只在第 1 步稳定之后）
```json
"BASE_BACKLASH_DEG": 3.0,
"BASE_APPROACH_DIR": 1
```
- 初值 3°：真机看起来回差约 2°，要比回差大
- 打开前先 `python3 calib.py trim forget`（偏差会变，旧的学习结果作废），trim 4 先保留
- 跑 2~3 轮和第 1 步比。差了就把 `BASE_APPROACH_DIR` 改成 −1、再 `trim forget`、再跑；两个方向都不如第 1 步就关掉（`BASE_BACKLASH_DEG: 0`）
- 顺便看对准步数有没有变少（`report.py`），这是消回差本来想解决的"小角度转不到位"

**第 3 步：中间姿态**（只在测试矩阵显示"④⑤⑥ 失败、两端成功"时）
```bash
python3 calib.py teach mid       # 物块放在约 186mm 深度
```
不好就 `python3 calib.py teach mid off`。

**第 4 步（可选）：最小步长**——对准时 x 还要在 1.5~3° 之间来回多走好几步时
```json
"BASE_MIN_STEP_DEG": 2.5
```

## 6. 没做 / 局限

- 仿真里的偏差、容差、回差、"伸出时推底座"全是估计；尤其"伸出时推底座"决定了消回差的好坏，必须真机测。
- 学习只按深度分段，左右位置相关的偏差（爪子脚遮挡）学不到，要靠任务 10 从根上解决。
- 观察确认的误报（物块被推开当成抓到）会污染学习；这个问题本身不在本任务范围。
- 试探量按"转轴到物块 = 深度 + R_CAM_MM"换算角度；真机 R 标成 0，如果相机其实在转轴后面，实际挪的毫米数会偏大。
- 消回差每次抓取在仿真里多 2~4 秒。

**以上全部只在仿真和离线自测里验证过，未在真机验证。**
