AULAGE/dache/docs/cloud_tasks/results/02_报告.md

# 任务 02 报告：让仿真更真实

分支：`cloud/02-sim-fidelity`　日期：2026-11-02
**所有结论都只来自仿真和离线自测，没有在真机上验证。** 标"估计"的参数没有实测依据，需要真机确认。

## 一句话结论

- 7 个真实因素都加进了 `sim.py`，每个都有 `config.py` 的 `SIM_*` 开关，**默认开启**；全部关掉时和原版仿真**逐位一致**（同 seed 的成功率、步数、用时、评分完全相同）。
- 全部打开后，有底盘成功率 **93.3% → 87.5%**，无底盘 **95.7% → 96.7%**；平均用时有底盘 41→57s、无底盘 37→45s。
- 影响最大的是 **7 误识别**（有底盘 −5 个百分点）；**6 USB 掉线**会让程序**直接崩溃**（原代码的漏洞）；**2 底盘平滑**暴露了"底座转到极限 → 抓空 → 误报抓到"的控制逻辑漏洞。
- 针对这三个问题做了三个**默认关闭**的改进开关（A/B/C），全打开后有底盘回到 **93.3%**、无底盘 **97.1%**，"报成功但没抓到"从 11 次降到 0 次（/1000）。
- 另外发现 `config.FOV_X_DEG / FOV_Y_DEG` 很可能和 K230 旋转后的画面**反了**（见第 6 节），如果属实，仿真成功率会掉到 55~65%。**需要真机确认**。
- `python3 selftest.py`：**52 项全部通过**（原 36 项 + 新增 16 项），85% 阈值没有动。

## 1. 改了哪些文件

| 文件 | 改动 |
|---|---|
| `raspberrypi/grasp/sim.py` | 重写：逐帧 K230 + 跟踪器、`SimWheeltec`（继承真机 `WheeltecChassis`）、舵机死区/回差、推开物块、尺寸法测深、`SimArmSerial`（假 CH340，可掉线，走真机 `Arm`）、假目标。原版逻辑保留在开关关闭的分支里 |
| `raspberrypi/grasp/config.py` | 新增 `SIM_*` 仿真开关和强度；新增改进开关 `ARM_USB_ROBUST`、`SEARCH_CONFIRM`（及 `CONFIRM_*`）、`BASE_LIMIT_BACKUP_MM`，并加进 `CALIB_KEYS` 白名单（`SIM_*` 只影响仿真、不是每台车的标定，没有加进白名单） |
| `raspberrypi/grasp/devices.py` | ① `WheeltecChassis.drive` 里的 `time.monotonic/sleep` 换成 `self._now/_sleep`（真机实现不变），仿真才能跑同一套逻辑；② `Arm` 可注入串口工厂，`_open` 改用 `self.clock`（真机是 `RealClock`，行为不变）；③ 新增 `robust` 模式（改进 A，默认关） |
| `raspberrypi/grasp/task.py` | 改进 B `confirm_target`（搜索复核）、改进 C（底座到极限时后退转车头），都默认关闭 |
| `raspberrypi/grasp/main.py` | `run_sim`：每台车固定 `make_car` 参数、跨次保留学到的滑行 τ、某次出异常记为失败继续跑（原来会让整个仿真退出）；真机 `open_devices` 把 `ARM_USB_ROBUST` 传给 `Arm` |
| `raspberrypi/grasp/selftest.py` | 新增 16 项：每个新因素的单元测试、`Arm` 连续掉线两次、搜索复核、"全开 + 改进"的仿真回归 |
| `raspberrypi/grasp/sim_compare.py` | 新增：逐项对比脚本，生成本报告的表格 |
| `raspberrypi/README.md` | 仿真一节补一句说明 |

行尾/编码：Python 文件保持原来的 CRLF（`main.py` 原来是 LF，保持 LF）；没有改任何 STM32 文件和通信协议。

## 2. 每个因素的模型和真实依据

| # | 因素 | 仿真里怎么做 | 参数 | 依据 |
|---|---|---|---|---|
| 1 | K230 跟踪器预测 / 滞后 | 每 1/7 秒一帧（±10ms 抖动），每帧走一遍和板子 `Tracker` **同样的**关联（中心距离 < 0.8 框长）、中值（3 帧，运动大时 2 帧）、自适应 EMA（按帧间隔换算）、0.6px 死区、2 帧确认、丢帧时 holding（预测但**不发**）、丢 6 帧重置；`touches_edge`（框边离画面边 4px）不发。动作执行期间的帧位置按时间插值，且只有 50% 能检出（运动模糊）。`measure` 和真机 `K230.measure` 一样：收 `since` 之后的帧，凑够 n 帧或 1.5s 超时 | `SIM_K230_TRACKER=True`，`SIM_BLUR_DETECT_P=0.5`（**估计**） | 常数全部抄自 `k230_sdcard/main.py`（`CONFIRM_FRAMES=2`、`LOST_TOLERANCE=6`、`SMOOTH_WINDOW=3`、`ALPHA_MIN/MAX`、`MOTION_REF`、`DEADBAND_PIX`、`EDGE_MARGIN`、`FOCAL_PIX=944`）；7 帧/秒来自 `config.K230_FPS` 的实测 |
| 2 | 底盘控制器速度平滑 | `SimWheeltec` **继承真机 `WheeltecChassis`**，`drive()` 一行没改（降速、按 τ×速度提前松油门、学 τ 并跨次保留）；下面是假控制器：速度一阶滞后，20Hz 回传（和 `_rx` 同样的积分方式，速度取整）；阿克曼曲率 = wz/vx，vx=0 时前轮回正，转向舵机 0.1s 滞后；编码器和地面 ±2%，陀螺仪 ±5%，跑偏 0.5° | `SIM_CHASSIS_DYNAMICS=True`，`SIM_CHASSIS_TAU_S=0.45`，每台车 ±10%（**估计**） | τ 来自 README / `drive` 注释"100mm/s 滑约 45mm"（自测里仿真滑 43.9mm）；里程计 2% 来自 README 实测；"vx=0 时前轮回正"来自底盘固件 `Vz_to_Akm_Angle`（`usartx.c`），阿克曼车型**不走** `Smooth_control`（`balance.c` 里只有麦轮/全向开），所以滑行来自电机速度环，用一阶滞后近似（**估计**） |
| 3 | 舵机死区和回差 | 只建模底座（6 号）：指令和电机当前位置差 ≤ 死区不动；输出轴在电机位置 ±回差/2 的间隙里 | `SIM_SERVO_DEADBAND_US=5`，`SIM_SERVO_BACKLASH_US=10`（**估计**，任务书给的量级） | 常见总线/PWM 舵机的死区 2~5us、齿轮回差约 0.5~1°；1° ≈ 11.1us |
| 4 | 伸出时碰歪物块 | 机械臂从别的姿态进入 reach 时，按 K230 读数算物块相对 GOAL 的偏差 / 抓取容差（取各轴最大），在 0.3~2.0 之间时有 30% 概率把物块推开 10~30mm（方向：沿相机朝向、往偏差那一侧最多偏 60°） | `SIM_PUSH_P=0.3`，`SIM_PUSH_RANGE=(0.3, 2.0)`，`SIM_PUSH_MM=(10, 30)`（**全是估计**） | 任务书；无实测 |
| 5 | 深度随距离非线性 | 按尺寸法算：每条框边 0.5px 噪声；每台车一个固定的框边长偏差 ±1px（颜色精修边界）。深度 = k·F·S/框边长，x/y = 像素 × 深度/F，所以误差 ∝ 距离²（自测：+1px 偏差在 160mm 处 −1.1mm、900mm 处 −34mm）。抓取判定也用"K230 无噪声读数"比较（用户按读数标定 GOAL） | `SIM_DEPTH_NONLINEAR=True`，`SIM_PIX_NOISE=0.5`，`SIM_BOX_BIAS_PX=1.0`（**估计**） | 深度公式抄自 `compute_position`；像素噪声量级是估计 |
| 6 | 机械臂 USB 掉线 | `SimArmSerial` 当作串口工厂交给**真机 `Arm`**：每发一帧 1% 概率掉线 0.5~2s，期间打不开；旧句柄永远写不进去（USB 重新枚举后旧 fd 失效）；掉线那帧有 30% 是"写进缓冲区没报错但丢了" | `SIM_ARM_USB_DROP_P=0.01`（**估计**），`SIM_ARM_USB_DROP_S=(0.5, 2.0)`（任务书"实测会这样"），`SIM_ARM_USB_SILENT_P=0.3`（**估计**） | `Arm` 的注释和任务书 |
| 7 | 误识别 | 每帧 0.5% 概率冒出一个假框（随机位置、深度 150~800mm、置信度 0.5~0.9），持续 2~5 帧；和真目标一起进跟踪器，按板子 `select` 的规则竞争（已锁定的真目标优先，没锁定时按置信度×面积选） | `SIM_FALSE_TARGET_P=0.005`（约 30 秒一次，**估计**），`SIM_FALSE_TARGET_FRAMES=(2, 5)` | 任务书；无实测 |

所有新因素都用独立的随机数流（`seed*31+k`），关掉其中一项时其它随机序列基本不变，便于成对比较。
第 5、7 项只在逐帧模型里完整（第 5 项在旧的测量路径里也有一个简化版），所以单项对比时它们和第 1 项一起打开。

## 3. 逐项累加对比

每档 10 台车（seed 1~10，每台车的深度误差、相机半径、τ、框偏差不同）× 100 次，有底盘 / 无底盘各 1000 次，学习打开。
复现：`cd raspberrypi/grasp && python3 sim_compare.py --n 100 --seeds 10 --fixes`（约 3 分钟）。

| 仿真因素（累加） | 有底盘 成功率 | 步数 | 用时 s | 评分 | 无底盘 成功率 | 步数 | 用时 s | 评分 |
|---|---|---|---|---|---|---|---|---|
| 原版仿真 | 93.3% | 4.03 | 41.2 | 62.5 | 95.7% | 3.08 | 36.8 | 69.1 |
| +1 K230 逐帧 + 跟踪器滞后 | 94.4% | 3.84 | 41.8 | 64.1 | 98.9% | 3.00 | 40.0 | 71.0 |
| +2 底盘控制器平滑（真机 drive 逻辑） | 94.1% | 3.75 | 47.1 | 61.8 | 98.9% | 3.00 | 40.0 | 71.0 |
| +3 舵机死区 / 回差 | 93.8% | 3.95 | 47.3 | 61.0 | 99.2% | 3.11 | 40.0 | 71.2 |
| +4 伸出时碰歪物块 | 93.4% | 4.36 | 50.4 | 58.1 | 97.9% | 3.27 | 40.9 | 69.4 |
| +5 深度随距离非线性 | 92.7% | 4.15 | 49.9 | 58.4 | 97.6% | 3.18 | 41.0 | 69.2 |
| +6 机械臂 USB 掉线 | 92.5% | 4.17 | 50.2 | 58.1 | 96.9% | 3.19 | 41.4 | 68.3 |
| **+7 误识别假目标（= 现在的默认）** | **87.5%** | 4.33 | 57.1 | 49.3 | **96.7%** | 3.38 | 44.7 | 66.0 |
| 全开 + 改进 A：`ARM_USB_ROBUST` | 87.6% | 4.35 | 57.2 | 49.4 | 97.0% | 3.38 | 44.7 | 66.3 |
| 全开 + 改进 A+B：`SEARCH_CONFIRM` | 92.6% | 4.18 | 51.8 | 57.2 | 97.1% | 3.21 | 42.9 | 67.7 |
| **全开 + 改进 A+B+C：`BASE_LIMIT_BACKUP_MM=150`** | **93.3%** | 4.21 | 51.6 | 57.5 | **97.1%** | 3.21 | 42.9 | 67.7 |

失败原因（次数 / 1000）：

| 档位 | 有底盘 | 无底盘 |
|---|---|---|
| 原版仿真 | not_found 56、lost 8、grasp_failed 2、**报成功没抓到 1** | not_found 41、grasp_failed 1、报成功没抓到 1 |
| +2 底盘平滑后 | not_found 52、grasp_failed 1、**报成功没抓到 6** | not_found 11 |
| 全开（默认） | lost 59、not_found 31、grasp_failed 20、**报成功没抓到 11**、**崩溃 2**、align_failed 2 | grasp_failed 18、lost 7、not_found 4、报成功没抓到 2、**崩溃 2** |
| 全开 + A+B+C | not_found 54、grasp_failed 12、lost 1、**报成功没抓到 0** | grasp_failed 17、not_found 10、报成功没抓到 2 |

### 单项对比（只开这一项，其它全关）

`python3 sim_compare.py --n 100 --seeds 10 --single`

| 只开 | 有底盘 成功率 | 步数 | 用时 s | 无底盘 成功率 | 步数 | 用时 s |
|---|---|---|---|---|---|---|
| （原版） | 93.3% | 4.03 | 41.2 | 95.7% | 3.08 | 36.8 |
| 1 跟踪器 | 94.4% | 3.84 | 41.8 | 98.9% | 3.00 | 40.0 |
| 2 底盘平滑 | 92.4% | 3.96 | 47.5 | 95.7% | 3.08 | 36.8 |
| 3 死区/回差 | 92.9% | 4.24 | 41.6 | 95.6% | 3.10 | 36.9 |
| 4 碰歪物块 | 91.8% | 4.37 | 43.2 | 93.9% | 3.31 | 37.9 |
| 1+5 深度非线性 | 94.6% | 3.77 | 41.7 | 98.9% | 2.91 | 39.9 |
| 6 USB 掉线 | 93.0% | 4.04 | 41.6 | 95.2% | 3.10 | 37.2 |
| 1+7 误识别 | 91.2% | 4.13 | 49.4 | 97.7% | 3.19 | 43.1 |

1000 次的成功率统计误差约 ±0.8 个百分点（1σ），差别小于 1.5 个百分点的项可以认为没有显著影响。

## 4. 逐项分析

### 1 K230 跟踪器：成功率反而略升，用时增加
- **滞后确实存在**：底座右转 3° 后，第一帧只报了 40% 的位移（−7.5mm，真实 −19.8mm），第二帧 87%，约 0.4s 后收敛。但 `SETTLE_S=0.25` 加上"只收 since 之后的帧"，第一帧基本被丢掉，剩下的滞后被 5 帧中值吸收，所以对准步数没有变多（4.03 → 3.84）。大动作（> 0.8 个框长 / 帧）时跟踪器会先 holding 2 帧再换目标、重新确认，这时是"晚到"而不是"滞后"。
- **为什么成功率升了**：原版仿真两处过于悲观：① 3% 丢帧是"整次测量直接作废"，逐帧后只是少一帧；② 碰边缘判断用"中心角 + 半个物块角"相加，比 K230 的像素判断（框边离画面边 4px）严约 1.5mm。无底盘时物块离相机只有 130~200mm，竖直可视窗口约 ±52mm，而 `SEARCH_LIFT_CM_NEAR` 间隔正好 10cm——差 1.5mm 就决定能不能扫到，所以无底盘 not_found 从 41 降到 11。
  → **这说明无底盘的搜索高度间隔没有余量**，真机上物块恰好在两个搜索高度之间时容易漏。建议近距离高度间隔缩到 8cm（例如 `[25, 17, 33, 9, 41, 1]`），交给任务 01 搜索确认。
- **用时增加**：看不到物块时，逐帧模型要等满 `MEASURE_TIMEOUT_S=1.5s` 才返回（和真机一样），原版只等 n/7 秒。搜索一圈多 3 秒左右。

### 2 底盘平滑：用时 +5s，暴露一个控制逻辑漏洞
- 停车误差现在来自真机 `drive()` 的真实行为：τ 学习后停车误差多数 < 6mm；但 τ 的估计会偏小（真值 0.45s，学到 0.36~0.40s），因为驱动在回传速度 < 5mm/s 时就认为停稳了，剩下的蠕动没计入。这是**真机也会有**的偏差，量级 2~3mm，可以接受。
- 用时 41 → 47s：`drive()` 快到终点时按剩余距离降速 + 等车停稳，走 100mm 实际要 3.3s（原版仿真按 1.3s 算）。
- **漏洞（"报成功但没抓到" 1 → 6~9 次）**：阿克曼边走边转时，**实际转过的角度比指令小**（松油门滑行时 vx=0，固件把前轮回正；转向舵机也有滞后。例：指令走 200mm 转 15°，实际 11.6°）。几次之后底座被几何前馈推到 `BASE_LIMIT_DEG=85°`，此时如果深度刚好在容差内，`align` 里 `u_d=0`、`u_x` 被限幅成 0，走到"剩下的误差小于最小动作，没法更好了" → **带着 14° 的 x 误差去抓**，必然抓空；又因为伸出后看不到物块、观察确认时物块在画面外，判成"原位置没有物块了 → 抓到"。
  → 改进 C（见第 5 节）。

### 3 舵机死区 / 回差：影响不显著
- 单项 −0.4 / −0.1 个百分点，在统计误差内；对准步数 +0.2（底座小角度修正有时一步不到位要多走一步）。
- 隐患：`AXES["x_deg"]["min"]=0.3°` ≈ 3.3us，**小于 5us 死区**，0.3~0.45° 的修正指令舵机根本不动；回差 10us ≈ 0.9°，接近 `TOL["x_deg"]=1.5°` 的一半。目前容差够宽所以没出问题。
- 建议（未改）：真机测一下死区后，把 x 的 `min` 提到死区以上（如 0.5°）；如果以后收紧 x 容差，可以在 `set_base` 里做换向回差补偿（换方向时多走半个回差）。

### 4 伸出时碰歪物块：无底盘时抓取失败明显增加
- 单项：有底盘 −1.5、无底盘 −1.8 个百分点；grasp_failed 2 → 15 / 1 → 13。
- 有底盘时被推开后能退后、重新对准、再抓，多数能救回来（多 0.3 步、+2s）。
- **无底盘时救不回来的典型过程**：物块被往外推 20~30mm → 深度超出 `REACH_FAR_D`，插值截断到 t=1 → 伸不到 → 再推一次……直到 3 次用完。这是物理限制（没有底盘，够不着就是够不着）。
- 这个因素的参数全是估计，结果对 `SIM_PUSH_P` 很敏感：降到 0.15 时全开默认有底盘 88.7%、无底盘 97.2%。
- 建议（未改，需要真机先观察到这种现象）：
  1. 伸出前在 `ready` 姿态再测一次（相机离物块更近、更准），偏差大于抓取容差的一半就退回 observe 再对一步；
  2. 无底盘时抓取失败后，如果新的深度 > `REACH_FAR_D`，直接报"够不着"并停下，不要再伸（省时间、也不会把物块越推越远）。

### 5 深度随距离非线性：没有明显影响
- 单项（和第 1 项一起开）：94.6% / 98.9%，与只开第 1 项持平，步数略少。原因：抓取发生在 160mm 附近，那里 1px 偏差只有约 1mm 深度误差，而 GOAL 是按 K230 读数标定的，固定偏差被标定吸收；远处（900mm 时 ±34mm）的误差只会让远距离那几步走得不准，靠闭环和学习吸收掉了。
- 累加时 −0.7 / −0.3 个百分点，在统计误差内。
- 注意：远处深度误差大，`AXES["d"]` 的灵敏度 J 是在不同距离混着学的，非线性会让学到的 J 偏向远处的值；目前 J 被限制在初值的 1/4~4 倍且学习率 0.3，没看到问题。

### 6 USB 掉线：会让程序直接崩溃（原代码漏洞）
- 单项：每 1000 次有 **2 次崩溃**（有底盘、无底盘都是）。原因：`Arm.move` 掉线后只重连、重发**一次**；如果重连后第一帧又掉（接触不良时很常见），第二次写入抛出的是 `serial.SerialException`，不是 `DeviceError`，`main.run_real` 不捕获，**整个程序退出**（`--once` 以外的连续运行模式也会退）。
- 另一个隐患：掉线那一帧可能"写进缓冲区没报错但没发出去"，`Arm` 却以为舵机已经到位（控制板不回传）。
- → 改进 A：`ARM_USB_ROBUST`。

### 7 误识别：影响最大
- 累加 −5.0 个百分点（有底盘），单项 −2.1；用时 +7s。
- 典型过程：搜索时底座转到某个角度，正好冒出一个持续 4~5 帧的假目标 → 凑够 3 帧中位数 → 被当成物块 → 对准第一步就朝它开 400mm 并打方向 → 下一次测量假目标没了 → "目标丢失" → 重新搜索，但车已经开走、真物块不在视野里 → 3 次机会用完。
- 敏感性：发生率减半（`SIM_FALSE_TARGET_P=0.0025`）时全开默认有底盘 90.3%。
- → 改进 B：`SEARCH_CONFIRM`。

## 5. 控制逻辑改进（都有开关、默认关闭 = 原行为）

| 开关 | 改了什么 | 效果（全开仿真，1000 次） | 代价 |
|---|---|---|---|
| A `ARM_USB_ROBUST = False` | `devices.Arm`：掉线后在 `RECONNECT_S`（5s）内**反复**重连；重连成功后把**所有舵机的最新位置**和这一帧合并整帧重发（补上可能静默丢失的上一帧）；最终失败报 `DeviceError`（主程序会关设备、3 秒后重开，不会退出） | 崩溃 2 → 0（两种模式） | 无 |
| B `SEARCH_CONFIRM = False` | `task.search`：第一次看到目标后原地再测 1~2 次，深度/y 差 ≤ max(30mm, 15%)、方位角差 ≤ 3° 才采信；看不到或对不上就继续搜 | 有底盘 87.6% → 92.6%，lost 59 → 2；用时 −5s | 每次找到目标多约 1s |
| C `BASE_LIMIT_BACKUP_MM = 0` | `task.align`（阿克曼）：底座想转的角度超过 `BASE_LIMIT_DEG`、x 还没对准、而深度已在容差内时，后退这么多并把车头往物块方向拐，下一步再往前对深度（原来会直接去抓） | 报成功没抓到 7 → 0；成功率 92.6% → 93.3% | 偶尔多一步 |

- 在**原版仿真**（新因素全关）下打开 A+B+C：有底盘 93.3% → 93.7%，无底盘 95.7% → 95.2%（统计误差内），用时 +1s。**不会让原来的情况变差**。
- 三个开关都加进了 `CALIB_KEYS`，可以在 `calib.json` 里打开做真机对比。
- 默认值全部关闭时，`task.py` / `devices.py` 的行为和改之前完全一样：用原版仿真复测，同 seed 的结果逐位一致（例如 seed 31 有底盘 40 次：37/40、4.2 步、38.4s、63.1 分，和改之前的 selftest 输出相同）。
- **建议真机按 A → C → B 的顺序打开试**：A 只影响掉线时的行为、没有副作用；C 只在底座顶到极限时触发；B 会改变搜索节奏，先观察 K230 实际误识别多不多。

## 6. 额外发现：视场角配置可能反了（需要真机确认）

`k230_sdcard/main.py`：AI 画面是 1280×720，`ROTATE_DEG = 90`、`POSITION_IN_ROTATED_FRAME = True`，所以发出来的 X 是在**旋转后 720 宽 × 1280 高**的画面里算的（`compute_position` 里 `pw, ph = frame_h, frame_w`）。按 `FOCAL_PIX = 944`：

- 水平半视场 ≈ atan(360/944) = **20.9°**，竖直半视场 ≈ atan(640/944) = **34.1°**
- 而 `config.py` 是 `FOV_X_DEG = 35`、`FOV_Y_DEG = 25`，看起来正好是没旋转时的水平值。

`FOV_*` 只用于仿真和人为设计搜索角度，控制逻辑本身不用，所以我**没有改默认值**。但如果真机确实是 21°×34°：

| 条件（全开 + A+B+C） | 有底盘 | 无底盘 |
|---|---|---|
| FOV 35°×25°（现配置） | 93.3% | 97.1% |
| FOV 21°×34° | **63.0%** | **55.0%** |
| FOV 21°×34° + 搜索角加密 `SEARCH_BASE_DEG=[0,±38,±76,±85]`、`SEARCH_BASE_DEG_NEAR=[0,±25,±50,±75]` | 84.5% | 71.5% |

主要是水平视场窄了，现在 ±55° 的搜索步距之间有 13° 的空隙，对准时物块也更容易滑出画面。
**真机确认方法**：物块放在相机正前方 300mm，慢慢往右移到 K230 刚好不再发位置帧，记下最后一帧的 X 和 D，半视场 ≈ atan(X/D) + 半个物块角；上下同理。确认后改 `FOV_X_DEG / FOV_Y_DEG`，再让任务 01 重新搜索 `SEARCH_*` 参数。

## 7. 其它观察（没有改）

- **有底盘 not_found 约 5%**（原版仿真就有）：场景里物块离车 300~1200mm，而 `SIM_MAX_DETECT_MM=900`；搜索都没找到时 `SEARCH_BACKOFF_MM=250` 会**后退**再搜，对太远的物块反而更远。这是场景/搜索策略问题，留给任务 01（例如"没找到就往前开一段再搜"）。
- **观察确认的判据偏乐观**：`_observe_check` 里"看不到物块"一律当成"抓到了"。底座在极限、物块在画面外时会误判（改进 C 消除了最主要的触发场景）。如果以后还有误报，可以考虑"看不到时再转一下底座看看"。
- 仿真速度：全开后 100 次约 1 秒（逐帧模型只在需要时补算帧），任务 01 可以放心大规模搜参数。

## 8. 自测

```
cd raspberrypi/grasp && python3 selftest.py
...
仿真真实度因素（任务 02）
  ✅ 仿真底盘走真机 WheeltecChassis.drive
  ✅ 100mm/s 松油门滑行约 45mm（README 实测）   43.9mm
  ✅ 仿真底盘：走 2 次后里程停车误差 ≤ 8mm   -6.0 -1.9 +0.9 +0.2
  ✅ 跟踪器：动作后第一帧是滞后的旧位置   第一帧 -7.5，真实 -19.8
  ✅ 跟踪器：1 秒后收敛   -19.9
  ✅ 舵机死区：3us 的指令不动
  ✅ 舵机回差：从两边到同一位置差约 10us   1595 / 1605
  ✅ 小偏差伸出：物块被推开 10~30mm   28.2mm
  ✅ 尺寸法测深：900mm 处误差约是 160mm 处的 (900/160)² 倍   -1.12 / -34.4mm
  ✅ USB 掉线 1s：Arm 等它回来、重连后指令生效   用时 1.4s
  ✅ SEARCH_CONFIRM：复测看不到的目标不采信
  ✅ SEARCH_CONFIRM：复测一致的目标采信
  ✅ SEARCH_CONFIRM：复测位置对不上的不采信
仿真回归（整套流程）
  ✅ 有底盘 40 次，真实抓到 ≥ 85%   真实抓到 35/40 = 88%   平均对准步数 4.1   平均用时 49.9s   平均评分 52.8
  ✅ 无底盘 30 次，真实抓到 ≥ 85%   真实抓到 30/30 = 100%   平均对准步数 3.4   平均用时 43.4s   平均评分 69.6
  ✅ 有底盘 40 次（打开任务 02 的改进开关），真实抓到 ≥ 85%   真实抓到 36/40 = 90%   平均对准步数 4.0   平均用时 49.9s   平均评分 55.4

通过 52 项，失败 0 项
```
机械臂一节还新增了两项：`连续掉两次：原行为抛异常（ARM_USB_ROBUST=False）`、`连续掉两次：robust 模式重连成功，整帧重发所有舵机`。

关于 85% 阈值：仿真回归在更真实的默认仿真下有底盘是 88%（原来 92%），**仍然达标，阈值没动**。余量只有 3 个百分点，主要被误识别吃掉；打开改进 B 后能拉回来。
关于"仿真成功率不能比改之前低"：在同一个（原版）仿真里，默认配置下的代码行为和改之前逐位一致；新仿真下数字变低是因为仿真更严格了，不是控制变差了。

## 9. 没有在真机验证的内容

- 所有 `SIM_*` 估计参数：运动中检出率 50%、舵机死区 5us / 回差 10us、推开概率和距离、像素噪声 0.5px、框偏差 ±1px、USB 掉线频率 1% / 静默丢帧 30%、误识别频率。
- 底盘一阶滞后模型、"松油门时前轮回正"对边走边转角度的影响（建议真机测：`drive(200, 15)` 后看陀螺仪实际转角）。
- 改进 A/B/C 在真机上的效果（都默认关闭）。
- 第 6 节视场角的推算。
- `devices.py` 的两处时钟/串口注入重构：逻辑上和原来等价，selftest 的真时间底盘测试和机械臂帧比对都通过，但没有接真机跑过。
