AULAGE/dache/docs/cloud_tasks/results/04_报告.md

# 任务 04 报告：K230 识别程序审查与提速

> 分支：`cloud/04-k230-review`　|　改动文件：`k230_sdcard/main.py`、新增 `k230_sdcard/tests/`、`k230_sdcard/tools/depth_fit.py`
>
> ⚠️ **全部未在真机验证**。云端没有 K230、没有 CanMV 环境。本报告里的 bug 是读代码发现、再用 CPython + numpy
> 离线复现的；**所有耗时数字都是估计**（numpy 和 ulab 速度差很多），以板子上 `Profiler` 的输出为准。

## 0. 一句话结论

- **找到 3 个会影响串口输出的 bug**（都已加开关修好，默认关闭保持原行为）：旋转框角度回绕时宽高没互换（长方形目标测深最多偏 30%）、
  旋转框拟合失败时沿用的旧框原地不动（最多发 3 帧旧位置）、深度 < 0.5mm 时被截成 D=0 冒充心跳。另有若干低风险问题只记录不改。
- **提速**：代码里能做的（结果不变的几项）估计能从 ~143ms/帧省 10~30ms（约 7 → 8~9.5 帧/秒，**估计**）；
  真正的大头是 **KPU 推理（640×640）**，而且当前的 letterbox 让 **44% 的输入像素是灰边**——换成 640×384 的模型可以白省 ~40% 的 KPU 计算，
  不用改代码（`deploy_config.json` 里的 `img_size` 程序会自动读）。
- **深度**：默认的畸变系数 `dist_coeffs = [-0.2, 0.1, ...]` 看起来是没标定的占位值；如果镜头实际畸变没这么大，
  **画面边上深度会偏小最多 16%**（离线测试量化）。中心附近不受影响。给了标定步骤和拟合工具。
- 帧率提上去以后，**`UART_INTERVAL_MS = 100` 会把位置帧限制在 ≤10Hz**（超过 10 帧/秒时等于隔帧发），记得一起改小。

## 1. 改了什么

所有开关都在 `main.py` 开头配置区新增的"审查修复 / 提速开关（云端任务 04）"一节，**每项可以单独开关**：

| 开关 | 默认 | 类型 | 作用 |
|---|---|---|---|
| `FIX_OBB_ANGLE_WRAP` | `False` | bug 修复 | 旋转框角度跨 0°/90° 时宽高一起互换（见 B1） |
| `FIX_STALE_OBB` | `False` | bug 修复 | 旋转框拟合失败时，沿用的旧框跟着正框平移/缩放（见 B2） |
| `OBB_HOLD_FRAMES` | `3` | 参数 | 连续几帧拟合不到旋转框后退回正框（原来写死 3） |
| `FIX_DEPTH_NONZERO` | `False` | bug 修复 | 深度 < 1mm 时不发位置帧，避免冒充心跳（见 B3） |
| `FAST_OBB_POINTS` | `True` | 提速，结果不变 | `fit_obb` 先挑出掩膜内的点再搜角度；ulab 不支持布尔下标时自动退回原算法 |
| `CACHE_CENTER_COLOR` | `True` | 提速，结果不变 | 同一帧同一个框的 `center_color` 只算一次 |
| `OSD_EVERY` | `1` | 提速，只影响显示 | 每几帧画一次 OSD；1 = 原行为 |
| `PRINT_OBJECT` | `True` | 提速，只影响终端 | 关掉每次发帧时的 `Object:` 打印 |
| `GC_MIN_FREE_KB` | `0` | 提速 | >0 时改成"空闲内存低于阈值才 gc"；0 = 原来的每 `GC_EVERY` 帧 |
| `REFINE_GRID_CEIL` | `False` | 提速，结果微变 | 颜色精修降采样网格不超过 `REFINE_GRID`（见 S6） |
| `PROFILE_DETAIL` | `False` | 诊断 | `Profiler` 多打一行颜色精修内部各步耗时 |

**默认配置下串口输出和原程序完全一致**（离线测试 `test_main_differs_from_original_only_by_switches` 拿板子原版程序逐项对比；
两个默认打开的提速项也包括在内）。唯一可见的变化：终端 `Object:` 行多了一个 `S:xxx.xpx`（像素边长，标定深度要用），不影响串口。

没有改：串口帧格式（`AA 55 | X | Y | D | CRC8 | 0D`、D=0 心跳）、`ROTATE_DEG = 90`、`POSITION_IN_ROTATED_FRAME`、坐标约定、串口引脚和波特率。
`摄像头/vision_locator.py`（原版副本）没动。

## 2. Bug 列表

行号：**"旧"= 当前板子上跑的 `k230_sdcard/main.py`（本分支改之前，即 `main` 分支上的版本），"新"= 本分支的 `main.py`**。

| # | 严重程度 | 位置（旧 → 新） | 问题 | 触发条件 | 修复 |
|---|---|---|---|---|---|
| B1 | **中** | `fit_obb` 462→542；`subpixel_refine` 561→644；`Tracker._update_obb` 727→846 | 旋转框角度用 `% 90` 归一，但 (w, h, a) 和 (h, w, a±90°) 才是同一个矩形，**宽高没互换** → 长方形目标被转 90°。`fit_obb` 带角度提示时可能搜到 90°（提示 ±6° 会越界）→ 取模成 0°、宽高没换；接着亚像素精修把错的框"修"成另一个尺寸 | 目标**不是正方形**（被爪子挡住一部分、两块粘连、`REFINED_ASPECT_MAX` 允许到 1.7）**且**转角在 0°/90° 附近 ±6° 内。正方形 w≈h，看不出来 | `FIX_OBB_ANGLE_WRAP`：新函数 `norm_obb_angle()` 归一时奇数个 90° 就互换宽高，三处都用它 |
| B2 | **中** | `Tracker._update_obb` 706~711→816~830；用到的地方 `obb_now = tracker.predicted_obb()` 1189 | 某帧颜色精修成功但旋转框没过（`obb=None`），`tracker.obb` 原地保留最多 3 帧；`compute_position` **优先用 obb**，所以正框已经跟着目标动了，发出去的 X/Y/D 还是旧的 | 爪子挡住物块、旁边有同色物块、宽高比超限等导致旋转框连续 1~3 帧失败，**同时**目标在画面里有移动（相机在手上，机械臂/底盘一动就会）。树莓派 `SETTLE_S=0.25s` 后采样，可能采到动作之前的位置 | `FIX_STALE_OBB`：旧框跟着平滑正框的中心平移、按边长比例缩放；`OBB_HOLD_FRAMES` 可调 |
| B3 | 低 | `send_position_via_uart` 905→1031；主循环 1240→1391 | 深度截到 `[0, 65535]` 后取整；算出 < 0.5mm 的深度（例如 `DEPTH_OFFSET` 设成较大的负数）会发 D=0，**树莓派当成心跳**（"没看到物块"） | 只在标定参数不合理时出现 | `FIX_DEPTH_NONZERO`：深度 < 1mm 时不发位置帧（照常发心跳） |
| B4 | 低（只影响显示） | `predicted()` 694 vs `predicted_obb()` 702 | 一个外推 `miss+1` 帧、一个外推 `miss` 帧，预测（holding）时正框和旋转框差一帧 | 跟踪器在预测时；此时本来就不发位置帧 | 未改（不影响串口） |
| B5 | 低 | 主循环 `moving = ...` 1160 | `tracker.motion` 是**上一帧**算的运动量，判断"在动、跳过亚像素"晚一帧 | 目标刚开始动/刚停下的那一帧 | 未改（影响很小） |
| B6 | 低 | 1117 | 图像格式不对时 `continue` 跳过了心跳、gc 和帧计时 | 基本不会发生 | 未改 |
| B7 | 低 | 1171 | 颜色精修连续出错 5 次后 `color_ok=False`，**永久**关闭颜色精修和颜色门限，不会恢复 | 板子上出现过异常才会 | 未改（出现时终端会打印 `color features disabled`，看到要报告） |
| B8 | 低（精度） | `compute_position` 853 | 主点假设在画面正中心 `(W/2, H/2)`，而像素坐标以像素中心为整数，严格说中心应是 `(W-1)/2`；更大的问题是实际主点可能偏几十像素 | 一直存在 | 未改；0.5px 只差 ~0.1mm；主点偏差是**常数偏移**，树莓派按 K230 读数标的 `GOAL` 会吸收掉 |
| B9 | 性能 | `_refine_once` 603→705 | 降采样步长 `// REFINE_GRID` 向下取整：搜索区域 95px 时步长 1、网格 95×95=9025 点（注释写"约 48×48"）。**目标越小网格越大**，`fit_obb` 每个角度的计算量最多是 48×48 时的 4 倍；`_grid_coords` 缓存（最多 25 组）也可能占到 ~1.8MB | 目标远/小（搜索区域 < 96px 或在 96~143px 之间） | `REFINE_GRID_CEIL`（默认关，结果会微变） |
| B10 | 潜在瓶颈 | `UART_INTERVAL_MS = 100`（101），1241 | 两次位置帧之间必须 > 100ms：帧率 ≤ 7~10 时没影响；**提速到 >10 帧/秒后位置帧会被隔帧丢掉**（例如 15 帧/秒只发 7.5 帧/秒） | 提速之后 | 不改代码；提速后把它改成 `50`（树莓派按帧到达处理，不怕快） |

### 检查过、没发现问题的地方

- **坐标旋转**：`rotate_point`/`rotate_box`（90° 顺时针 `(x,y)→(H−y, x)`）互相一致；`compute_position` 在 `ROTATE_DEG=90` 下
  原始画面往上 = X 正、往右 = Y 正，符合"X 右、Y 下"，和树莓派实测一致（测试 `TestGeometry`）。
- **边缘判断** `touches_edge`（848）：合成了物块伸出画面右边 3/20/70px、转 0°/20°/40° 的情况，全部正确判为碰边（不发位置帧）。
- **畸变校正** `undistort_point`：确实是 OpenCV (k1,k2,p1,p2,k3) 模型的反函数，迭代收敛到 0.05px 以内。
- **时间戳回绕**：所有时间差都用了 `time.ticks_diff`，写法正确。只有 `last_send_time = 0`（1098）这个初值在
  "ticks 周期为 2³⁰（32 位 MicroPython）且开机超过 6.2 天"时会让第一次发送被推迟；K230 大核是 64 位，周期大得多，**实际不会触发**。
  `Profiler` 的 `ticks_us` 在 32 位下 17.9 分钟回绕一次，单帧计时远小于半周期，也没问题。
- **异常处理**：所有 `except` 都放行了 IDE 停止信号；`finally: cleanup()` 能释放摄像头。主循环出错只计数打印，不会卡死。
- **协议**：帧格式、CRC8 和树莓派 `devices.K230` 的解析完全对得上（测试 `TestProtocol`）。
- **跟踪器平滑延迟**：相机动一下（目标跳 5~40px）后，平滑输出 ≤3 帧就落到 1px 以内（7 帧/秒下 ≈0.4 秒）。
  这是树莓派每步要等几帧的原因之一；提速后同样的帧数用的时间更短（`ALPHA_*` 已按实际帧间隔换算）。

### B1 的复现数据（离线，合成图，`USE_UNDISTORT=False`）

150×110 的长方形（被挡住一部分的物块），转 88°，上一帧角度提示 88°：

| | 旋转框 | 测到的长边 | 深度误差 |
|---|---|---|---|
| 原版 | `[641.5, 363.0, 115, 115, 0.0]`（转错 90°，中心也偏了 3.5px） | 115px | **+30%（偏远）** |
| `FIX_OBB_ANGLE_WRAP=True` | `[639.6, 359.4, 150.1, 110.2, 88.1]` | 150px | < 2% |

跟踪器平滑这一处单独测（输入已是正确表示）：转角在 −1°↔+1° 之间来回时，原版跨界那一帧框被转 90°，下一帧最长边掉到 138px（深度偏远约 9%），
之后几帧才恢复；修复后一直是 150px。

## 3. 耗时分析和提速方案

### 3.1 `Profiler` 统计了哪些阶段

`DEBUG_TIMING = True` 时每 30 帧打印一行 `[timing ms/frame] capture | ai2d+kpu | post | select | refine | pos+draw | show+gc | total (fps)`：

| 阶段 | 包含的代码 | 估计耗时（**没测过，按 K230 常见数据推的**） | 说明 |
|---|---|---|---|
| `capture` | `sensor.snapshot` | 5~35ms | 含等下一帧（传感器 30fps）；处理慢时多半很短 |
| `ai2d+kpu` | 缩放 + letterbox + YOLO 640×640 推理 | **40~70ms（最大头）** | 模型名带 `_s`，像 YOLOv5s 级别 |
| `post` | 3 个输出 `to_numpy()` 拷贝 + `aicube` 解码 + NMS | 5~15ms | 3 个输出共 3×10×(80²+40²+20²)=25.2 万个 float ≈ **每帧 1MB 新分配**，也是 gc 压力的主要来源 |
| `select` | 跟踪关联 + 颜色门限 | 1~3ms | |
| `refine` | 颜色精修：center_color、掩膜、`fit_obb`、亚像素 | 10~40ms | `fit_obb` 全范围搜 36 个角度（首帧/转得快时），带提示时 11 个；亚像素是纯 Python 逐像素读（~750 次 ulab 标量下标） |
| `pos+draw` | `osd_img.clear()`（608×1072 ARGB = 2.6MB）+ 画线 + 4~6 次 freetype 文字 | 5~15ms | |
| `show+gc` | `Display.show_image`（再拷 2.6MB）+ 每 3 帧一次 `gc.collect()` | 5~20ms | |

合计 ~143ms（≈7 帧/秒，和实测一致）。**真机第一件事就是看这一行的真实数字**，再决定先做哪项。

### 3.2 提速项

| # | 方案 | 开关 / 做法 | 预计收益（**估计**） | 对结果的影响 |
|---|---|---|---|---|
| S1 | `fit_obb` 只算掩膜内的点（布尔下标），每个角度从 14 次整图运算变成 10 次、点数只剩 30~50% | `FAST_OBB_POINTS = True`（默认开） | numpy 实测 `fit_obb` 快 **1.9 倍**；板子上估计省 3~15ms/帧（全范围搜索时多） | 无（测试逐位对比原算法）。ulab 不支持布尔下标时启动打印 `FAST_OBB_POINTS: off`，自动用原算法 |
| S2 | `center_color` 每帧缓存 | `CACHE_CENTER_COLOR = True`（默认开） | 跟踪中每帧少算一次（5 个小块均值）：估计 1~3ms | 无 |
| S3 | 隔帧画 OSD | `OSD_EVERY = 3` | 车上跑时没人看 HDMI，省 2/3 的 clear+画字+show：估计 5~20ms | 只影响显示 |
| S4 | 不打印 `Object:` | `PRINT_OBJECT = False` | 连着 IDE 时每次打印 ~0.5~2ms | 只影响终端 |
| S5 | 按空闲内存决定 gc | `GC_MIN_FREE_KB = N`（先在终端 `print(gc.mem_free())` 看总量，设成 1/3 左右） | 0~10ms，不确定（gc 次数变少，但每次时长不变） | 无；设太小可能 MemoryError，要长时间跑观察 |
| S6 | 精修网格不超过 48×48 | `REFINE_GRID_CEIL = True` | 小/远目标 `fit_obb`+掩膜最多快 4 倍：估计 2~10ms | 测深微变：合成图上 40~130px 目标误差仍 < 2.5%（亚像素补回来） |
| S7 | **换 640×384 输入的模型**（同样训练数据，导出时设长方形输入） | 不改代码：换 kmodel，`deploy_config.json` 里 `img_size: [640, 384]`；`two_side_pad_param` 会自动算 12px 的边 | 现在 1280×720 → 640×360 放进 640×640，**上下 280 行全是灰边（44%）**。640×384 的 KPU 计算 ≈ 60%：估计省 15~30ms | 分辨率不变，精度应不变。**要确认** AICube 能导出非正方形输入、`aicube.anchorbasedet_post_process` 支持非正方形 |
| S8 | 换更小的输入（416×256 / 320×192） | 同上，重新训练/导出 | KPU 再降到 1/2~1/4：估计再省 10~30ms | 抓取距离上物块在 1280 画面里约 75~230px，320 输入里 19~58px，检测应该够；但置信度会变，`confidence_threshold` 要重调。颜色精修仍在 1280×720 原图上做，测深精度不受影响 |
| S9 | 提速后放开串口限速 | `UART_INTERVAL_MS = 50` | 帧率 >10 后位置帧不再被隔帧丢弃 | 树莓派收到的帧更多 |
| — | 诊断 | `PROFILE_DETAIL = True` | — | 多打一行 `[timing detail ms/frame] r.color | r.mask | r.obb | r.subpix`，看 `refine` 里谁最慢 |

**合起来估计**：S1~S5（代码层）7 → 8~9.5 帧/秒；再加 S7 → ~10 帧/秒；S8 → 12~15 帧/秒。**全是估计**，以板子 Profiler 为准。

没做、但可以考虑的（改动大或者影响精度，留给真机数据决定）：
- 亚像素精修（`subpixel_refine`）是纯 Python 逐像素读，如果 `r.subpix` 很大，可以只在目标静止、而且树莓派要采样的时候做（现在已经是"在动就跳过"：`SUBPIX_WHEN_MOVING=False`）。
- `fit_obb` 全范围搜索改成先 9° 粗搜再细搜（角度面积曲线对正方形基本单峰），能再少一半角度，但结果会变。
- 每帧 1MB 的 `to_numpy()` 拷贝：看 CanMV 版本有没有 `to_numpy_ref()` 一类不拷贝的接口。

## 4. 深度精度

### 4.1 公式

```
size_pix = max(两组对边的平均长度)          # 畸变校正后的 4 个角点
D = BLOCK_REAL_SIZE × FOCAL_PIX / size_pix × DEPTH_SCALE + DEPTH_OFFSET
X = (u − 画面中心) × D / FOCAL_PIX           # 旋转到正向画面后
```

一个有用的结论：`DEPTH_OFFSET = 0` 时 `X = Δu × 边长 × DEPTH_SCALE / size_pix`，**和 FOCAL_PIX 无关**——焦距标错只影响深度、不影响 X/Y。

### 4.2 误差来源（按影响大小排）

1. **畸变系数没标定**（`dist_coeffs = [-0.2, 0.1, 0, 0, 0]`、`USE_UNDISTORT = True`，第 35~36 行注释自己写着"未标定请关掉"）。
   离线量化（理想无畸变镜头 + 默认系数）：

   | 物块中心 x（1280 宽） | 640（中心） | 800 | 960 | 1100 | 1200 |
   |---|---|---|---|---|---|
   | y=360 时深度误差 | 0% | −1.7% | −6.5% | −12.3% | −16.0% |

   镜头实际畸变越接近这组数越好；不知道就按 4.3 步骤 1 测。X/Y 也一起偏。
2. **侧面算进物块**：`SHADE_TOLERANT = True` 让"亮面/暗面都算同色"，相机斜着看时立方体的侧面会被并进掩膜 → 框变大 → **深度偏近**。
   腕部相机角度变化大时这个误差也跟着变。
3. **焦距 / 偏移**：`FOCAL_PIX = 944` 和 `DEPTH_SCALE/OFFSET = 1/0` 是否标过不确定；距离是从镜头光心算起，尺子量的是到镜头前端，差一个常数 → `DEPTH_OFFSET`。
4. **斜视**：顶面不正对镜头时一个方向被压缩 cos(倾角)；取最长边能抵消绕一个轴的倾斜，两个轴都斜时偏远。
5. **主点不在中心**（B8）：X/Y 的常数偏移，树莓派 `GOAL` 按 K230 读数标定，会吸收掉。
6. **算法本身**：理想合成图上 40~300px、0~89° 各种情况，深度误差 < 2.5%，中心误差 < 1px（测试 `test_refine_accuracy_squares`）。

**对抓取的影响**：树莓派的 `GOAL` 是按 K230 读数标的，所以"在目标位置上"的系统误差会抵消；系统误差主要影响**离目标远时的前馈步长**
（画面边上 X/D 偏得多 → 多走几步才对准）。所以标定的目标是**整个画面里一致**，不一定要绝对准。

### 4.3 标定步骤

工具：`k230_sdcard/tools/depth_fit.py`（CPython，标准库，在电脑或树莓派上跑）。新版 `Object:` 行有 `S:` 像素边长。

1. **先查畸变**（决定 `USE_UNDISTORT`）：物块平放，相机正对桌面、高度固定（例如 200mm），把物块依次放在画面中心、左右边、四个角
   （别碰边），每处用 `python3 calib.py watch` 记 10 秒深度中位数。
   - 各处差 < 3%：保持现状。
   - 边上明显**偏小**：默认系数校正过头，改 `USE_UNDISTORT = False` 再测一次，选更平的那个。
   - 边上明显**偏大**：镜头畸变比默认更大，需要正式标定：用 CanMV IDE 存 15~20 张 1280×720 的棋盘格照片（不同角度/位置），
     电脑上 OpenCV `calibrateCamera` 得 `fx, fy, cx, cy, k1, k2, p1, p2, k3`；`fx` 填 `FOCAL_PIX`，后五个填 `dist_coeffs`。
     （程序假设 `fx = fy`、主点在正中；OpenCV 算出的主点离中心很远时告诉我，再加主点参数。）
2. **焦距 + 偏移**：物块放在画面中心，用尺子量镜头前端到物块顶面的距离，取 5~6 个距离（覆盖实际抓取范围，例如 80/120/160/200/250/300mm），
   每个距离记 `Object:` 行的 `D` 和 `S` 中位数，写成 CSV：
   ```
   # 真实距离mm, D, S
   80, 77.9, 290.1
   ...
   ```
   ```bash
   python3 k230_sdcard/tools/depth_fit.py data.csv --size 24
   ```
   把打印的 `FOCAL_PIX`、`DEPTH_SCALE = 1`、`DEPTH_OFFSET` 写进 `main.py`。拟合后最大误差 > 5mm 说明读数不稳或物块没正对。
   （只有 `D` 没有 `S` 时也能拟合：`--scale`/`--offset` 填采数据时板子上的值，输出新的 `DEPTH_SCALE`/`DEPTH_OFFSET`。）
   旧的 `CALIB_DISTANCE_MM` 单点模式也能用，但只能得到焦距、得不到偏移。
3. **横向检查**：深度固定，物块左右平移已知距离（±20、±40mm），看 X 的变化量；差 > 5% 再检查 `BLOCK_REAL_SIZE`（物块实际边长）。
4. **树莓派重标 `GOAL`**：K230 读数的单位变了，`python3 calib.py goal` 重新标一次（见 `raspberrypi/README.md`）。

## 5. 离线测试

```bash
cd k230_sdcard/tests
python3 test_k230.py        # 需要 numpy（ulab.numpy 的替身）；32 项，约 8 秒
```

- `k230_stub.py`：装上假的 CanMV 模块（media、nncase_runtime、aicube、machine、ulab→numpy），**直接导入真的 `main.py`**（不是抄一份函数），
  可以用参数覆盖配置开关。
- `synth.py`：合成测试图（抗锯齿的旋转纯色方块/长方形，`(3, H, W)` uint8，和 RGBP888 一样）。
- `test_k230.py`：协议/CRC、坐标旋转、深度公式、畸变反函数、颜色精修精度、B1/B2/B3 复现、提速项结果不变、
  默认开关等于原版、`_NullOSD` 方法齐全、标定工具。
- **ulab 和 numpy 的差异**：浮点都是 float32；ulab 不一定支持布尔下标（`FAST_OBB_POINTS` 启动时自检，测试里两条路径都测）；
  ulab 标量下标慢得多，所以**测试里的耗时不代表板子**。

本分支没有改 `raspberrypi/grasp/`；顺手跑了 `python3 selftest.py quick`：通过 34 项，失败 0 项。

当前测试输出：
```
Ran 32 tests in ~8s
OK
[参考] numpy 下 fit_obb 全范围搜索：原算法 1.53ms，FAST_OBB_POINTS 0.81ms（1.9 倍）
```

## 6. 真机验证清单

准备：用本分支的 `k230_sdcard/main.py` 替换板子 SD 卡上原来的 `main.py`（**先备份旧文件**；模型和 `deploy_config.json` 不用动）。
每一步只改一个开关，记 3 行 `[timing ...]`（`DEBUG_TIMING = True` 已默认开）和 `calib.py watch` 30 秒的读数。

| 步 | 改什么 | 看什么 | 期望 / 判断 |
|---|---|---|---|
| 0 | 不改（默认配置） | Profiler 各阶段真实耗时、FPS；`calib.py watch` 静止物块的 D/X/Y 均值和抖动；树莓派 `main.py --check` 2 秒帧数 | 和旧程序一样（≈14 帧/2 秒）。**把这一行 timing 发给我**，后面的估计就能换成实测 |
| 1 | 看启动打印 | `FAST_OBB_POINTS: on` 还是 `off` | `off` 说明 ulab 不支持布尔下标，S1 无效（不会出错） |
| 2 | `FAST_OBB_POINTS = False` ↔ `True` | `refine` 一栏 | `True` 时 `refine` 变小；`calib.py watch` 读数不变 |
| 3 | `PROFILE_DETAIL = True` | `[timing detail]` 一行 | 找出 `r.color / r.mask / r.obb / r.subpix` 谁最大，决定下一步 |
| 4 | `OSD_EVERY = 3` | `pos+draw`、`show+gc` | 两栏都变小；HDMI/IDE 画面变卡是正常的 |
| 5 | `PRINT_OBJECT = False` | `pos+draw` | 连着 IDE 时略小 |
| 6 | `GC_MIN_FREE_KB`：先临时加一行 `print(gc.mem_free())` 看空闲内存，设成其 1/3 | `show+gc`；连续跑 10 分钟 | 变小且不报 MemoryError；报错就改回 0 |
| 7 | `REFINE_GRID_CEIL = True` | 物块放远（~300mm）静止：`refine` 和 D 的均值/抖动 | `refine` 变小，D 均值差 < 2%、抖动不明显变大 |
| 8 | `FIX_OBB_ANGLE_WRAP = True` | 物块转到 ~0° 或 ~88°，用手指/爪子挡住一部分（让可见部分是长方形），看 OSD 框和 `calib.py watch` 的 D | 原版：框偶尔转 90°、D 跳变；修复后框贴合、D 稳定。正方形不挡时两者一样 |
| 9 | `FIX_STALE_OBB = True` | 物块被挡一部分时慢慢移动相机（或物块）；看 OSD 框是否跟手、D/X 有没有"卡住一下再跳" | 修复后不卡顿 |
| 10 | `FIX_DEPTH_NONZERO = True` | 正常情况下无变化 | 没变化就对了 |
| 11 | 帧率 >10 后 `UART_INTERVAL_MS = 50` | 树莓派 `--check` 2 秒帧数 | ≈ 2 × 帧率 |
| 12 | 深度标定（第 4.3 节） | `depth_fit.py` 拟合误差；之后 `calib.py goal` | 拟合后误差 < 5mm |
| 13 | （可选，大改）640×384 / 320×192 模型 | `ai2d+kpu`；识别率 | KPU 时间按像素数成比例下降；识别不掉帧 |
| 14 | 整套抓取 | 每次抓取的对准步数和总时间（和改之前比） | 步数不变或更少，时间更短 |

建议的上车配置（都确认过以后）：`FIX_OBB_ANGLE_WRAP = FIX_STALE_OBB = FIX_DEPTH_NONZERO = True`、`OSD_EVERY = 3`、`PRINT_OBJECT = False`，
其余看步骤 0~7 的数据决定。

## 7. 还没在真机验证的（全部）

- 所有 bug 修复（B1~B3）只在合成图和 CPython 上验证过；真实图像里旋转框失败的频率、B1/B2 实际出现多少次未知。
- 所有耗时数字是估计；ulab 是否支持布尔下标未知（不支持也不会出错，只是 S1 不生效）。
- `gc.mem_free()`、`dict.clear()`、`list.clear()`、`math.floor` 在 CanMV MicroPython 里都是标准接口，但没在板子上跑过；新代码没用 CPython 专有语法。
- 640×384 模型能否导出、`aicube` 后处理是否支持非正方形输入，未确认。
- 畸变系数是不是占位值，要按 4.3 步骤 1 在真机上判断。
