AULAGE/dache/raspberrypi/grasp/research/worldmodel/results/results_full.md

# 任务 14 结果（full，**合成数据**，种子 0）

训练 1200 条序列 × 24 步，测试 200 条；每个变体训练 15.0 分钟（full 1165 步, noprior 1030 步, nogru 1133 步, cmdonly 1138 步），设备 cpu。

## H1 视觉本体感知：线性探针从隐状态解码真实舵机角（测试集平均绝对误差）

| 方法 | 底座 ° | 升降 cm | 底座：回差 0~1° | 1~2° | 2~3.5° | ≥3.5° | 回差方向识别率 |
|---|---|---|---|---|---|---|---|
| 命令积分（开环） | 1.188 | 0.0845 | 0.495 | 0.870 | 1.429 | 1.917 | 0.0% |
| 方向记忆规则（上一次转动方向 × 常数） | 0.774 | 0.0376 | 0.602 | 0.457 | 0.817 | 1.400 | 91.7% |
| 对照：未训练的同结构模型（随机权重） | 0.755 | 0.0528 | 0.660 | 0.595 | 0.751 | 1.116 | 93.1% |
| 完整模型（GRU 命令历史 + 画面，分离先验） | 0.738 | 0.0531 | 0.652 | 0.598 | 0.735 | 1.058 | 93.1% |
| 无分离先验（槽位自由移动） | 0.752 | 0.0532 | 0.666 | 0.604 | 0.749 | 1.083 | 92.7% |
| 无 GRU（只用当前命令 + 当前画面） | 0.776 | 0.0615 | 0.616 | 0.576 | 0.772 | 1.255 | 91.3% |
| GRU 只看命令历史（不看画面） | 0.753 | 0.0530 | 0.670 | 0.606 | 0.734 | 1.102 | 92.6% |

## H2 自身 / 世界分离：槽位掩膜和真实掩膜的 IoU（测试集）

| 变体 | 爪子最佳 IoU | 物块最佳 IoU | 自动判自身（按 w）的爪子 IoU | 判别正确率（按 w） | 自动判自身（按位移）的爪子 IoU | 判别正确率（按位移） |
|---|---|---|---|---|---|---|
| 完整模型（GRU 命令历史 + 画面，分离先验） | 0.018 | 0.057 | 0.000 | 0.0% | 0.000 | 0.0% |
| 无分离先验（槽位自由移动） | 0.041 | 0.463 | nan | nan% | 0.017 | 28.2% |
| 无 GRU（只用当前命令 + 当前画面） | 0.025 | 0.109 | 0.002 | 0.0% | 0.001 | 3.1% |
| GRU 只看命令历史（不看画面） | 0.023 | 0.169 | 0.000 | 0.0% | 0.000 | 0.0% |

总用时 3950s
