AULAGE/dache/raspberrypi/grasp/research/worldmodel/results/results_quick.md

# 任务 14 结果（quick，**合成数据**，种子 0）

训练 160 条序列 × 16 步，测试 40 条；每个变体训练 1.8 分钟（full 218 步, noprior 202 步, nogru 218 步, cmdonly 213 步），设备 cpu。

## H1 视觉本体感知：线性探针从隐状态解码真实舵机角（测试集平均绝对误差）

| 方法 | 底座 ° | 升降 cm | 底座：回差 0~1° | 1~2° | 2~3.5° | ≥3.5° | 回差方向识别率 |
|---|---|---|---|---|---|---|---|
| 命令积分（开环） | 1.299 | 0.0855 | 0.641 | 1.009 | 1.505 | 2.036 | 0.0% |
| 方向记忆规则（上一次转动方向 × 常数） | 0.831 | 0.0380 | 0.723 | 0.476 | 0.829 | 1.504 | 92.0% |
| 对照：未训练的同结构模型（随机权重） | 0.831 | 0.0519 | 0.758 | 0.614 | 0.823 | 1.263 | 92.7% |
| 完整模型（GRU 命令历史 + 画面，分离先验） | 0.836 | 0.0523 | 0.774 | 0.612 | 0.838 | 1.249 | 92.4% |
| 无分离先验（槽位自由移动） | 0.835 | 0.0520 | 0.762 | 0.618 | 0.827 | 1.264 | 92.2% |
| 无 GRU（只用当前命令 + 当前画面） | 0.847 | 0.0635 | 0.768 | 0.615 | 0.848 | 1.290 | 91.0% |
| GRU 只看命令历史（不看画面） | 0.822 | 0.0527 | 0.756 | 0.601 | 0.804 | 1.266 | 92.9% |

## H2 自身 / 世界分离：槽位掩膜和真实掩膜的 IoU（测试集）

| 变体 | 爪子最佳 IoU | 物块最佳 IoU | 自动判自身（按 w）的爪子 IoU | 判别正确率（按 w） | 自动判自身（按位移）的爪子 IoU | 判别正确率（按位移） |
|---|---|---|---|---|---|---|
| 完整模型（GRU 命令历史 + 画面，分离先验） | 0.025 | 0.102 | 0.005 | 0.0% | 0.007 | 18.5% |
| 无分离先验（槽位自由移动） | 0.026 | 0.149 | nan | nan% | 0.000 | 0.0% |
| 无 GRU（只用当前命令 + 当前画面） | 0.023 | 0.114 | 0.004 | 0.0% | 0.003 | 7.6% |
| GRU 只看命令历史（不看画面） | 0.036 | 0.123 | 0.013 | 0.0% | 0.005 | 10.4% |

总用时 478s
