AULAGE/dache/docs/cloud_tasks/results/16_看板_手机画中画.png

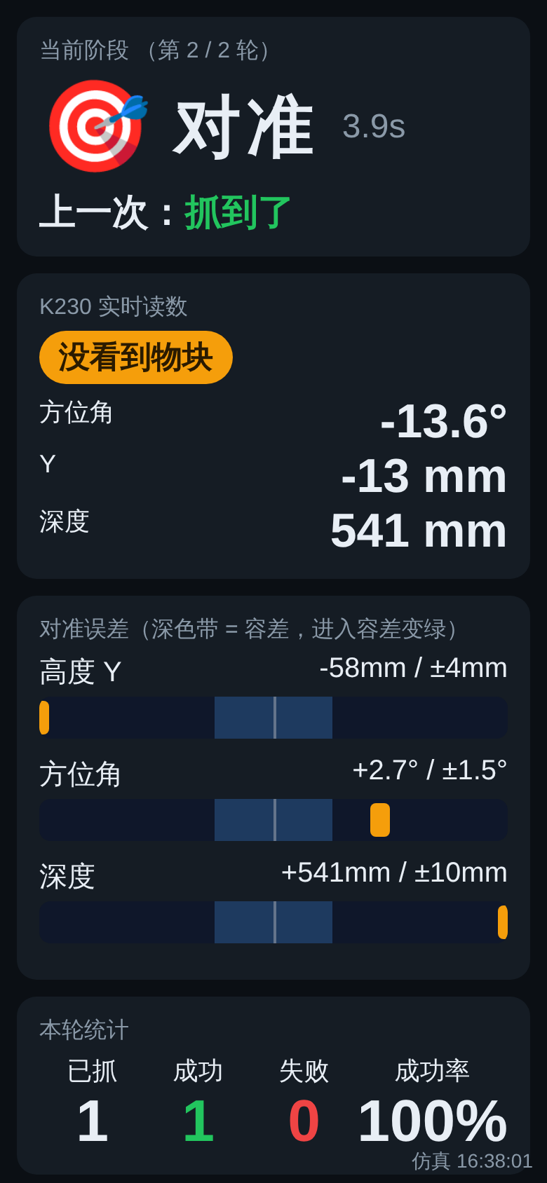
docs/cloud_tasks/results/16_看板_手机画中画.png
