AULAGE/dache/raspberrypi/grasp/research/worldmodel/results/preview.png

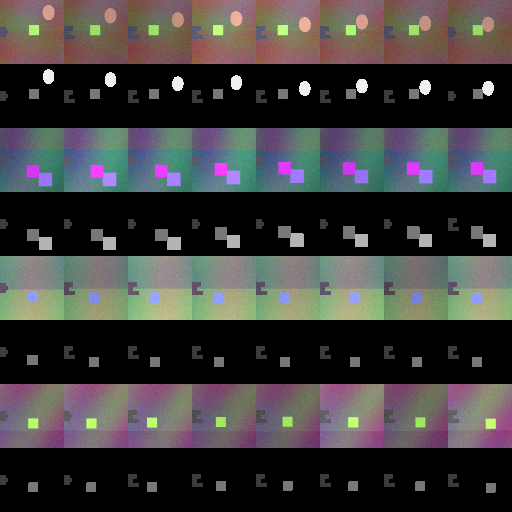
raspberrypi/grasp/research/worldmodel/results/preview.png
