AULAGE/dache/raspberrypi/grasp/research/worldmodel/results/slots_full_cmdonly.png

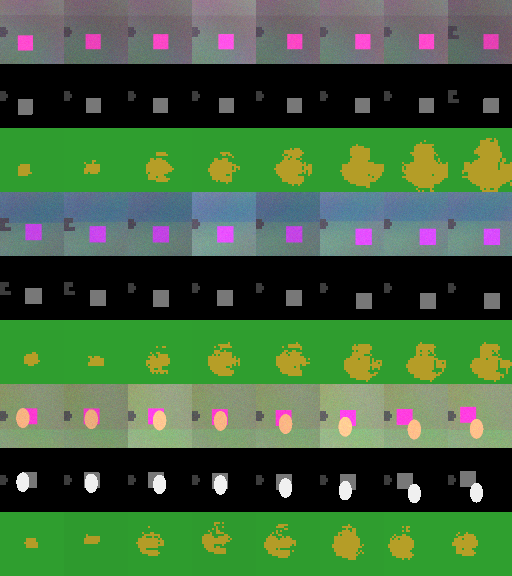
raspberrypi/grasp/research/worldmodel/results/slots_full_cmdonly.png
