AULAGE/dache/raspberrypi/grasp/research/worldmodel/results/slots_full_full.png

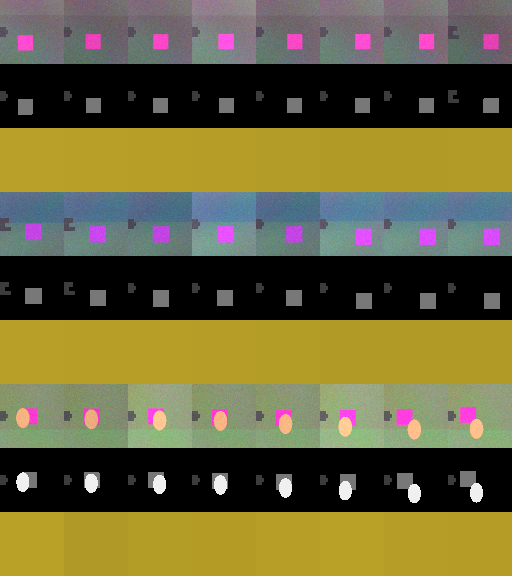
raspberrypi/grasp/research/worldmodel/results/slots_full_full.png
