AULAGE/dache/raspberrypi/grasp/research/worldmodel/results/slots_full_nogru.png

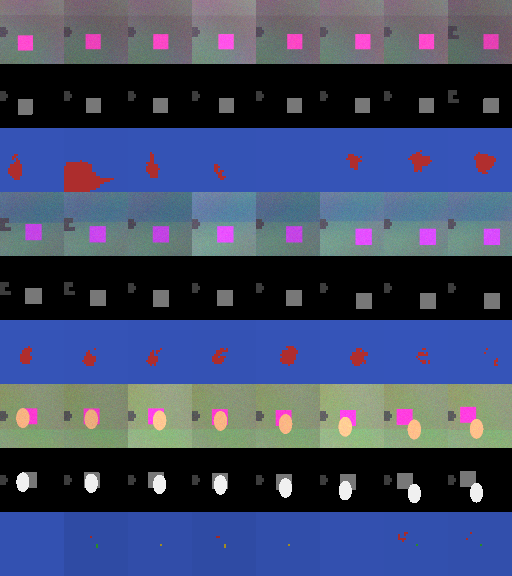
raspberrypi/grasp/research/worldmodel/results/slots_full_nogru.png
