AULAGE/dache/raspberrypi/grasp/research/worldmodel/results/slots_full_noprior.png

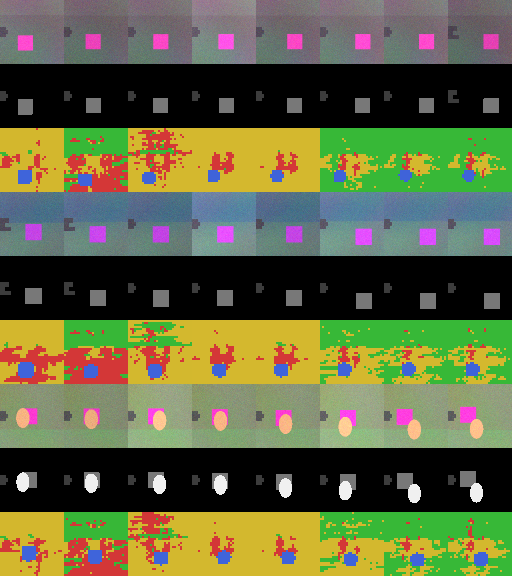
raspberrypi/grasp/research/worldmodel/results/slots_full_noprior.png
