AULAGE/dache/raspberrypi/grasp/research/worldmodel/results/slots_quick_cmdonly.png

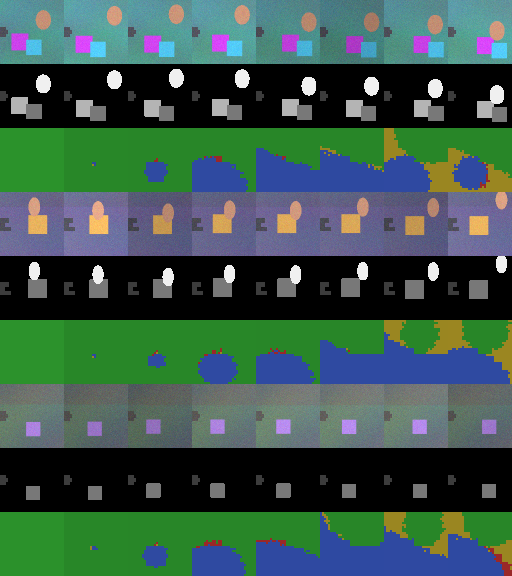
raspberrypi/grasp/research/worldmodel/results/slots_quick_cmdonly.png
