AULAGE/dache/raspberrypi/grasp/research/worldmodel/results/slots_quick_full.png

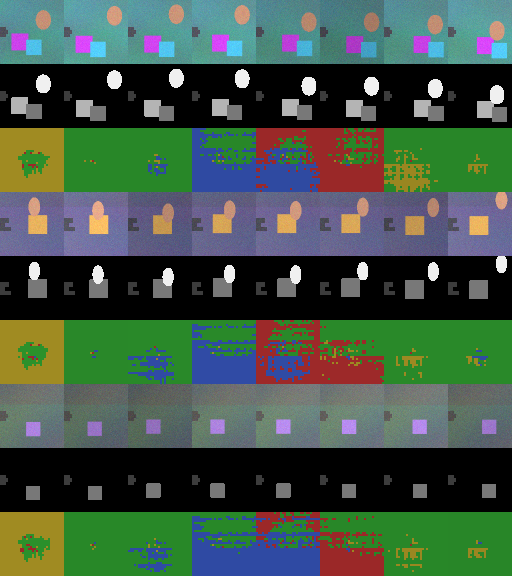
raspberrypi/grasp/research/worldmodel/results/slots_quick_full.png
