AULAGE/dache/raspberrypi/grasp/research/worldmodel/results/slots_quick_nogru.png

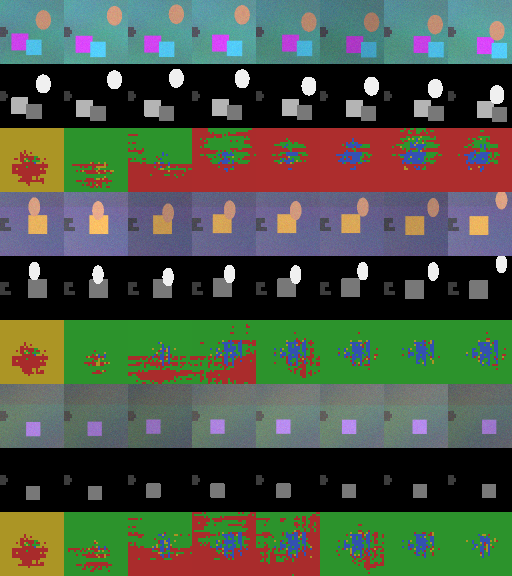
raspberrypi/grasp/research/worldmodel/results/slots_quick_nogru.png
