AULAGE/dache/raspberrypi/grasp/research/worldmodel/results/slots_quick_noprior.png

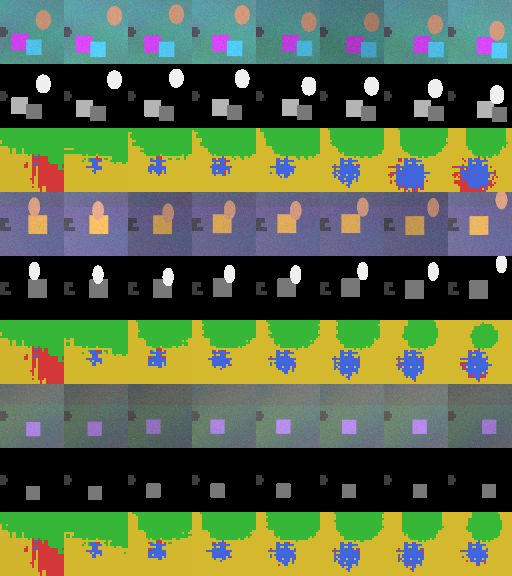
raspberrypi/grasp/research/worldmodel/results/slots_quick_noprior.png
