AULAGE/dache/docs/robotac/templates/图片/感知板面包板调试.jpg

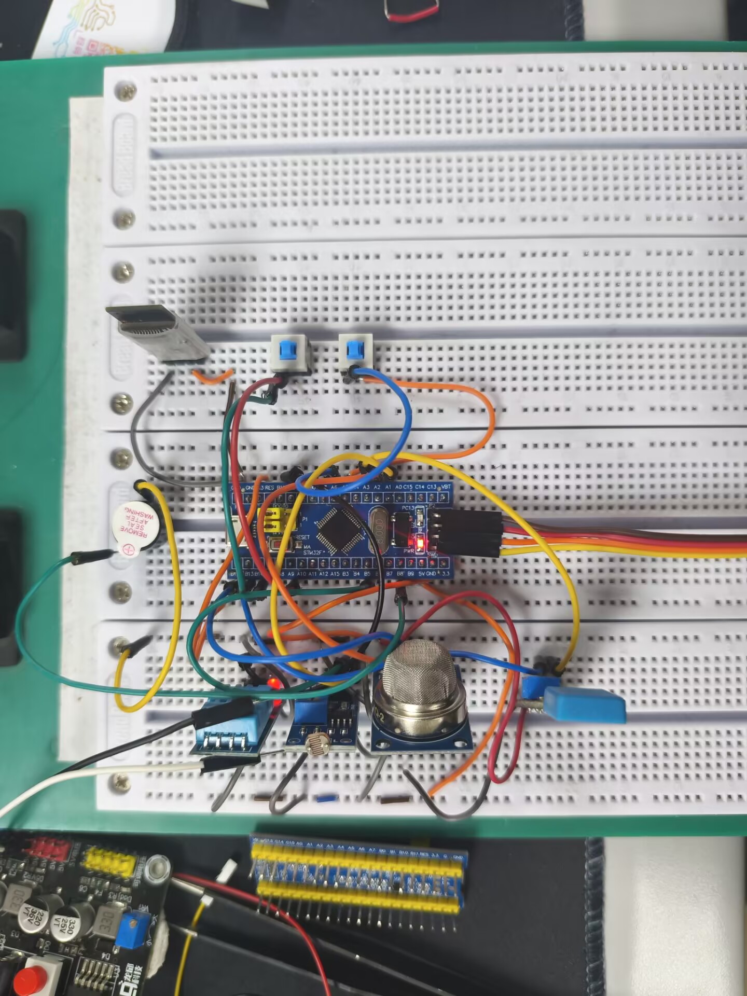
docs/robotac/templates/图片/感知板面包板调试.jpg
