AULAGE/dache/backup_机械臂原版_20261102/main.c

#include "include.h"



int main(void)
{
	uint8 ps_ok = 1;
	SystemInit(); 			 //系统时钟初始化为72M	  SYSCLK_FREQ_72MHz
	InitDelay(72);	     //延时初始化
	NVIC_PriorityGroupConfig(NVIC_PriorityGroup_2);	//设置NVIC中断分组2:2位抢占优先级，2位响应优先级
	InitPWM();
	InitTimer2();//用于产生100us的定时中断
	InitUart1();//用于与PC端进行通信
	InitUart3();//外接模块的串口
	InitADC();
	InitLED();
	InitKey();
	InitBuzzer();
	ps_ok = InitPS2();//PS2游戏手柄接收器初始化
	InitFlash();
	InitMemory();
	InitBusServoCtrl();
	LED = LED_ON;
	BusServoCtrl(1,SERVO_MOVE_TIME_WRITE,500,1000);
	BusServoCtrl(2,SERVO_MOVE_TIME_WRITE,500,1000);
	BusServoCtrl(3,SERVO_MOVE_TIME_WRITE,500,1000);
	BusServoCtrl(4,SERVO_MOVE_TIME_WRITE,500,1000);
	BusServoCtrl(5,SERVO_MOVE_TIME_WRITE,500,1000);
	BusServoCtrl(6,SERVO_MOVE_TIME_WRITE,500,1000);
	while(1)
	{
			BusServoCtrl(1,SERVO_MOVE_TIME_WRITE,500,1000);
	BusServoCtrl(2,SERVO_MOVE_TIME_WRITE,500,1000);
	BusServoCtrl(3,SERVO_MOVE_TIME_WRITE,500,1000);
	BusServoCtrl(4,SERVO_MOVE_TIME_WRITE,500,1000);
	BusServoCtrl(5,SERVO_MOVE_TIME_WRITE,500,1000);
	BusServoCtrl(6,SERVO_MOVE_TIME_WRITE,500,1000);
		TaskRun(ps_ok);
	}
}
