AULAGE/dache/sensor_v2.1/APP/servo/servo.c

#include "servo.h"

void Servo_Init(void)
{
    RCC_APB1PeriphClockCmd(RCC_APB1Periph_TIM3, ENABLE);
    RCC_APB2PeriphClockCmd(SERVO_CLK, ENABLE); 

    /*GPIO初始化*/
    GPIO_InitTypeDef GPIO_InitStructure;
    GPIO_InitStructure.GPIO_Mode = GPIO_Mode_AF_PP;
    GPIO_InitStructure.GPIO_Pin = GPIO_Pin_0; // PB0
    GPIO_InitStructure.GPIO_Speed = GPIO_Speed_50MHz;
    GPIO_Init(GPIOB, &GPIO_InitStructure);

    GPIO_InitStructure.GPIO_Pin = GPIO_Pin_1; // PB1
    GPIO_Init(GPIOB, &GPIO_InitStructure);

    TIM_InternalClockConfig(TIM3);

    TIM_TimeBaseInitTypeDef TIM_TimeBaseInitStructure;
    TIM_TimeBaseInitStructure.TIM_ClockDivision = TIM_CKD_DIV1; // 时钟分频
    TIM_TimeBaseInitStructure.TIM_CounterMode = TIM_CounterMode_Up; // 计数模式
    TIM_TimeBaseInitStructure.TIM_Period = 20000 - 1; // 自动重装ARR 分辨率
    TIM_TimeBaseInitStructure.TIM_Prescaler = 72 - 1; // 预分频PSC
    TIM_TimeBaseInitStructure.TIM_RepetitionCounter = 0;
    TIM_TimeBaseInit(TIM3, &TIM_TimeBaseInitStructure);

    TIM_OCInitTypeDef TIM_OCInitStructure;
    TIM_OCStructInit(&TIM_OCInitStructure); // 给结构体赋予初值

    TIM_OCInitStructure.TIM_OCMode = TIM_OCMode_PWM1;
    TIM_OCInitStructure.TIM_OCPolarity = TIM_OCPolarity_High;
    TIM_OCInitStructure.TIM_OutputState = TIM_OutputState_Enable;
    TIM_OCInitStructure.TIM_Pulse = 0;

    TIM_OC3Init(TIM3, &TIM_OCInitStructure);
    TIM_OC4Init(TIM3, &TIM_OCInitStructure);
    TIM_Cmd(TIM3, ENABLE);
}

void SetAngle_DOWN(float Angle)
{
		TIM_SetCompare3(TIM3,(uint16_t)(Angle / 180 * 2000 + 500));
}

void SetAngle_UP(float Angle)
{
	TIM_SetCompare4(TIM3,(uint16_t)(Angle / 180 * 2000 + 500));
}
