AULAGE/dache/raspberrypi/grasp/task.py

"""
全自动抓取的任务流程（状态机），按"眼在手上"设计：相机装在机械臂腕部

  观察姿态 → 搜索 → 对准（闭环，自适应）→ 抓取 → 抬升确认 → 放置
                ↑__________ 丢失目标 / 抓取失败（最多 MAX_ATTEMPTS 次）

对准时机械臂保持 observe 姿态，只动三样东西：
  y      升降轴（整条机械臂连相机一起上下）
  x_deg  机械臂底座（相机跟着转）；底座转出去太多时，底盘转过去、底座回正
  d      底盘前进 / 后退
"""
import csv
import json
import math
import os
import time

from devices import DeviceError, ManualOverride, Measurement, lerp_pose
from servo import NOISE, build_axes, save_axes


class GraspTask:
    def __init__(self, cfg, clock, cam, lift, arm, chassis, log_dir=None, learn=True, verbose=True,
                 guard=None):
        self.cfg = cfg
        self.guard = guard            # 手柄接管检测（ManualGuard），None = 不检测
        self.can_turn = cfg.USE_CHASSIS and not cfg.CHASSIS_ACKERMANN   # 能不能原地转
        self.clock = clock
        self.cam = cam
        self.lift = lift
        self.arm = arm
        self.chassis = chassis
        self.verbose = verbose
        self.learn = learn
        self.axis_names = ["y", "x_deg", "d"] if cfg.USE_CHASSIS else ["y", "x_deg"]
        self.learn_path = os.path.join(log_dir, cfg.LEARN_FILE) if log_dir else None
        self.axes = build_axes(cfg, self.axis_names, self.learn_path if learn else None)
        self.log_dir = log_dir
        self.episode = 0
        self.base_deg = 0.0
        self.backoff_mm = 0.0            # 任务 18：上次找到目标以后，搜索一共后退了多少（跨多次抓取累计）
        if log_dir:
            os.makedirs(log_dir, exist_ok=True)
        # 任务 09：底座消回差要记住最后一次发给底座的脉宽和转动方向（None / 0 = 不知道）
        self._base_sent = None
        self._base_dir = 0
        self.backlash_moves = 0          # 统计：为消回差多转了几次
        self._probe_mm = 0.0             # 这次伸出的左右试探量（mm，偏右为正）
        self.trim_path = os.path.join(log_dir, cfg.TRIM_LEARN_FILE) if log_dir else None
        self.trim_state = self._load_trim() if cfg.TRIM_LEARN else None
        # ghost 指纹（任务 10）：之前判定为"机械臂自己"的读数
        self.ghost_path = os.path.join(log_dir, cfg.GHOST_FP_FILE) if log_dir else None
        self.ghosts = self._load_ghosts() if cfg.GHOST_FINGERPRINT else []
        # 任务 13：记住发给每个舵机的最后脉宽（ARM_MOVE_SCALE 按脉宽差缩放动作时间用）；
        # 换了机械臂设备对象 / USB 重连过就当作不知道（舵机可能被重新上电回到上电姿态）
        self._arm_known = {}
        self._arm_known_key = None
        self.learn_skipped_reversal = 0   # 统计：LEARN_SAME_DIR_ONLY 跳过了几次换向步
        self._pushed = None               # 这次观察确认发现物块被推开时的 (Δx, Δy, Δd)，否则 None

    # ------------------------------------------------ 工具
    def say(self, *a):
        if self.verbose:
            print(f"[{self.clock.now():8.2f}]", *a)

    def measure(self, n=None):
        """等画面稳定后测量一次（每一步都会经过这里，顺便检查有没有被手柄接管）"""
        if self.guard is not None and self.guard.active:
            raise ManualOverride("手柄已连接，自动抓取暂停")
        self.clock.sleep(self.cfg.SETTLE_S)
        m = self.cam.measure(self.clock.now(), n or self.cfg.SAMPLE_N, self.cfg.MEASURE_TIMEOUT_S)
        # 连心跳都没有 = 串口线断了 / K230 程序停了：不能当成"没看到物块"继续开车乱找
        link_ok = getattr(self.cam, "link_ok", None)
        if m is None and link_ok is not None and not link_ok(2.0):
            raise DeviceError("K230 没有任何数据（连心跳都没有）：检查 K230 串口线和程序")
        if m is not None and self.ghost_match(m):
            return None
        return self.row_depth(m)

    def row_depth(self, m):
        """DEPTH_FROM_ROW：按像素行（y/d）在近/远两个标定点之间插值出深度，代替会跳的 K230 深度"""
        c = self.cfg
        g, gf = c.GOAL, getattr(c, "GOAL_FAR", None)
        if m is None or not c.DEPTH_FROM_ROW or c.USE_CHASSIS or not gf:
            return m
        rn, rf = g["y"] / g["d"], gf["y"] / gf["d"]
        if abs(rn - rf) < 0.02:
            return m
        r = m.ry if m.ry is not None else m.y / max(m.d, 1.0)
        rx = m.rx if m.rx is not None else m.x / max(m.d, 1.0)
        d_row = g["d"] + (rn - r) / (rn - rf) * (gf["d"] - g["d"])
        if d_row < 50 or abs(d_row - m.d) > c.DEPTH_ROW_MAX_JUMP_MM:
            return m
        return Measurement(rx * d_row, r * d_row, d_row, m.n, r, rx)

    # ------------------------------------------------ ghost 指纹（任务 10）
    def _load_ghosts(self):
        if not self.ghost_path or not os.path.exists(self.ghost_path):
            return []
        try:
            with open(self.ghost_path, encoding="utf-8") as f:
                data = json.load(f)
            out = []
            for g in data.get("ghosts", []):
                out.append({"x_deg": float(g["x_deg"]), "y": float(g["y"]), "d": float(g["d"]),
                            "hits": int(g.get("hits", 1)), "first": g.get("first", ""),
                            "last": g.get("last", ""), "seen": int(g.get("seen", 0))})
            return out
        except (OSError, ValueError, KeyError, TypeError, AttributeError) as e:
            print(f"ghost 指纹文件 {self.ghost_path} 读不了（{e}），忽略它")
            return []

    def _save_ghosts(self):
        if not self.ghost_path:
            return
        tmp = self.ghost_path + ".tmp"
        with open(tmp, "w", encoding="utf-8") as f:
            json.dump({"note": "align 判定为机械臂自己（ghost）时的 K230 读数；误记了删掉这个文件或其中一项",
                       "tol": self.cfg.GHOST_FP_TOL, "ghosts": self.ghosts}, f, ensure_ascii=False, indent=1)
        os.replace(tmp, self.ghost_path)

    def _ghost_near(self, m):
        """和读数 m 最接近（各轴都在容差内）的指纹，没有返回 (None, None)"""
        tol = self.cfg.GHOST_FP_TOL
        best, best_v = None, None
        for i, g in enumerate(self.ghosts):
            r = max(abs(m.x_deg - g["x_deg"]) / tol["x_deg"], abs(m.y - g["y"]) / tol["y"],
                    abs(m.d - g["d"]) / tol["d"])
            if r <= 1.0 and (best_v is None or r < best_v):
                best, best_v = i, r
        return best, best_v

    def record_ghost(self, m):
        """align 判定 ghost 时调用：把读数记成指纹（和已有指纹接近就合并、命中次数 +1）"""
        c = self.cfg
        if not c.GHOST_FINGERPRINT or m is None:
            return None
        now = time.strftime("%Y-%m-%d %H:%M:%S")
        i, _ = self._ghost_near(m)
        if i is None:
            if len(self.ghosts) >= max(1, c.GHOST_FP_MAX):
                self.ghosts.sort(key=lambda g: g["last"])
                self.ghosts.pop(0)
            self.ghosts.append({"x_deg": round(m.x_deg, 2), "y": round(m.y, 1), "d": round(m.d, 1),
                                "hits": 1, "first": now, "last": now, "seen": 0})
            g = self.ghosts[-1]
        else:
            g = self.ghosts[i]
            k = g["hits"]
            for key, v in (("x_deg", m.x_deg), ("y", m.y), ("d", m.d)):     # 平均一下，指纹更准
                g[key] = round((g[key] * k + v) / (k + 1), 2)
            g["hits"] = k + 1
            g["last"] = now
        self.say(f"记录 ghost 指纹：x={g['x_deg']:+.1f}° y={g['y']:+.0f}mm d={g['d']:.0f}mm（第 {g['hits']} 次）"
                 + (f" → {self.ghost_path}" if self.ghost_path else ""))
        try:
            self._save_ghosts()
        except OSError as e:
            self.say(f"ghost 指纹保存失败：{e}")
        return g

    def ghost_match(self, m):
        """读数 m 是不是之前记录的假目标（GHOST_FINGERPRINT 关掉时永远 False）"""
        c = self.cfg
        if not c.GHOST_FINGERPRINT or m is None or not self.ghosts:
            return False
        i, _ = self._ghost_near(m)
        if i is None or self.ghosts[i]["hits"] < c.GHOST_FP_MIN_HITS:
            return False
        g = self.ghosts[i]
        g["seen"] = g.get("seen", 0) + 1
        self.say(f"看到的是之前记录的假目标（ghost 指纹 #{i + 1}：x={g['x_deg']:+.1f}° y={g['y']:+.0f}mm "
                 f"d={g['d']:.0f}mm，记录于 {g['first']}），当作没看到。"
                 f"如果这其实是真物块，删掉 {self.ghost_path or 'ghosts.json'}")
        return True

    def in_tol(self, e):
        return all(abs(e[n]) <= self.cfg.TOL[n] for n in self.axis_names)

    def _append_csv(self, name, row):
        if not self.log_dir:
            return
        path = os.path.join(self.log_dir, name)
        new = not os.path.exists(path)
        if not new:
            # 列变了（程序升级加了新列）：旧文件改名留档，开一个新文件，否则新行会和旧表头错位
            with open(path, newline="", encoding="utf-8") as f:
                header = next(csv.reader(f), [])
            if header != list(row.keys()):
                base, ext = os.path.splitext(path)
                os.replace(path, f"{base}_{time.strftime('%Y%m%d_%H%M%S')}{ext}")
                new = True
        with open(path, "a", newline="", encoding="utf-8") as f:
            w = csv.DictWriter(f, fieldnames=list(row.keys()))
            if new:
                w.writeheader()
            w.writerow(row)

    # ------------------------------------------------ 机械臂
    def base_pulse(self, deg=None):
        c = self.cfg
        deg = self.base_deg if deg is None else deg
        return int(round(c.BASE_CENTER + c.BASE_DIR * deg * c.BASE_US_PER_DEG))

    def set_base(self, deg):
        c = self.cfg
        deg = max(-c.BASE_LIMIT_DEG, min(c.BASE_LIMIT_DEG, deg))
        ms = int(max(150, abs(deg - self.base_deg) * c.BASE_MS_PER_DEG))
        self._arm({c.BASE_ID: self.base_pulse(deg)}, ms)
        self.base_deg = deg
        return deg

    # ---- 任务 13：动作时间按脉宽差缩放
    def _arm_state(self):
        """已知的舵机脉宽；机械臂对象换了或重连过就清空"""
        key = (id(self.arm), getattr(self.arm, "reconnects", 0))
        if key != self._arm_known_key:
            self._arm_known = {}
            self._arm_known_key = key
        return self._arm_known

    def _scaled_ms(self, pulses, ms):
        """ms = clamp(Δ最大 × ARM_MS_PER_US, ARM_MIN_MS, 原值)；有舵机位置不知道就用原值"""
        c = self.cfg
        known = self._arm_state()
        if any(int(k) not in known for k in pulses):
            return ms
        dmax = max(abs(int(max(500, min(2500, v))) - known[int(k)]) for k, v in pulses.items())
        return int(min(ms, max(c.ARM_MIN_MS, dmax * c.ARM_MS_PER_US)))

    def _send(self, pulses, ms, scale=True):
        """所有机械臂指令都从这里发；ARM_MOVE_SCALE 关闭时和直接 self.arm.move 完全一样"""
        if self.cfg.ARM_MOVE_SCALE and scale:
            ms = self._scaled_ms(pulses, ms)
        self.arm.move(pulses, ms)
        known = self._arm_state()
        known.update({int(k): int(max(500, min(2500, v))) for k, v in pulses.items()})

    def _arm(self, pulses, ms, precise=True, scale=True):
        """
        发机械臂指令。带底座（6 号）时记下脉宽和转动方向；打开 BASE_BACKLASH_DEG 后，
        precise 的动作如果最后一段不是从 BASE_APPROACH_DIR 那边过来的，先多转 BASE_BACKLASH_DEG 再转回来。
        BASE_BACKLASH_DEG = 0 时和直接 self.arm.move 完全一样。
        """
        c = self.cfg
        p = pulses.get(c.BASE_ID)
        if p is None:
            self._send(pulses, ms, scale)
            return
        p = int(round(p))
        a = c.BASE_APPROACH_DIR * c.BASE_DIR          # 逼近方向（脉宽增大 = +1）
        prev = self._base_sent
        move = 0 if prev is None else (p > prev) - (p < prev)
        bl = c.BASE_BACKLASH_DEG
        if precise and bl > 0 and not (move == a or (move == 0 and self._base_dir == a)):
            over = int(round(p - a * bl * c.BASE_US_PER_DEG))      # 先转过头（逼近方向的反方向）
            dist = abs(over - (prev if prev is not None else p)) / c.BASE_US_PER_DEG
            self._send({c.BASE_ID: over}, int(max(150, ms if len(pulses) == 1 else 0,
                                                  dist * c.BASE_MS_PER_DEG)), scale)
            self.backlash_moves += 1
            move = a
            if len(pulses) == 1:              # 只动底座：大段已经走完，回来只有 BASE_BACKLASH_DEG 这么远
                ms = int(max(150, bl * c.BASE_MS_PER_DEG))
        self._send(pulses, ms, scale)
        if move:
            self._base_dir = move
        self._base_sent = p

    def base_after_move(self, m, base_deg, s_mm, dpsi_right_deg):
        """
        几何前馈：车走了 s_mm、车头右转 dpsi_right_deg 之后，底座要转到多少度，相机才正对物块。
        坐标（车体系）：x 向前、y 向左；底座转轴在车的转动中心前方 PIVOT_FWD_MM，
        相机在转轴外 R_CAM_MM，朝向沿半径向外（底座右转 = 朝向角减小）。
        """
        c = self.cfg
        R, pv = c.R_CAM_MM, c.PIVOT_FWD_MM
        phi = -math.radians(base_deg)
        ux, uy = math.cos(phi), math.sin(phi)            # 相机朝向
        cx, cy = pv + R * ux, R * uy                     # 相机位置
        tx = cx + m.d * ux + m.x * uy                    # 物块位置 = 相机 + 深度·朝向 − x右·左方向
        ty = cy + m.d * uy - m.x * ux
        psi = -math.radians(dpsi_right_deg)              # 车头左转为正
        px, py = s_mm * math.cos(psi / 2), s_mm * math.sin(psi / 2)   # 沿圆弧走：近似按弧中点朝向
        dx, dy = tx - px, ty - py
        qx = dx * math.cos(psi) + dy * math.sin(psi) - pv               # 物块在新车体系里、相对底座转轴
        qy = -dx * math.sin(psi) + dy * math.cos(psi)
        dist = math.hypot(qx, qy)
        # 让物块出现在 GOAL 的方位角上：迭代修正（相机在半径上，偏 1° 方位角 ≈ 1 + R/深度 度）
        want = -math.radians(c.GOAL["x_deg"])            # 左为正
        ph = math.atan2(qy, qx)
        for _ in range(5):
            ex, ey = qx - R * math.cos(ph), qy - R * math.sin(ph)
            bearing = math.atan2(-ex * math.sin(ph) + ey * math.cos(ph), ex * math.cos(ph) + ey * math.sin(ph))
            ph -= (bearing - want) / -(1.0 + R / max(dist - R, 50.0))
        return -math.degrees(ph)

    def go_observe(self, base_deg=None):
        c = self.cfg
        if base_deg is not None:
            self.base_deg = max(-c.BASE_LIMIT_DEG, min(c.BASE_LIMIT_DEG, base_deg))
        self._arm({**c.POSES["observe"], c.BASE_ID: self.base_pulse(), c.CLAW_ID: c.observe_claw()},
                  c.ARM_MOVE_MS)

    # ------------------------------------------------ 搜索
    def search(self):
        """
        每个高度：先只转底座扫前方（最快）→ 底盘掉头扫后方（仅差速底盘）；没找到再换高度
        """
        c = self.cfg
        if c.SEARCH_LOOK_FIRST:
            # 先原地看一眼（不动升降轴、不转底座）：物块往往就在标定时的位置附近
            m = self.measure()
            if m:                        # 原地这一眼一律复核：避免把一闪而过的误识别当真
                m = self.confirm_target(m)
            if m:
                self.say("搜索：原地就看到了目标")
                self.backoff_mm = 0.0
                return m
        turns = [0] + (list(c.SEARCH_CHASSIS_TURNS) if self.can_turn else [])
        bases = list(c.SEARCH_BASE_DEG if c.USE_CHASSIS else c.SEARCH_BASE_DEG_NEAR)
        heights = c.SEARCH_LIFT_CM if c.USE_CHASSIS else c.SEARCH_LIFT_CM_NEAR
        rounds = 2 if (c.USE_CHASSIS and c.SEARCH_BACKOFF_MM) else 1
        turned = 0.0
        for r in range(rounds):
            if r:
                cap = c.SEARCH_BACKOFF_MAX_MM
                if cap and self.backoff_mm + c.SEARCH_BACKOFF_MM > cap:
                    # 连续好几次都没找到（例如物块都抓完了）：main.py 一直循环，每次都退 250mm 会一直倒下去
                    self.say(f"搜索：没找到；找到目标以前已经累计后退 {self.backoff_mm:.0f}mm，"
                             f"不再后退（上限 SEARCH_BACKOFF_MAX_MM={cap}）")
                    break
                self.backoff_mm += c.SEARCH_BACKOFF_MM
                self.say(f"搜索：没找到，后退 {c.SEARCH_BACKOFF_MM}mm 再搜")
                self.set_base(0)
                back = (turned + 180.0) % 360.0 - 180.0      # 转回原方向，走最短的一边
                if abs(back) > 1 and self.can_turn:
                    self.chassis.turn(-back)
                turned = 0.0
                self.chassis.forward(-c.SEARCH_BACKOFF_MM)
            for h in heights:
                self.lift.move_to(h)
                for t in turns:
                    if t:
                        self.set_base(0)
                        self.chassis.turn(t)
                        turned += t
                    for b in bases:
                        self.set_base(b)
                        m = self.measure()
                        if m and (c.SEARCH_CONFIRM or (c.USE_CHASSIS and c.SEARCH_CONFIRM_CHASSIS)):
                            m = self.confirm_target(m)
                        if m:
                            self.say(f"搜索：找到目标（高度 {h}cm，底座 {b:+.0f}°）")
                            self.backoff_mm = 0.0
                            return m
                    bases.reverse()          # 下一轮反向扫，少转一大圈
        return None

    def confirm_target(self, m):
        """
        误识别过滤（SEARCH_CONFIRM）：搜索时第一次看到目标，原地再测 1~2 次，位置一致才算真物块。
        K230 偶尔把别的东西认成物块，但一般只持续几帧；真物块不动，第二次测的位置应该差不多。
        """
        c = self.cfg
        for _ in range(2):
            m2 = self.measure()
            if m2 is None:
                continue
            same = (abs(m2.d - m.d) <= max(c.CONFIRM_D_MM, c.CONFIRM_D_FRAC * m.d)
                    and abs(m2.x_deg - m.x_deg) <= c.CONFIRM_X_DEG
                    and abs(m2.y - m.y) <= max(c.CONFIRM_D_MM, c.CONFIRM_D_FRAC * m.d))
            if same:
                return m2
            m = m2                       # 换成新看到的，再确认一次
        self.say("搜索：目标没有复现（可能是误识别），继续搜")
        return None

    # ------------------------------------------------ 对准
    def align(self, m):
        """闭环对准。返回 (是否对准, 最后一次测量, 用了几步)"""
        c = self.cfg
        self._abort = None
        strikes = {"y": 0, "x_deg": 0, "d": 0}  # 连续几次"动了但读数几乎没变"
        for step in range(c.MAX_ALIGN_STEPS):
            if m is None:
                self.say("对准：目标丢失")
                return False, None, step
            goal = self.goal_for(m)
            e = m.err(goal)
            # 升降轴已经在最低（或最高）点、还想往外走一点：误差在爪子能兜住的范围内就算对准了高度
            # （地上的物块只有升降轴在 0cm 时才够得着，读数稍有波动就会想"再往下一点"）
            pos0 = getattr(self.lift, "pos", None)
            if pos0 is not None and abs(e["y"]) <= c.LIFT_LIMIT_SLACK_MM and (
                    (pos0 <= 0.05 and e["y"] > 0) or (pos0 >= c.LIFT_MAX_CM - 0.05 and e["y"] < 0)):
                if abs(e["y"]) > c.TOL["y"]:
                    self.say(f"对准：升降轴已到{'最低' if e['y'] > 0 else '最高'}，剩余 y={e['y']:+.0f}mm 在容差"
                             f" {c.LIFT_LIMIT_SLACK_MM:.0f}mm 内，按已对准处理")
                e = dict(e, y=0.0)
            if self.in_tol(e):
                return True, m, step

            # 已知的几何系数：底座转动时相机绕转轴走一段弧，偏角变化比转角大
            s_x = 1.0 + c.R_CAM_MM / max(m.d, 50.0)
            s_d = max(0.2, math.cos(math.radians(self.base_deg)))
            u_y = self.axes["y"].command(e["y"]) if abs(e["y"]) > c.TOL["y"] else 0.0
            u_x = self.axes["x_deg"].command(e["x_deg"], s_x) if abs(e["x_deg"]) > c.TOL["x_deg"] else 0.0
            if c.BASE_MIN_STEP_DEG > 0 and abs(e["x_deg"]) > c.TOL["x_deg"]:
                u_x = self._min_base_step(u_x, e["x_deg"], s_x)
            u_d = 0.0
            if c.USE_CHASSIS and abs(e["d"]) > c.TOL["d"]:
                u_d = self.axes["d"].command(e["d"], s_d)

            base_old = self.base_deg
            moved = 0.0                     # 底盘这一步实际走了多少（mm，里程计）
            base_want = base_old + u_x
            base_new = max(-c.BASE_LIMIT_DEG, min(c.BASE_LIMIT_DEG, base_want))
            u_x = base_new - base_old
            recenter = c.USE_CHASSIS and abs(base_new) > c.BASE_RECENTER_DEG
            if self.can_turn:
                # 差速底盘：底座偏得多就原地转过去、底座回正；偏的时候不前进（否则斜着走）
                if recenter or abs(e["x_deg"]) > 10:
                    u_d = 0.0
            else:
                # 阿克曼底盘：不能原地转，只能在前进的同时把车头往底座的方向拐（见下面 drive）
                if (c.BASE_LIMIT_BACKUP_MM > 0 and c.USE_CHASSIS and not u_d
                        and abs(base_want) > c.BASE_LIMIT_DEG and abs(e["x_deg"]) > c.TOL["x_deg"]):
                    # 底座已经转到头、深度又刚好：原来会"没法更好"直接去抓（必然抓空）。
                    # 改成后退一段、同时把车头往物块方向拐，下一步再往前对深度
                    u_d = -c.BASE_LIMIT_BACKUP_MM
                    self.say(f"对准：底座到极限 {base_new:+.0f}° 还差 {e['x_deg']:+.1f}°，后退并转车头")
                recenter = recenter and bool(u_d)

            if not (u_y or u_x or u_d or recenter):
                return True, m, step       # 剩下的误差小于最小动作，没法更好了

            self.say("对准 #%d  误差 x=%+.1f° y=%+.1fmm d=%+.0fmm  底座 %+.1f° → %s" % (
                step + 1, e["x_deg"], e["y"], e.get("d", 0.0), base_old,
                " ".join(s for s in [
                    f"升降{u_y:+.2f}cm" if u_y else "",
                    f"底座{u_x:+.1f}°" if u_x else "",
                    f"前进{u_d:+.0f}mm" if u_d else "",
                    f"车头往底座方向拐" if recenter else ""] if s)))

            # 升降轴已经到头、还要往外走：再怎么调也够不着这个高度，别在原地来回试
            pos = getattr(self.lift, "pos", None)
            if u_y and pos is not None and abs(e["y"]) > 2 * c.TOL["y"] and (
                    (u_y < 0 and pos <= 0.05) or (u_y > 0 and pos >= c.LIFT_MAX_CM - 0.05)):
                self.say(f"对准：升降轴已经到{'最低' if u_y < 0 else '最高'}（{pos:.1f}cm），"
                         f"还差 y={e['y']:+.0f}mm，这个高度够不着")
                self._abort = "lift_limit"
                return False, m, step

            # 执行：升降轴和底盘 / 底座同时动
            dir0 = self._base_dir                # 任务 13：这一步之前底座最后一次转动的方向
            if u_y:
                self.lift.start_move_by(u_y)
            if recenter and self.can_turn:
                self.chassis.turn(base_new)
                self.set_base(0)
            elif u_d:
                # 边走边转；走完按实际里程 + 转角做几何前馈，直接算出底座该转到哪（含平移视差）
                moved, dpsi = self.chassis.drive(u_d, base_new if recenter else 0.0)
                if c.GEOM_FEEDFORWARD:
                    target = self.base_after_move(m, base_old, moved, dpsi)
                    target = max(-c.BASE_LIMIT_DEG, min(c.BASE_LIMIT_DEG, target))
                else:
                    target = base_new - dpsi
                self.set_base(target)
                u_x = target - base_old
                recenter = abs(dpsi) > 0.5
            elif u_x:
                self.set_base(base_new)
            if u_y:
                self.lift.wait_move()

            # 离目标还远时少取几帧（快），快对准了再取足帧数（准）
            far = any(abs(e[k]) > 4 * c.TOL[k] for k in self.axis_names)
            m2 = self.measure(c.SAMPLE_N_FAR if far else None)

            if m2 is not None and c.CHASSIS_JUMP_CHECK and abs(moved) > 0:
                # 任务 18：底盘走完以后，深度变化和里程对不上（例如往前走了 287mm，深度反而大了 153mm）→
                # 多半是误识别 / 跟踪器换了目标。原来直接照着新读数再开一大步，仿真里开过了物块（会撞平台）。
                # 再确认一次：确认不了就当丢失，回去重新搜索
                want = e["d"] + self.axes["d"].j * math.cos(math.radians(base_old)) * moved
                got = m2.err(goal)["d"]
                if abs(got - want) > max(c.CHASSIS_JUMP_D_MM, 0.5 * abs(moved)):
                    self.say(f"对准：底盘走了 {moved:+.0f}mm，深度误差应约 {want:+.0f}mm，读到 {got:+.0f}mm，"
                             f"对不上（可能是误识别），再确认一次")
                    m2 = self.confirm_target(m2)

            if m2 is not None and c.GHOST_CHECK:
                e2 = m2.err(goal)
                checks = []
                if u_y:
                    checks.append(("y", self.axes["y"].j * u_y, e2["y"] - e["y"], max(6.0, 3 * NOISE["y"])))
                if u_x and not recenter and not u_d:
                    checks.append(("x_deg", self.axes["x_deg"].j * s_x * u_x, e2["x_deg"] - e["x_deg"], 1.5))
                if u_d and c.GHOST_CHECK_D:
                    # 任务 18：底盘走了一段、深度读数却几乎不变 → 也是 ghost（原来开车时不查，
                    # 爪子被当成物块时底盘会一步步一直开，仿真 25 步走了 5m）。按实际里程预测，
                    # 底座偏得多时深度本来就变得少（cos），预测量小于阈值就不查
                    pred = self.axes["d"].j * math.cos(math.radians(base_old)) * moved
                    checks.append(("d", pred, e2["d"] - e["d"], max(30.0, 3 * NOISE["d"])))
                for ax, pred, got, thresh in checks:
                    if abs(pred) >= thresh:
                        strikes[ax] = strikes[ax] + 1 if abs(got) < 0.3 * abs(pred) else 0
                if max(strikes.values()) >= 2:
                    what = "升降轴" if strikes["y"] >= 2 else ("底座" if strikes["x_deg"] >= 2 else "底盘")
                    self.say(f"对准：{what}动了两次，物块的读数几乎没变 → K230 识别到的很可能是机械臂自己"
                             f"（例如爪子），停止。请在 IDE 画面里看识别框框在哪")
                    self._abort = "ghost"
                    self.record_ghost(m2)
                    return False, m2, step + 1

            if m2 is not None and self.learn:
                e2 = m2.err(goal)
                # 只学习没有被别的动作干扰的轴
                if u_y:
                    self.axes["y"].learn(u_y, e["y"], e2["y"])
                if u_x and not recenter and not u_d:
                    if c.LEARN_SAME_DIR_ONLY and not (dir0 and self._base_dir == dir0):
                        self.learn_skipped_reversal += 1     # 换向（或之前方向未知）：含回差，不学
                    else:
                        self.axes["x_deg"].learn(u_x, e["x_deg"], e2["x_deg"], s_x)
                if u_d and not u_x and not recenter:
                    self.axes["d"].learn(u_d, e["d"], e2["d"], s_d)

            self._append_csv("steps.csv", {
                "episode": self.episode, "step": step + 1, "base_deg": round(base_old, 1),
                "lift_cm": None if pos is None else round(pos, 2),
                **{f"e_{n}": round(e[n], 2) for n in self.axis_names},
                "u_y": round(u_y, 3), "u_x": round(u_x, 2), "u_d": round(u_d, 1), "recenter": int(recenter),
                **{f"J_{n}": round(self.axes[n].j, 4) for n in self.axis_names}})
            m = m2
        return False, m, c.MAX_ALIGN_STEPS

    def _min_base_step(self, u_x, ex, s_x):
        """
        底座最小有效步长（BASE_MIN_STEP_DEG）：小角度指令会被舵机死区 / 回差吃掉，步子太小就放大到这个值；
        但最多放大到"预测误差 = 反方向 0.9 倍容差"，不会冲出容差另一边造成来回摆
        """
        c = self.cfg
        g = abs(self.axes["x_deg"].j * s_x)                    # 底座转 1°，方位角变多少度
        sign = -1.0 if ex * self.axes["x_deg"].j * s_x > 0 else 1.0
        cap = (abs(ex) + 0.9 * c.TOL["x_deg"]) / max(g, 1e-6)
        want = min(c.BASE_MIN_STEP_DEG, cap, c.AXES["x_deg"]["max"])
        return sign * want if abs(u_x) < want else u_x

    # ------------------------------------------------ 任务 09：落点微调（试探 + 学习）
    def _trim_edges(self):
        c = self.cfg
        if c.TRIM_LEARN_EDGES:
            return sorted(float(x) for x in c.TRIM_LEARN_EDGES)
        lo, hi = sorted((c.REACH_NEAR_D, c.REACH_FAR_D))
        return [round(lo + (hi - lo) / 3.0, 1), round(lo + 2 * (hi - lo) / 3.0, 1)]

    def _trim_seg(self, d):
        """物块深度在第几段（0 = 近）"""
        return sum(1 for e in self._trim_edges() if d >= e)

    def _new_trim_state(self):
        n = len(self._trim_edges()) + 1
        return {"edges": self._trim_edges(), "probe_first": -1,
                "segments": [{"trim_deg": 0.0, "direct_ok": 0, "probe_ok_left": 0, "probe_ok_right": 0,
                              "probe_ok_mm": [], "failed": 0} for _ in range(n)]}

    def _load_trim(self):
        st = None
        if self.trim_path and os.path.exists(self.trim_path):
            try:
                with open(self.trim_path, encoding="utf-8") as f:
                    st = json.load(f)
            except (OSError, ValueError):
                st = None
        if st and st.get("edges") != self._trim_edges():
            self.say(f"学到的落点微调是按旧的深度分段 {st.get('edges')} 学的，现在分段是 {self._trim_edges()}，重新开始学")
            st = None
        return st or self._new_trim_state()

    def _save_trim(self):
        if not self.trim_path or self.trim_state is None:
            return
        tmp = self.trim_path + ".tmp"
        with open(tmp, "w", encoding="utf-8") as f:
            json.dump(self.trim_state, f, ensure_ascii=False, indent=2)
        os.replace(tmp, self.trim_path)

    def learned_trim(self, d):
        """这个深度学到的微调（度）；没打开 TRIM_LEARN 就是 0"""
        if self.trim_state is None:
            return 0.0
        return self.trim_state["segments"][self._trim_seg(d)]["trim_deg"]

    def _probe_for(self, fails):
        """第 fails 次失败之后那一次伸出的试探量（mm，偏右为正）：∓p、±p、∓2p ……"""
        c = self.cfg
        p = c.GRASP_PROBE_MM
        if p <= 0 or fails <= 0:
            return 0.0
        if c.GRASP_PROBE_FIRST == "left":
            first = -1
        elif c.GRASP_PROBE_FIRST == "right":
            first = 1
        else:
            first = self.trim_state["probe_first"] if self.trim_state else getattr(self, "_probe_first", -1)
        sign = first if fails % 2 == 1 else -first
        return sign * p * ((fails + 1) // 2)

    def _flip_probe_first(self):
        if self.trim_state is not None:
            self.trim_state["probe_first"] = -self.trim_state["probe_first"]
        else:
            self._probe_first = -getattr(self, "_probe_first", -1)

    def _learn_trim(self, d, probe_mm, probe_deg, ok):
        """一次抓取（一个物块）结束后更新学到的微调"""
        c = self.cfg
        if self.trim_state is None:
            return
        seg = self.trim_state["segments"][self._trim_seg(d)]
        if not ok:
            seg["failed"] += 1                   # 连续失败：说明不了偏差往哪边，只记录
        elif not probe_mm:
            seg["direct_ok"] += 1                # 直接成功：现在的微调就合适，不改
        elif self.learn:
            old = seg["trim_deg"]
            seg["trim_deg"] = round(max(-c.TRIM_MAX_DEG, min(c.TRIM_MAX_DEG, old + c.TRIM_LEARN_RATE * probe_deg)), 3)
            seg["probe_ok_left" if probe_mm < 0 else "probe_ok_right"] += 1
            seg["probe_ok_mm"] = (seg["probe_ok_mm"] + [probe_mm])[-20:]
            self.say(f"学习落点：深度 {d:.0f}mm 那一段，试探 {probe_mm:+.0f}mm 抓到了 → 微调 {old:+.2f}° → "
                     f"{seg['trim_deg']:+.2f}°")
        self._save_trim()

    # ------------------------------------------------ 抓取
    def reach_pose(self, d):
        """按深度插值伸出姿态：标了 reach_mid（和 REACH_MID_D）就近-中-远分段，否则近-远两点（原行为）"""
        c = self.cfg
        near, far = c.POSES["reach_near"], c.POSES["reach_far"]
        t = (d - c.REACH_NEAR_D) / (c.REACH_FAR_D - c.REACH_NEAR_D)
        mid, dm = c.POSES.get("reach_mid"), getattr(c, "REACH_MID_D", None)
        if mid and dm is not None and min(c.REACH_NEAR_D, c.REACH_FAR_D) < dm < max(c.REACH_NEAR_D, c.REACH_FAR_D):
            tm = (dm - c.REACH_NEAR_D) / (c.REACH_FAR_D - c.REACH_NEAR_D)
            if t <= tm:
                return lerp_pose(near, mid, t / tm), t
            return lerp_pose(mid, far, (t - tm) / (1.0 - tm)), t
        return lerp_pose(near, far, t), t

    def grasp(self, m):
        """伸出 → 合爪 → 抬升；返回是否确认抓到"""
        c = self.cfg
        self._grasp_ref = m
        reach, t = self.reach_pose(m.d)
        if not 0 <= t <= 1 and not c.REACH_RANGE_OK:
            raise DeviceError(f"物块深度 {m.d:.0f}mm 超出机械臂范围")
        # 左右微调：对准后爪子系统性偏左/偏右时，伸出前让底座多转一点（calib.py trim 设置）
        trim = c.GRASP_BASE_TRIM_DEG
        # 任务 09：再加上 这个深度学到的微调 + 失败重试时的左右试探（默认都是 0）
        learned = self.learned_trim(m.d)
        probe_mm = self._probe_mm
        probe_deg = math.degrees(math.atan2(probe_mm, max(m.d + c.R_CAM_MM, 50.0))) if probe_mm else 0.0
        self._probe_deg = probe_deg
        total = trim + learned + probe_deg
        bp = self.base_pulse(max(-c.BASE_LIMIT_DEG, min(c.BASE_LIMIT_DEG, self.base_deg + total)))

        # 只记录不影响流程：bench.py 把这些和人工记录的真实结果放在一起统计
        pos = getattr(self.lift, "pos", None)
        self.last_grasp = {"x_deg": round(m.x_deg, 2), "y": round(m.y, 1), "d": round(m.d, 1),
                           "base_deg": round(self.base_deg, 2), "lift_cm": None if pos is None else round(pos, 2),
                           "t": round(t, 3), "trim_deg": trim}
        if learned or probe_mm:
            self.last_grasp.update({"learned_trim_deg": round(learned, 3), "probe_mm": probe_mm,
                                    "trim_total_deg": round(total, 3)})
        extra = ""
        if learned or probe_mm:
            extra = f"（微调 {total:+.1f}° = 固定 {trim:+.1f}° + 学到 {learned:+.2f}° + 试探 {probe_mm:+.0f}mm）"
        elif trim:
            extra = f"（微调 {trim:+.1f}°）"
        self.say(f"抓取：深度 {m.d:.0f}mm，插值 t={max(0.0, min(1.0, t)):.2f}，底座 {self.base_deg:+.1f}°" + extra)
        self._pushed = None
        self._send({c.CLAW_ID: c.CLAW_OPEN}, 300)
        self._arm({**c.POSES["ready"], c.BASE_ID: bp}, c.ARM_MOVE_MS)
        self._arm({**reach, c.BASE_ID: bp}, c.ARM_SLOW_MS, scale=False)    # 伸向物块：保持慢速
        self._send({c.CLAW_ID: c.CLAW_CLOSE}, 500)

        verify = c.VERIFY
        m_before = self.measure() if verify in ("lift_check", "auto") else None
        self.lift.move_by(c.LIFT_AFTER_GRASP_CM)
        self._lifted = True
        m_after = self.measure() if verify in ("lift_check", "auto") else None
        if not (verify == "observe" and c.VERIFY_SKIP_CARRY):     # 任务 13：observe 确认前的 carry 可以省掉
            self._arm({**c.POSES["carry"], c.BASE_ID: bp}, c.ARM_MOVE_MS)

        if verify == "none":
            return True
        if verify == "observe":                  # 只做观察确认（爪子在画面里时抬升确认会被骗）
            return self._observe_check(bp)
        ok = self._lift_check(m_before, m_after)
        if ok is None and verify == "auto":
            ok = self._observe_check(bp)
        if ok is None:
            self.say("确认：无法判断，按成功处理")
            return True
        return ok

    def goal_for(self, m):
        """
        对准目标。没有底盘时深度没法对准，物块在近/远两个标定姿态之间时，
        目标的 Y 和方位角也要按深度插值（物块越远，在画面里越靠上），否则升降轴会对到错误的高度。
        有底盘时底盘会把深度对到 GOAL，用固定的 GOAL。
        """
        c = self.cfg
        g, gf = c.GOAL, getattr(c, "GOAL_FAR", None)
        if c.USE_CHASSIS or not gf or m is None or gf["d"] == g["d"]:
            return g
        gm = getattr(c, "GOAL_MID", None)
        if gm and min(g["d"], gf["d"]) < gm["d"] < max(g["d"], gf["d"]):
            # 任务 09：标了中间点就分段插值（近-中、中-远）
            a, b = (g, gm) if (m.d - gm["d"]) * (g["d"] - gm["d"]) >= 0 else (gm, gf)
            t = max(0.0, min(1.0, (m.d - a["d"]) / (b["d"] - a["d"])))
            return {"x_deg": a["x_deg"] + (b["x_deg"] - a["x_deg"]) * t,
                    "y": a["y"] + (b["y"] - a["y"]) * t, "d": m.d}
        t = max(0.0, min(1.0, (m.d - g["d"]) / (gf["d"] - g["d"])))
        return {"x_deg": g["x_deg"] + (gf["x_deg"] - g["x_deg"]) * t,
                "y": g["y"] + (gf["y"] - g["y"]) * t,
                "d": m.d}                         # 深度不对准（够不够得着由 reachable 判断）

    def reach_range(self):
        """机械臂（不靠底盘）能抓到的物块深度范围 (近, 远)，单位 mm"""
        c = self.cfg
        if c.POSES.get("reach_near") == c.POSES.get("reach_far"):
            lo = hi = c.GOAL["d"]                    # 只标定了一个伸出姿态：只能抓 GOAL 那个深度
        else:
            lo, hi = sorted((c.REACH_NEAR_D, c.REACH_FAR_D))
        return lo - c.REACH_MARGIN_MM, hi + c.REACH_MARGIN_MM

    def reachable(self, m):
        """没有底盘时深度不会被对准：物块超出臂展就不去抓（抓了也是空抓）"""
        if self.cfg.USE_CHASSIS:
            return True
        lo, hi = self.reach_range()
        if lo <= m.d <= hi:
            return True
        hint = "往前推近一点" if m.d > hi else "往后挪远一点"
        self.say(f"够不着：物块深度 {m.d:.0f}mm，机械臂只能抓 {lo:.0f}~{hi:.0f}mm。请把物块{hint}，"
                 f"或者去掉 --no-chassis 让底盘去对准")
        return False

    def _lift_check(self, m_before, m_after):
        """抬升确认：抓到了物块跟着相机走（y 不变）；没抓到物块留在原地（y 变大或看不见）。None = 判断不了"""
        c = self.cfg
        if m_before is None:
            self.say("抬升确认：伸出后看不到物块（离得太近、碰到画面边缘），判断不了")
            return None
        if m_after is None:
            self.say("抬升确认：抬起后物块不见了（留在原地）→ 没抓到")
            return False
        dy = m_after.y - m_before.y
        ok = abs(dy) < c.VERIFY_DY_MM
        self.say(f"抬升确认：抬升后物块在画面里移动 {dy:+.1f}mm → {'抓到' if ok else '没抓到'}")
        return ok

    def _observe_check(self, bp):
        """
        观察确认：爪子保持闭合，退回观察姿态、升降轴降回抓取时的高度，看原来的位置还有没有物块。
        还在（和 GOAL 差不多的位置）= 没抓到；不在 = 抓到了。
        """
        c = self.cfg
        ref = getattr(self, "_grasp_ref", None)    # 对准时实际看到的物块位置（没有就用 GOAL）
        g = {"x_deg": ref.x_deg, "y": ref.y, "d": ref.d} if ref is not None else c.GOAL
        self._arm({**c.POSES["observe"], c.BASE_ID: bp}, c.ARM_MOVE_MS)     # 爪子不动
        self.lift.move_by(-c.LIFT_AFTER_GRASP_CM)
        self._lifted = False
        m = self.measure()
        still = (m is not None and abs(m.d - g["d"]) < c.VERIFY_SAME_D_MM
                 and abs(m.x_deg - g["x_deg"]) < 6 and abs(m.y - g["y"]) < 30)
        if c.VERIFY_WHOLE_FRAME and not still:
            still = self._whole_frame_check(m, ref)
        else:
            self.say("观察确认：" + ("原位置还能看到物块 → 没抓到" if still else "原位置没有物块了 → 抓到"))
        if not still:                       # 抓到了：重新抬起、收回，准备放置
            self.lift.move_by(c.LIFT_AFTER_GRASP_CM)
            self._lifted = True
            self._arm({**c.POSES["carry"], c.BASE_ID: bp}, c.ARM_MOVE_MS)
        return not still

    def _whole_frame_check(self, m, ref):
        """
        任务 13（VERIFY_WHOLE_FRAME）：原位置已经没有物块时，再看整个画面。
        画面里别处还有物块 = 被爪子推开了（再测一次，排除一闪而过的误识别）→ 没抓到，记下推开了多远。
        返回 True = 物块还在（没抓到）
        """
        c = self.cfg
        min_d = c.VERIFY_WHOLE_MIN_D_MM

        def usable(x):
            return x is not None and not (min_d > 0 and x.d < min_d)

        if m is not None and not usable(m):
            self.say(f"观察确认：画面里的物块深度只有 {m.d:.0f}mm（< {min_d:.0f}mm，可能是爪子里抓着的），不算")
        if usable(m):
            m2 = self.measure()
            if usable(m2):
                if ref is not None:
                    dx, dy, dd = m2.x - ref.x, m2.y - ref.y, m2.d - ref.d
                else:
                    dx, dy, dd = m2.x, m2.y - c.GOAL["y"], m2.d - c.GOAL["d"]
                self._pushed = (round(dx, 1), round(dy, 1), round(dd, 1))
                self.say(f"观察确认：原位置没有物块，但画面里还有 → 物块被推开了 Δx={dx:+.0f}mm Δy={dy:+.0f}mm "
                         f"Δd={dd:+.0f}mm（x 右为正、d 远为正）→ 没抓到")
                return True
            self.say("观察确认：画面里一闪而过的目标没有复现（误识别），按画面里没有物块处理")
        self.say("观察确认：整个画面都没有物块了 → 抓到")
        return False

    def _lower_back(self):
        """升降轴回到抓取前的高度（只在抬起过时）"""
        if getattr(self, "_lifted", False):
            self.lift.move_by(-self.cfg.LIFT_AFTER_GRASP_CM)
            self._lifted = False

    def place(self):
        c = self.cfg
        drop = c.POSES.get("drop")
        if drop:
            self._arm({c.BASE_ID: self.base_pulse(), **drop}, c.ARM_MOVE_MS, precise=False)
            self._send({c.CLAW_ID: c.CLAW_OPEN}, 400)
        self.go_observe(0)
        self._lower_back()

    def release_and_back_off(self):
        c = self.cfg
        self._send({c.CLAW_ID: c.CLAW_OPEN}, 400)
        self.go_observe()
        self._lower_back()
        if c.USE_CHASSIS:
            self.chassis.forward(-60)        # 退一点再重新看

    # ------------------------------------------------ 一次完整抓取
    def run_once(self):
        c = self.cfg
        self.episode += 1
        t0 = self.clock.now()
        steps = 0
        attempts = 0
        result = "not_found"
        last_err = None
        self.last_grasp = None          # 本次最后一次伸出抓取时的状态（没伸出过就是 None）
        self.last_aligned = None        # 本次最后一次对准结束时的测量

        fails = 0                       # 这个物块伸出抓空了几次（任务 09：决定下一次的左右试探）
        probed = False
        pushes = 0                      # 任务 13：这个物块被爪子推开了几次（VERIFY_WHOLE_FRAME 才会发现）
        self._probe_mm = 0.0
        grasp_d = None
        self.go_observe(0)
        m = self.search()
        while m is not None and attempts < c.MAX_ATTEMPTS:
            attempts += 1
            ok, m_al, n = self.align(m)
            steps += n
            if m_al is not None:
                self.last_aligned = m_al
                last_err = m_al.err(self.goal_for(m_al))
            if not ok and getattr(self, "_abort", None):
                result = self._abort
                self.go_observe()
                break
            if not ok:
                result = "lost" if m_al is None else "align_failed"
                self.go_observe()
                m = self.search()
                continue
            if not self.reachable(m_al):
                result = "out_of_reach"
                break
            steps += 1
            self._probe_mm = self._probe_for(fails)
            probed = probed or bool(self._probe_mm)
            grasp_d = m_al.d
            if self.grasp(m_al):
                result = "success"
                self.place()
                break
            result = "grasp_failed"
            if self._pushed is not None:
                result = "pushed"
                pushes += 1
            fails += 1
            nxt = self._probe_for(fails)
            self.say("抓取失败，松开、退后重试" + (f"（下一次落点试探 {nxt:+.0f}mm）" if nxt else ""))
            self.release_and_back_off()
            m = self.measure() or self.search()

        # 任务 09：按这个物块的结果学习落点微调（没打开 TRIM_LEARN 时什么都不做）
        if grasp_d is not None and self.trim_state is not None and pushes:
            self.say(f"这个物块被推开过 {pushes} 次，落点不可信，不用它学习落点微调")
        elif grasp_d is not None and self.trim_state is not None:
            ok = result == "success"
            self._learn_trim(grasp_d, self._probe_mm if ok else 0.0, getattr(self, "_probe_deg", 0.0), ok)
        if probed:
            self._flip_probe_first()        # 下一个物块第一次试探换一边（GRASP_PROBE_FIRST = "alternate"）
        self._probe_mm = 0.0

        dt = self.clock.now() - t0
        err_norm = 0.0
        if last_err:
            err_norm = sum(abs(last_err[n]) / c.TOL[n] for n in self.axis_names) / len(self.axis_names)
        score = (100.0 if result == "success" else 0.0) - c.SCORE_STEP_COST * steps \
            - c.SCORE_ERR_COST * err_norm - c.SCORE_TIME_COST * dt

        if self.learn and self.learn_path:
            save_axes(self.axes, self.learn_path)
        row = {"episode": self.episode, "result": result, "attempts": attempts, "steps": steps,
               "time_s": round(dt, 1), "err_norm": round(err_norm, 2), "score": round(score, 1),
               **{f"J_{n}": round(a.j, 4) for n, a in self.axes.items()}}
        if c.GRASP_PROBE_MM > 0 or self.trim_state is not None:      # 打开任务 09 的功能时才多记几列
            row["probe_used"] = int(probed)
            row["grasp_d"] = None if grasp_d is None else round(grasp_d, 1)
            row["trim_learned"] = None if grasp_d is None else round(self.learned_trim(grasp_d), 3)
        if c.VERIFY_WHOLE_FRAME:                                     # 任务 13 打开时才多记一列
            row["pushes"] = pushes
        self._append_csv("episodes.csv", row)
        self.say(f"结果：{result}  步数 {steps}  用时 {dt:.1f}s  评分 {score:.1f}")
        return row
