AULAGE/dache/raspberrypi/grasp/research/association.py

"""
数据关联：画面里每条检测轨迹是 目标(T) / 自身(S，爪子脚) / 干扰(D，手等) 的后验递推（任务 11，第 2 项）

核心想法：动作是唯一可信的信号。每走一步（命令 u 已知），比较这条轨迹在动作前后两个测量窗口的位移 Δz：
    T：Δz ~ Σ_h w_h · N(Ĵ_h·Δo_h(u), Var(J_h)·Δo_h² + σ²)   —— 执行器假设库的预测（含迟滞！见 hysteresis_id）
    S：Δz ~ N(0, σ²)                                           —— 与相机固连，不随动作动
    D：Δz ~ N(0, σ_D² + σ²)                                     —— 自己乱动，和 u 无关
    log P_k(c) = log P_{k−1}(c) + log p(Δz_k | c)，归一化后再和先验混一点（ε，允许轨迹身份偶尔出错）
当预测的位移 ≈ 0（命令被死区 / 回差吃掉）时，T 和 S 的似然几乎一样 → 这一步不提供证据，
不会像"两步无响应即停"那样把真目标误判成幽灵。

跨动作的轨迹关联本身也用动作：一条轨迹在下一个窗口里要么"没动"（S/D 假设），要么"按预测动了"（T 假设），
取两者中马氏距离小的那个做门限，所以底座转 20° 后也能接上，不需要像素级的连续跟踪。

对比的基线：task.py 现有的 ghost 规则（GhostRule，照 task.py align() 的阈值复现）。
"""
import itertools
import math
import statistics
from collections import Counter

from . import sim_world  # noqa: F401  （先导入：把 grasp/ 加进 sys.path）
from .hysteresis_id import HysteresisBank

import config as cfg  # noqa: E402
from devices import _median_measure  # noqa: E402
from servo import NOISE, build_axes  # noqa: E402

SIGMA = {"x": 0.3, "y": 1.5}          # 一次测量（窗口中值）的噪声量级（°, mm）—— 和 hysteresis_id.GRID 一致
SIGMA_D = {"x": 3.0, "y": 15.0}       # 干扰物（手）每步自己的位移（估计，和 sim_world.HAND_STEP 一致）
PRIOR = {"T": 0.5, "S": 0.25, "D": 0.25}
FORGET = 0.02
OUTLIER = 0.05                        # 真目标某一步"不合模型"的概率（稳健化）
GOAL = {"x": 0.0, "y": 0.0}           # 对准目标（画面中心；config.GOAL 的 x_deg / y）
TOL = {"x": cfg.TOL["x_deg"], "y": cfg.TOL["y"]}


def _npdf(x, mu, var):
    return math.exp(-0.5 * (x - mu) ** 2 / var) / math.sqrt(2 * math.pi * var)


# ================================================================ 观测：窗口聚类
class WinObs:
    """一个测量窗口里同一个东西的若干次检测，取中值"""
    __slots__ = ("x", "y", "d", "n", "kinds")

    def __init__(self, dets):
        self.x = statistics.median(d.x_deg for d in dets)
        self.y = statistics.median(d.y for d in dets)
        self.d = statistics.median(d.d for d in dets)
        self.n = len(dets)
        self.kinds = Counter((d.oid, d.kind) for d in dets)    # 真值，只用于评估

    @property
    def truth(self):
        return self.kinds.most_common(1)[0][0]


def cluster_window(det_lists, min_n=2):
    """det_lists：每帧一个检测列表 → 窗口内的观测（同一物体在窗口内基本不动，按位置就近聚类）"""
    groups = []
    for dets in det_lists:
        for d in dets:
            for g in groups:
                if abs(d.x_deg - g[0].x_deg) < 2.5 and abs(d.y - g[0].y) < 12 and abs(d.d - g[0].d) < 0.3 * g[0].d:
                    g.append(d)
                    break
            else:
                groups.append([d])
    return [WinObs(g) for g in groups if len(g) >= min_n]


# ================================================================ 轨迹 + 分类
class Track:
    _ids = itertools.count(1)

    def __init__(self, obs):
        self.id = next(Track._ids)
        self.obs = obs
        self.p = dict(PRIOR)
        self.miss = 0
        self.n_upd = 0

    @property
    def x(self):
        return self.obs.x

    @property
    def y(self):
        return self.obs.y


# K230 单目标输出有跟踪器的 EMA 滞后：动作后测到的位移常常只有真实位移的 60~100%（仿真里看到的现象）。
# 对 K230 流把"测到的比例" λ 当成未知量做混合；原始检测框没有滤波，λ = 1
LAGS_K230 = (0.55, 0.7, 0.85, 1.0)
LAGS_RAW = (1.0,)


def like_T(dz, pred, lags=LAGS_RAW):
    """pred：{'x': [(w, mu, var)], 'y': [...]}；两个轴共用同一个 λ"""
    tot = 0.0
    for lam in lags:
        L = 1.0
        for a in ("x", "y"):
            s2 = SIGMA[a] ** 2
            L *= sum(w * _npdf(dz[a], lam * mu, lam * lam * var + s2) for w, mu, var in pred[a])
        tot += L
    return tot / len(lags)


def like_S(dz):
    return _npdf(dz["x"], 0.0, SIGMA["x"] ** 2) * _npdf(dz["y"], 0.0, SIGMA["y"] ** 2)


def like_D(dz):
    return (_npdf(dz["x"], 0.0, SIGMA_D["x"] ** 2 + SIGMA["x"] ** 2)
            * _npdf(dz["y"], 0.0, SIGMA_D["y"] ** 2 + SIGMA["y"] ** 2))


def pred_summary(pred):
    """混合预测 → (均值, 标准差)，用于关联门限"""
    out = {}
    for a in ("x", "y"):
        mu = sum(w * m for w, m, v in pred[a])
        var = sum(w * (v + (m - mu) ** 2) for w, m, v in pred[a])
        out[a] = (mu, math.sqrt(var + SIGMA[a] ** 2))
    return out
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
