AULAGE/dache/(commit log)

2026-11-02 初始化仓库：全自动抓取小车（树莓派总控 + 各下位机固件 + 云端任务说明）
    - raspberrypi/grasp：树莓派总控（视觉伺服、自适应灵敏度、几何前馈、标定工具、离线自测、仿真）
    - 伺服电机控制：升降轴 STM32 固件（新协议）
    - PWM机械臂：机械臂控制板固件（修了总线舵机复位和单字符误触发两个 bug）
    - 底盘代码：WHEELTEC 底盘厂家固件（只读参考）
    - k230_sdcard：K230 实际运行的程序（加心跳）及原版备份
    - CLAUDE.md、docs/cloud_tasks：给云端会话的项目说明和 6 个任务
    - .gitignore 排除 Keil 编译产物；.gitattributes 关闭换行转换（STM32 源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
    [App.c, Bluetooth.c, IR.c, IR.h, PCMsg.c, PWM.c, SysTick.c]
2026-11-02 任务03：底盘固件分析 + 树莓派底盘驱动改进
    - 报告 docs/cloud_tasks/results/03_报告.md：8 个问题逐条回答并给出处（文件:行号）
    主要发现：仓库源码是 Mini 车版本、和真机固件不一致；阿克曼车型不做速度平滑，
    滑行来自增量 PI（滑行∝速度、∝1/电压）；固件没有串口超时停车
    - devices.py：新增 model 松油门方式（默认仍是原来的 tau）、指令过期自动停车、
    退出时直接写停车帧、航向补偿 yaw_trim（默认关）、解析 flag/陀螺仪
    - selftest.py：按固件源码复现的假底盘控制器 + 12 项新测试，全部 48 项通过
    - chassis_test.py：真机停车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
    [chassis_test.py, config.py, devices.py, main.py, selftest.py]
2026-11-02 K230 程序审查与提速（任务 04）：修复旋转框角度回绕/旧框滞留等 bug（开关默认关），结果不变的提速项，离线测试和深度标定工具
    - main.py：新增开关区；FIX_OBB_ANGLE_WRAP / FIX_STALE_OBB / FIX_DEPTH_NONZERO 默认关保持原行为；
    FAST_OBB_POINTS、CACHE_CENTER_COLOR 默认开（输出与原版逐位一致）；OSD_EVERY、PRINT_OBJECT、
    GC_MIN_FREE_KB、REFINE_GRID_CEIL、PROFILE_DETAIL 默认保持原行为；Object: 打印增加像素边长 S
    - tests/：在 CPython 里直接导入真的 main.py（假 CanMV 模块 + numpy 代替 ulab），32 项离线测试
    - tools/depth_fit.py：用多组距离拟合 FOCAL_PIX / DEPTH_OFFSET
    -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
    [main.py]
2026-11-02 任务 02：仿真更真实（7 个真实因素 + 3 个默认关闭的改进开关）
    sim.py 新增（config.py 的 SIM_* 开关，默认开启，全关时与原版逐位一致）：
    1 K230 逐帧 + 与板子同样的 Tracker（滞后、holding 不发帧、2 帧确认、运动模糊）
    2 仿真底盘继承真机 WheeltecChassis，走同一套 drive()，一阶滞后假控制器会滑行
    3 底座舵机死区 / 回差
    4 伸出时小偏差把物块推开 10~30mm
    5 尺寸法测深：像素噪声 + 每台车固定框偏差，误差随距离平方增长
    6 机械臂 CH340 掉线 0.5~2s，走真机 Arm.move 重连逻辑
    7 误识别假目标
    仿真发现的问题，对应改进（默认关闭 = 原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
    [config.py, devices.py, main.py, selftest.py, sim.py, sim_compare.py, task.py]
2026-11-03 机械臂固件：UART1 单字符点动默认关闭；UART3 帧内字节不再误触发点动
    - PCMsg.c：新增 UART1_CHAR_JOG（默认 0）。树莓派只发 0x55 0x55 二进制帧，
    USB 断开重连时线上的乱码不应该推动舵机；需要旧的单字符点动时改成 1
    - Bluetooth.c：和之前 UART1 的修复一样，二进制帧里的字节不再被当成 '1'~'6' 点动；
    蓝牙 App 的单字符点动功能保留
    - Keil 编译 0 错误（5 个警告是原来就有的）
    [Bluetooth.c, Bluetooth_original.c, PCMsg.c, PCMsg_before_jogswitch.c]
2026-11-03 calib.py 新增 shake：用 K230 读数测量机械臂静止时的抖动幅度
2026-11-03 K230：保留只加了心跳的版本作为备用（新版在板子上出问题时换回）
2026-11-03 机械臂串口自动选择：优先用 J-Link 虚拟串口（机械臂板自带 USB 识别失败），其次 USB 口 1.3
2026-11-03 config 新增 power_on 姿态（固件上电初值），用 calib.py jog power_on 找不抖、最省力的上电姿态
2026-11-03 云端任务 07：机械臂最省力的上电姿态（静力学模型），附测量参数模板
2026-11-03 任务 07 参数：用户实测的连杆长度、LDX-218 舵机、按总重约 500g 估计的各节质量；修正关节顺序
2026-11-03 机械臂固件：上电姿态改为 arm.txt 初始姿态（1:1500 2:1500 3:758 4:601 5:1185 6:1500）
    原来上电时 3/4/5 = 500，4 号顶到机械限位剧烈抖动。说明：5517639 里已经带进了
    一版中间改动（爪子 500），那次提交信息漏写了；这里改成最终值（爪子 1500 停在行程中间）。
    原版在 backup_机械臂原版_20261102/PWM_original.c。Keil 编译 0 错误。
2026-11-03 calib.py：jog 每次动作后显示 K230 读数；auto 识别相机在底座转轴附近（比值<1）并保存底座灵敏度
2026-11-03 搜索前先原地看一眼（SEARCH_LOOK_FIRST，看到时一律复核防误识别）；无底盘时不必先把升降轴升到 25cm
2026-11-03 无底盘时物块超出臂展就不抓，提示可抓深度范围（REACH_MARGIN_MM）
    第一次真机抓取：物块在 230mm、标定抓取深度 152mm，--no-chassis 下深度没法对准，原来会硬抓（空抓）。
2026-11-03 无底盘时对准目标按深度在近/远标定点之间插值（GOAL / GOAL_FAR）；观察确认改用对准时的实际位置作参照
    真机标定：近 156mm Y=+70，远 216mm Y=+43。原来不管多远都对准 Y=70，物块在远处时升降轴会偏约 4.5cm。
2026-11-03 selftest 不受每台车 calib.json 影响（GRASP_IGNORE_CALIB）；覆盖测试改用临时文件，在有真实标定的树莓派上也能测
2026-11-03 对准保护：读数不随动作变化（识别到机械臂自己）就停；升降轴到头就停；新增 VERIFY=observe
    真机：K230 把爪子等跟着相机动的东西当成物块——底座转到 +69° 方位角不变、升降轴累计降 10cm Y 不变、
    抬升确认永远判抓到。现在两步内判定 ghost 并停止；steps.csv 记录升降轴高度。
2026-11-03 新增 OBSERVE_CLAW：观察/对准时爪子可以合上（张开时爪子脚伸进画面，K230 跟踪器可能锁住它）
2026-11-03 抓取左右微调 GRASP_BASE_TRIM_DEG（calib.py trim <偏右mm>）；CSV 列变化时旧文件改名留档（修复 steps.csv 错位）
    真机：对准误差已在容差内、爪子落点却系统性偏右（可能是爪子脚挡住物块左侧，K230 框中心偏右）。
    [calib.py, config.py, task.py]
2026-11-03 calib.py teach：可以只标 near / far；标定前检查升降轴高度留余量；teach 里点动复用 K230 连接（原来两个线程抢同一个串口）
2026-11-03 修复：calib.py 保存后立即重新加载配置（teach 里点动保存 reach 姿态后又伸回旧姿态）
    [calib.py]
2026-11-03 升降轴到最低/最高点后剩余高度误差在 LIFT_LIMIT_SLACK_MM（15mm）内就照样去抓
    真机：地上的物块只有升降轴在 0cm 时机械臂才够得着，读数稍有波动就会误报 lift_limit。
2026-11-03 抓取与调试方案 v2（第一天真机联调后）；云端任务 08 试验记录工具、09 抓取精度、10 K230 忽略爪子脚；CLAUDE.md 加真机现状
2026-11-03 任务 08：真机试验记录工具 bench.py
    - bench.py：按测试矩阵（近/中/远 × 左/中/右）提示放物块 → 走 main.py 同一套代码抓一次 →
    问真实结果、偏差方向和毫米 → 记到 logs/bench.csv；支持 --positions/--repeat/--resume/--chassis/--sim，
    Ctrl+C 升降轴急停、已完成的已记录
    - bench.py report：按位置的真实成功率、误报、平均偏差、程序结果 vs 真实结果，并给出调参建议
    - main.py：把设备装到任务上的部分抽成 attach_task()，命令行行为不变
    - task.py：只新增记录 last_grasp / last_aligned，流程不变
    - selftest.py：新增 test_bench（18 项），全部 89 项通过
    - RE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
2026-11-03 论文研究方案 v1（以动作为测量：无反馈低成本移动机械臂的视觉本体感知与精准抓取）；云端任务 11 动作-响应模型原型
2026-11-03 论文研究方案 v2：无本体感知机器人的自监督具身世界模型（深度学习 + 具身智能）
2026-11-03 任务 11 说明对齐方案 v2
2026-11-03 任务 08 合并完成，更新任务索引
2026-11-03 任务 10：K230 忽略爪子脚区域 + 树莓派 ghost 指纹
    K230（k230_sdcard/main.py）：
    - 新增 IGNORE_REGIONS（显示画面 0~1 归一化矩形，默认左侧中间）和 IGNORE_REGIONS_ENABLE（默认开）
    - 中心落在区域里的检测框在 tracker.select 之前丢掉；锁定目标进入区域立即放弃
    - OSD 上用红色虚线框画出区域；IGNORE_CALIB_MODE 打印每个检测框的归一化中心/大小和建议区域
    - 离线测试固定"归一化区域 <-> 原始像素"的换算（三种 ROTATE_DEG）
    树莓派（raspberrypi/grasp）：
    - 新增 GHOST_FINGERPRINT（默认关）：align 判 ghost 时把读数记到 logs/ghosts.json，
    之后接近指纹的读数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
2026-11-03 任务 11：动作-响应模型原型（仿真验证）
    - raspberrypi/grasp/research/：仿真世界（复用 sim.py 的框噪声、K230 跟踪器、舵机迟滞）、
    P(目标/自身/干扰) 关联、(J, 回差, 死区) 在线辨识 + 逆迟滞补偿、结果监督残差标定、实验脚本和单元测试
    - selftest.py：新增可选的 `selftest.py research`，默认行为不变
    - 报告 docs/cloud_tasks/results/11_报告.md（全部为仿真结论，未在真机验证）
    Claude-Session: https://claude.ai/code/session_01N87t3hzu7xx7wTK5kC964W
2026-11-03 任务 09：抓取精度——底座消回差、失败左右试探、按深度学习落点微调、三点插值
    - task.py：底座指令统一走 _arm()（BASE_BACKLASH_DEG 消回差、BASE_APPROACH_DIR 逼近方向）；
    BASE_MIN_STEP_DEG 最小有效步长（不冲出容差另一边）；失败重试时 GRASP_PROBE_MM 左右交替试探；
    TRIM_LEARN 按深度三段学习落点微调（存 logs/learned_trim.json，限幅 TRIM_MAX_DEG）；
    可选 reach_mid / REACH_MID_D / GOAL_MID 三点分段插值
    - calib.py：teach mid / teach mid off；trim 显示学到的分段微调，trim forget 清掉
    - sim.py：落点横向偏差、横向容差、伸出时底座被推到回差一侧、中间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
2026-11-03 论文数据记录器 recorder.py（main.py --record / GRASP_RECORD=1）：动作命令 + K230 每帧带时间戳；离线抽动作-响应样本对、统计底座回差；任务 12 说明
    记录不改变行为（同种子仿真结果逐项相同），test_recorder.py 16 项、selftest.py 89 项通过。未在真机验证。
2026-11-03 任务 12：同步线改用 uart3 TX（GPIO4）；更新任务进度
2026-11-03 云端任务 13 提速与防误报、14 世界模型合成数据原型、15 文献调研；12 可以开始
2026-11-03 ROBOTAC 比赛材料：设计报告 v2 草稿（新系统）、拍摄清单 v2
2026-11-03 云端任务 16 演示模式与网页看板、17 上车前代码审查、18 底盘联调预演
2026-11-03 任务 15：论文文献调研、创新点核查、投稿期刊分析、相关工作草稿
    - docs/论文文献调研.md：78 条文献表（8 个主题）、12 条创新点逐条核查、
    8 个期刊分析、对研究方案的修改建议（未直接改方案）
    - docs/论文相关工作草稿.md：按主题分 8 段，每段结尾"本文的区别"
    - docs/references.bib：只收检索核实过的 61 条
    说明：云端会话网络策略拦截 arxiv.org 等站点，无法直接打开原文；
    核实方式为网络检索到原文所在页面并核对标题/作者/年份/出处，未读全文。
    部分核实和未核实的条目已在文档中逐条标注。只写文档，未改代码。
    Co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
2026-11-03 任务 12：K230 存图 + 树莓派同步标记 + 离线对齐工具（默认全部关闭）
    - K230（k230_sdcard/main.py）：IMAGE_LOG_ENABLE（默认 False）打开后，把送进 AI 的图缩小到 320x180 存 JPEG
    （按顺序试板子上的编码接口，都不行退回原始 RGB），每帧写 frames.csv（K230 时钟、全部检测框、跟踪器状态、
    发出去的帧），从 UART1 RX 不阻塞地接收 "SYNC <序号> <树莓派时间>" 写 sync.csv；SD 卡快满自动停存图
    - 新增 k230_sdcard/tools/raw2png.py（原始 RGB 转 PNG）
    - 树莓派：config.K230_SYNC_PORT（默认 None，加入 CALIB_KEYS），--record 时每秒和每条命令前后发同步标记并记进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
2026-11-03 任务 13：抓取提速 + 整画面确认防误报 + 底座 J 同向才学（默认全关，仿真验证，未在真机验证）
    - config：VERIFY_WHOLE_FRAME / VERIFY_WHOLE_MIN_D_MM / VERIFY_SKIP_CARRY / ARM_MOVE_SCALE /
    ARM_MS_PER_US / ARM_MIN_MS / LEARN_SAME_DIR_ONLY，加进 CALIB_KEYS；仿真 SIM_CLAW_PUSH_*（默认关）
    - task：机械臂指令统一走 _send（按脉宽差缩放动作时间，伸出一步不缩放）；observe 确认可去掉 carry；
    整画面确认发现"物块被推开"，结果 pushed，任务 09 学习跳过；底座 J 只在同向时学习
    - sim：合爪没夹住时推开物块模型（独立随机数流）
    - sim_speed_verify.py：对比表；selftest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
2026-11-03 修复：升降轴复位（READY）后不再自动接着跑
    升降轴下位机断电重启（RST POR）后固件认为自己在 0cm，滑台实际可能在半空；
    原来 READY 被当成普通 DeviceError，main.py 一直抓模式 3 秒后重开设备接着跑、
    bench.py 下一个位置也接着测，会按错的零点让滑台往上多走、撞到顶。
    - devices.py：READY 抛 DeviceResetError（DeviceError 的子类，旧的 except 仍能接住）
    - main.py run_real：收到 DeviceResetError 打印原因和处理办法后正常退出（不重开设备；
    退出码 0，grasp.service 的 Restart=on-failure 也不会把它拉起来）
    - bench.py：同样停止，不再记 device_error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
    [bench.py, devices.py, main.py, test_review.py]
2026-11-03 任务 16：比赛演示模式 demo.py + 实时网页看板 dashboard.py
    - dashboard.py：http.server + SSE 看板（阶段、K230 读数、对准误差条、升降/底座、计数、日志、J），只看不改
    - demo.py：连续抓取、大号状态行、统计、可选语音播报、Ctrl+C 安全停止；复用 main.py 和 GraspTask.run_once
    - main.py：attach_task 新增 dashboard/monitor 参数和 --dashboard 开关（默认关）
    - config.py：DASHBOARD_PORT / DEMO_AUTO_INTERVAL_S / DEMO_TTS_CMD（默认关，加入白名单）
    - test_demo.py 离线测试 36 项；报告 docs/cloud_tasks/results/16_报告.md（未在真机验证）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
2026-11-03 修复：systemctl stop / SSH 断开时也走停车流程
    SIGTERM（systemctl stop grasp）和 SIGHUP（SSH 断开，README 里说经常发生）的默认处理是
    直接结束进程，不走 finally / atexit。底盘固件没有串口超时，进程被杀时最后发的是行驶帧，
    车会一直按这个速度跑；升降轴也收不到急停。
    main.py 新增 install_stop_signals()：把这两个信号变成 KeyboardInterrupt，走和 Ctrl+C 一样的
    停车流程。main.py 真机运行、bench.py 真机、chassis_test.py 启动时调用（仿真不调用）。
    test_review.py：子进程里模拟底盘行驶中收到信号，检查最后一帧是停车帧。
    未在真机验证。
    Co-A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
    [bench.py, chassis_test.py, main.py, test_review.py]
2026-11-03 修复：底盘行驶中回传中断时立即停车
    WheeltecChassis.drive() 有回传时按回传积分的里程判断走够没有。行驶中回传断了（USB 半掉、
    控制器回传卡住）里程就不再增加，原逻辑会以全速一直发指令到超时：400mm 的一步超时约 23 秒，
    最多能多开 2 米。现在行驶中 0.5 秒（和 has_feedback 同一个标准）没收到状态帧就报
    DeviceError，finally 里照常发 0。仿真（SimWheeltec.has_feedback 恒为 True）不受影响。
    Claude-Session: https://claude.ai/code/session_01N87t3gNUqHKeTZZtL913Hh
    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
    [devices.py, test_review.py]
2026-11-03 修复：一直抓模式下串口异常 / 重开设备失败不再直接退出
    - run_real 只接 DeviceError，但 pyserial 的 SerialException 是 OSError（升降轴 USB 掉线时
    readline/write 抛的就是它），会带堆栈冲出主循环；改成和 DeviceError 一样关设备、3 秒后重开
    - 重开设备（已经通过启动检查之后）失败时等 3 秒再试，不退出；第一次打开失败、--once 仍按原样报错
    - open_devices 中途失败时把已经打开的设备关掉：否则重开后旧 K230 读线程和新的抢同一个串口
    - bench.py 的 RealRig 同样接住 OSError
    Claude-Session: https://claude.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
    [bench.py, main.py, test_review.py]
2026-11-03 任务 18 安全修复：底盘危险动作的最小修复（仿真发现，未在真机验证）
    1. GHOST_CHECK_D（默认开）：对准时底盘走了一段、深度读数几乎不变，连续 2 次判 ghost 停。
    原来开车那一步不查，K230 把爪子当成物块时底盘会一直开（仿真 25 步 5.2m）
    2. SEARCH_CONFIRM_CHASSIS（默认开）：有底盘时搜索到的目标一律复核。不复核时误识别会让
    底盘朝空处一步开 400mm、开到物块跟前（会撞平台）。无底盘不受影响
    3. SEARCH_BACKOFF_MAX_MM = 500：找到目标以前搜索累计后退上限。原来 main.py 连续运行、
    周围没物块时每次退 250mm 一直倒下去
    4.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
    [config.py, devices.py, main.py, task.py]
2026-11-03 任务 18 安全修复：底盘走完一步后深度读数和里程对不上时先确认（仿真发现，未在真机验证）
    CHASSIS_JUMP_CHECK（默认开）：底盘走了 moved 以后，深度误差变化和按里程预测的差
    超过 max(CHASSIS_JUMP_D_MM=80, 里程的一半) → 原地再确认一次目标，确认不了按丢失处理。
    原来照着跳变的读数再开一大步：仿真里 K230 误读深度跳大 150mm 时，车中途开过头 330mm
    （物块在 535mm 的场景开到离底座转轴 10mm，真机会撞平台）。
    另外把 SEARCH_BASE_DEG 加进 CALIB_KEYS（行为不变）：K230 画面转了 90°，水平半视场约 21°，
    默认 [0, ±55, ±85] 在 21°~34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
    [config.py, task.py]
2026-11-03 任务 17：上车前代码审查报告和复现测试
    - docs/cloud_tasks/results/17_报告.md：问题清单（伤硬件 / 抓错 / 报错退出 / 体验，按严重程度）、
    各异常路径的最终状态、真机标定值代入检查、K230 程序检查、明天真机的风险清单
    - test_review.py：补上 Ctrl+C 逐阶段注入测试，以及只报告没修的问题的复现用例
    （底座死区 + ghost 指纹把真物块记成指纹、reach_pose 除零、calib.json 部分 TOL、升降轴上限截断）
    全部只在仿真 / 假串口上验证，未在真机验证。
    Claude-Session: https://claude.ai/code/session_01N87t3g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
    [test_review.py]
2026-11-03 任务 18：chassis_test.py 补全 + 有底盘联调预演测试 test_chassis_rehearsal.py
    chassis_test.py（真机脚本，云端只用 selftest 的固件假控制器干跑过）：
    - --voltage 只读电压 / flag / 陀螺仪
    - --hang 架空测试：指令过期、close()、SIGTERM 三种停车
    - --ruler 默认 ±100/±200mm 各 3 次，尺子读数拟合滑行 τ、里程计比例；--write 写 calib.json
    （CHASSIS_PI_TAU_S）和 logs/chassis_tau.json
    - --radius 左右打满方向走弧，弦长 + 侧移 → 最小转弯半径；--write 写 ACK_MIN_RADIUS_MM
    - 纯计算函数（拟合、半径、写 calib）可离线测试
    test_chassis_rehearsal.py：sim.SimWheeltec 跑有底盘场景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
2026-11-03 任务 14（进行中）：世界模型原型——合成渲染器、数据集、模型、训练与评估代码（合成数据，结果待补）
    Claude-Session: https://claude.ai/code/session_01N87t3jDbPB4szXKyhz3WR3
2026-11-03 任务 18：底盘联调手册 + 报告
    - docs/底盘联调手册.md：安全规则、第 0~8 步（命令 / 预期 / 通过标准 / 出问题怎么处理）、
    防撞平台的几何检查、11/9 晚"用不用底盘"的决策标准、记录表
    - docs/cloud_tasks/results/18_报告.md：代码路径审查、有底盘场景统计、6 个危险动作及修复、
    测试结果、未在真机验证的清单
    - README / 抓取与调试方案第 4 节指向手册
    Claude-Session: https://claude.ai/code/session_01N87t3gEY6YkFTKHqMNgyDa
2026-11-03 云端任务 19：比赛材料生成；比赛材料模板（旧版报告、概要表、PPT 去视频版、图片）
2026-11-03 任务 19：比赛材料一键生成（设计报告 docx + 答辩 PPT + 作品信息概要表）
    - docs/robotac/build/build_materials.py：按旧版模板样式生成三份文件，data.json 没填的字段显示黄色占位，输出缺项清单
    - figures.py：系统总体架构图、自适应视觉伺服流程图
    - data.json 模板（真机数据、bench、视频照片、核对事实、开关）；仿真数字标注“仿真”，不含编造的实测数据
    - 设计报告草稿补全：沿用旧版的段落、17/18 安全修复、16 看板、测试章节数据表
    - 答辩问答准备 26 题；样例输出（占位数据）在 build/sample/
    未在 Windows + Office 上打开验证，只用 p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
2026-11-03 任务 14（进行中）：解码器局部性先验、平移预测损失、物理先验 A·Δ命令、光照归一化；试跑结果（合成数据）
    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
2026-11-03 任务 14（进行中）：完整模型 15 分钟训练的中间结果（合成数据；完整训练正在重跑）
    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
2026-11-03 任务 14：世界模型原型（合成数据）——完整训练结果与报告
    - render/dataset/model/train/eval 在 raspberrypi/grasp/research/worldmodel/，只新建文件
    - 完整模式（4 变体 × 15 分钟 CPU）与 quick 模式（478 秒）的结果、日志、权重（共约 1.7MB）、槽位分割图
    - 结论（合成数据）：H1、H2 在这个训练规模下都未证实；新增随机 GRU 对照和方向记忆规则基线；
    发现像素级分离先验导致整图塌缩
    - 报告 docs/cloud_tasks/results/14_报告.md；原有 selftest 全部通过
    Claude-Session: https://claude.ai/code/session_01N87t3jDbPB4szXKyhz3WR3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
2026-11-04 升降轴丢 DONE 时查询位置（LIFT_DONE_POLL_S）；K230 加爪子张开时的屏蔽小框
    2026-11-04 真机 bench：抓到后下降 5cm 时 3 次 30 秒等不到 DONE（单独测正常）。
    等 DONE 超过 3 秒就发 P，IDLE 按到位；0 = 原行为。selftest 加 2 项。
2026-11-04 无底盘时用像素行（y/d）推算深度（DEPTH_FROM_ROW，默认关）
    2026-11-04 真机录像回放：K230 深度静止时在两个值间跳约 50mm（181/240、203/252），
    y/d 的噪声约为深度的 1/10。按 GOAL、GOAL_FAR 的 y/d 插值深度，X/Y 按新深度重算；
    和 K230 深度差超过 DEPTH_ROW_MAX_JUMP_MM 时用回原值。Measurement 增加 ry/rx。
    selftest 191 项通过，仿真成功率不变（仿真里没有 GOAL_FAR，开关不生效）。
